icecap360/DroneCapstone/src/README.md

# ParkingLotHawk Source Code

The source code is split into 5 main sections:
- CAD/ : contains CAD models of the Drone
- DroneApp/ : contains code that will be run locally on the Drone
- OperatorApp/ : contains code that will be run on the Operator's PC
- SITL/ : contains setup of Software in the Loop environment to faciliate testing of the program
- Utils/ : contains common code used by multiple folders (such as DroneApp and OperatorApp)  

A detailed module guide can be found within the [Repository File Guide](https://github.com/icecap360/DroneCapstone/blob/master/RepositoryFileGuide.pdf).
