icecap360/DroneCapstone/src/CAD/README.md

# CAD

This folder contains all the CAD files used to design and fabricate the frame of the drone.  

CAD software used: Solidworks 2019
