icecap360/DroneCapstone/refs/README.md

# ParkingLotHawk: Reference Information

This folder holds information and resources of interest for the project.  This
is intended to be a convenient location for project members to access
support material for the project.

For LaTeX files references are put in the References.bib file for processing by
BibTeX.  A nice convention for naming the references is to use the Nat Bib
convention.  That is, the citation name, and the corresponding file name should
be in the format AuthorYear.  If there is two author's the name should be
Author1Author2Year.  For more than two authors, the name should be
Author1EtAlYear.  In the preceding text, Author, Author1 and Author2 are the
last names of the authors.
