icecap360/DroneCapstone/docs/Design/SoftDetailedDes/MIS.pdf

## Module Interface Specification for Mechatronics Engineering

Team # 34, ParkingLotHawk
Fady Zekry Hanna
Winnie Trandinh
Muhammad Ali
Muhammad Khan

April 6, 2023

## 1 Revision History

Date | Version | Notes
January 18, 2023 1.0 | Initial Revision
April 5, 2023 | 2.0 | Updating topic interfaces for new topics, split the process methods into process and publish, and updated camera modules for new interface.

i

## 2 Symbols, Abbreviations and Acronyms

symbol | description
AC | Anticipated Change
DAG | Directed Acyclic Graph
M | Module
MG | Module Guide
MIS | Module Interface Specifications
OS | Operating System
R | Requirement
Algo | Algorithms
SRS | Software Requirements Specification
Mechatronics
Engineering
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
