icecap360/DroneCapstone/docs/Design/SystDesign/CamOcc.png

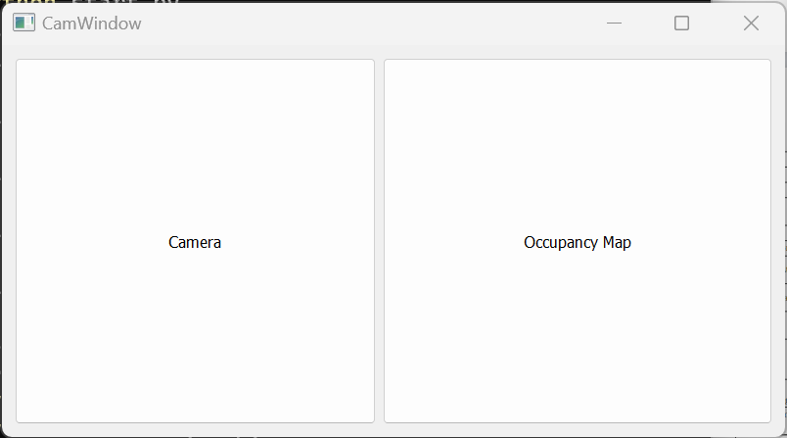
docs/Design/SystDesign/CamOcc.png
