icecap360/DroneCapstone/docs/VnVReport/SegmentationShadow.png

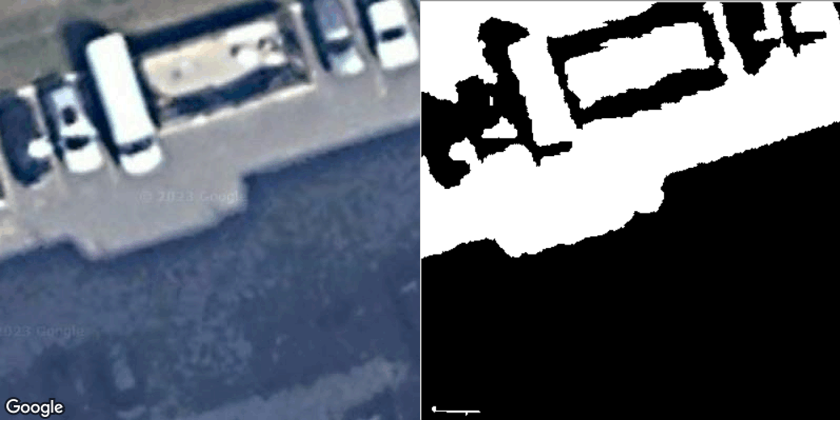
docs/VnVReport/SegmentationShadow.png
