icecap360/DroneCapstone/src/CAD/FlightControllerAssembly.SLDASM

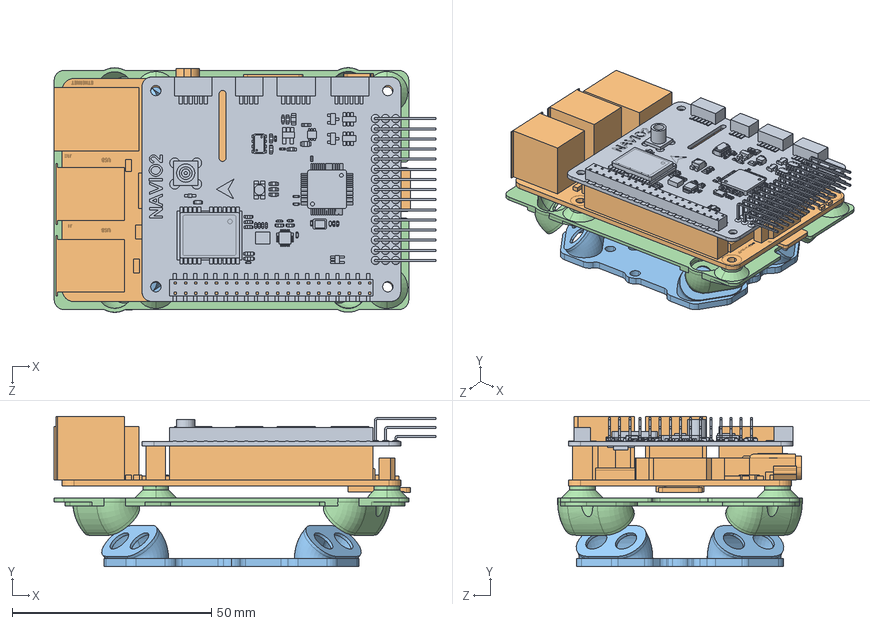
[picture p52: CAD file, 2022-10-10]
src/CAD/FlightControllerAssembly.SLDASM
95.8 x 37.7 x 61.4 mm
Navio2
RPi3B+
VibroNavio2bot_rev_A
VibroNavio2top_rev_A
