icecap360/DroneCapstone/src/CAD/VibroNavio2top_rev_A.SLDPRT

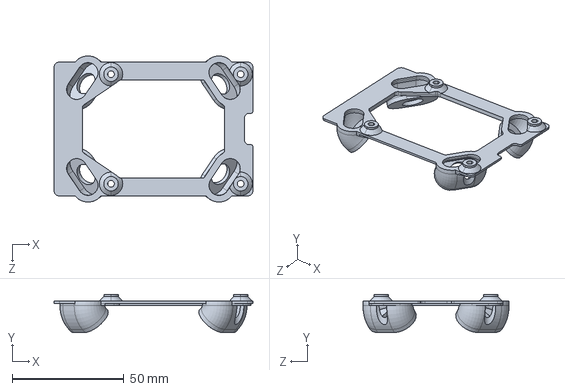
[picture p53: CAD file, 2023-04-05]
src/CAD/VibroNavio2top_rev_A.SLDPRT
89.0 x 17.0 x 65.4 mm
