icecap360/DroneCapstone/src/CAD/Camera.SLDPRT

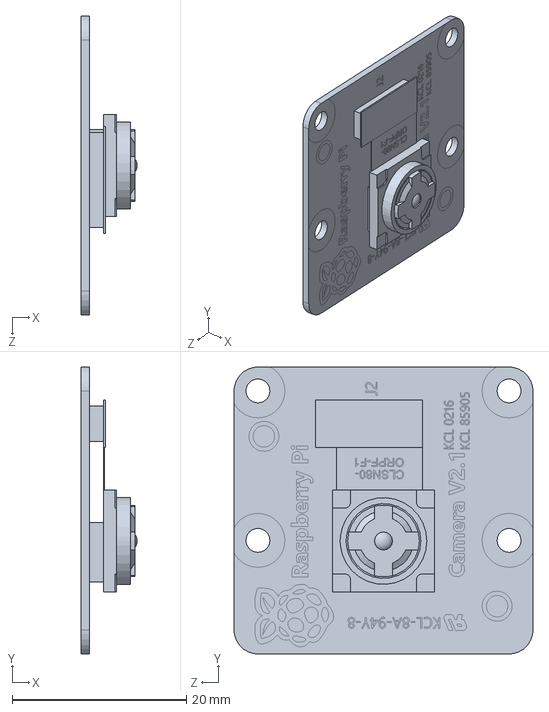
[picture p54: CAD file, 2023-04-05]
src/CAD/Camera.SLDPRT
6.45 x 32.9 x 34.3 mm
