icecap360/DroneCapstone/src/CAD/Mast.SLDPRT

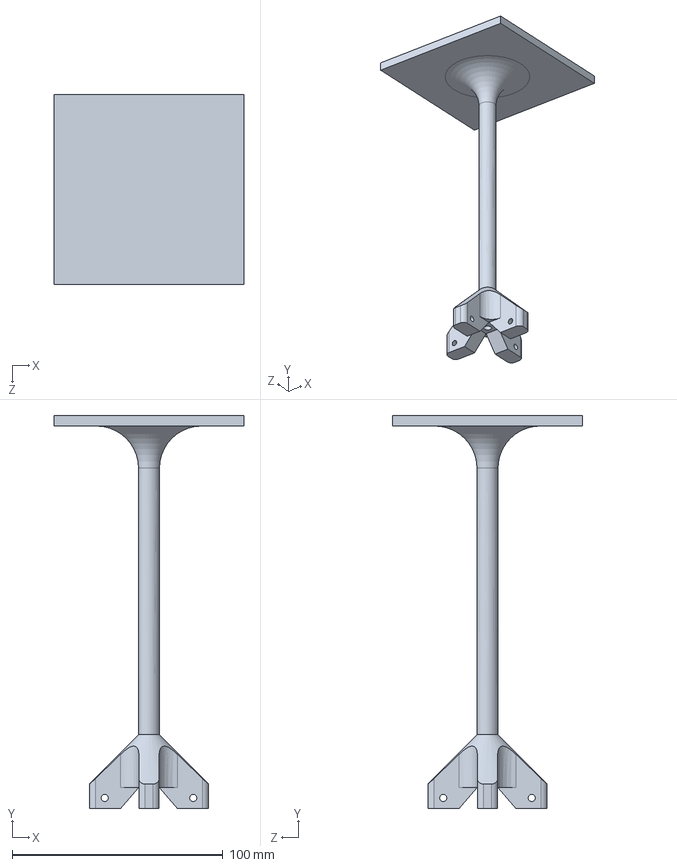
[picture p55: CAD file, 2023-04-05]
src/CAD/Mast.SLDPRT
90.0 x 186.5 x 90.0 mm
