icecap360/DroneCapstone/src/CAD/TopCover.SLDPRT

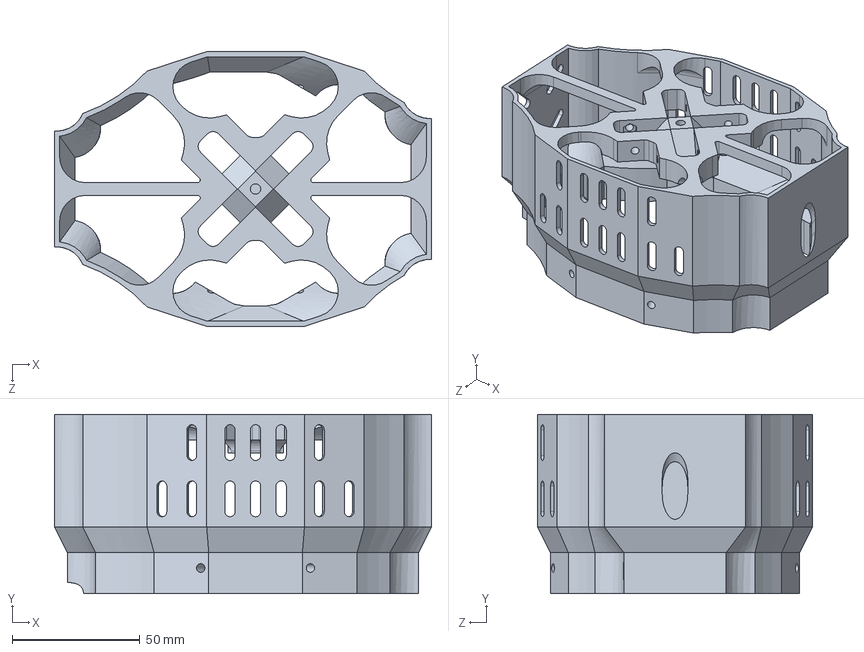
[picture p56: CAD file, 2023-04-05]
src/CAD/TopCover.SLDPRT
147.3 x 70.0 x 107.3 mm
