icecap360/DroneCapstone/src/CAD/FrameArm.SLDPRT

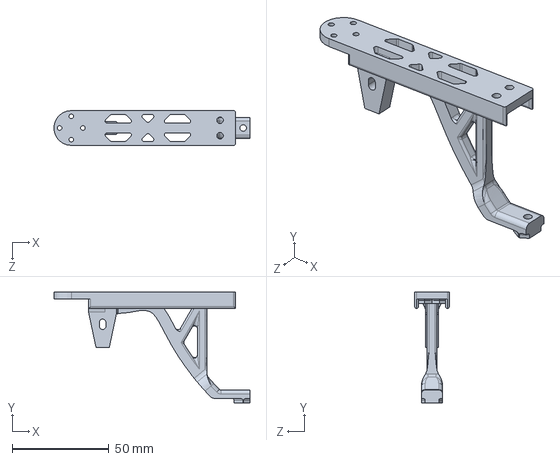
[picture p57: CAD file, 2023-04-05]
src/CAD/FrameArm.SLDPRT
101.4 x 57.4 x 18.0 mm
