icecap360/DroneCapstone/src/CAD/TopPlate.SLDPRT

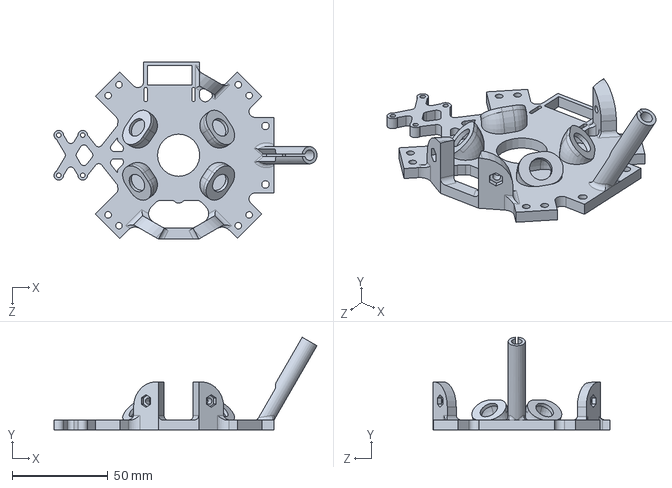
[picture p58: CAD file, 2023-04-05]
src/CAD/TopPlate.SLDPRT
137.1 x 48.3 x 92.4 mm
