icecap360/DroneCapstone/src/CAD/BottomPlate.SLDPRT

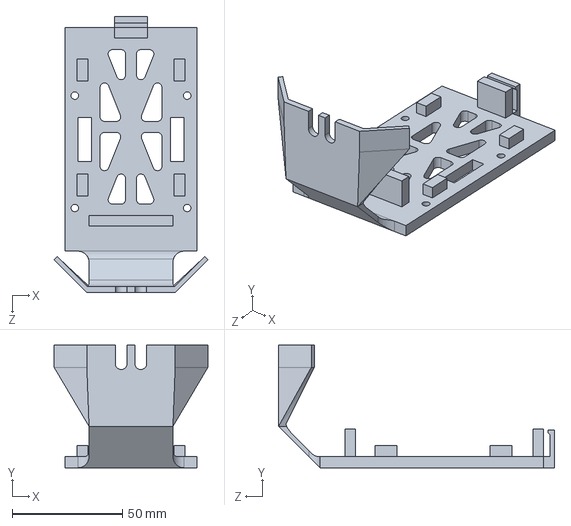
[picture p59: CAD file, 2023-04-05]
src/CAD/BottomPlate.SLDPRT
69.7 x 55.5 x 125.0 mm
