icecap360/DroneCapstone/src/CAD/CameraMount.SLDPRT

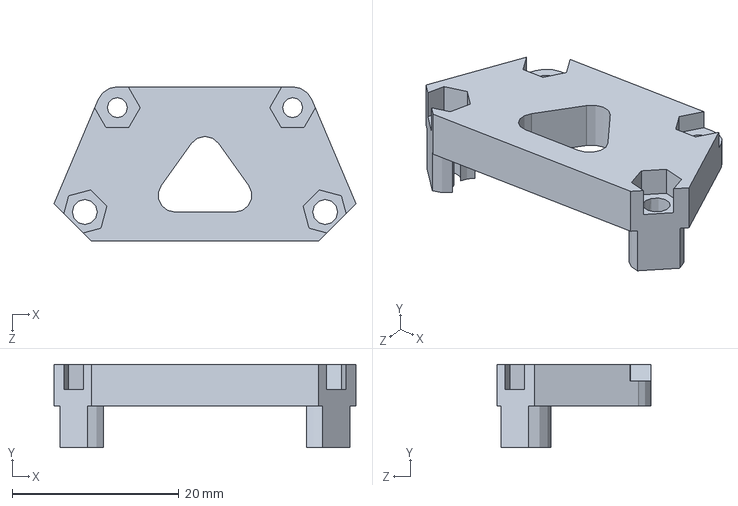
[picture p60: CAD file, 2023-04-05]
src/CAD/CameraMount.SLDPRT
36.2 x 10.0 x 18.5 mm
