icecap360/DroneCapstone/src/CAD/LandingLeg.SLDPRT

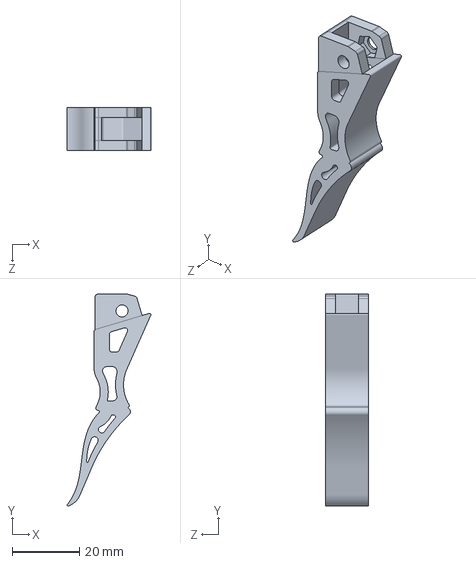
[picture p61: CAD file, 2023-04-05]
src/CAD/LandingLeg.SLDPRT
25.0 x 63.2 x 12.8 mm
