icecap360/DroneCapstone/src/CAD/Antenna.SLDPRT

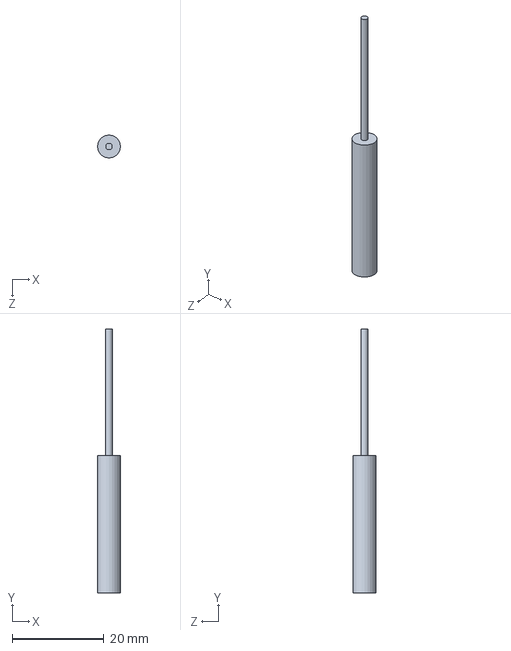
[picture p62: CAD file, 2023-03-20]
src/CAD/Antenna.SLDPRT
5.00 x 57.5 x 5.00 mm
