icecap360/DroneCapstone/src/CAD/Propellor5.1x3.4x3.SLDPRT

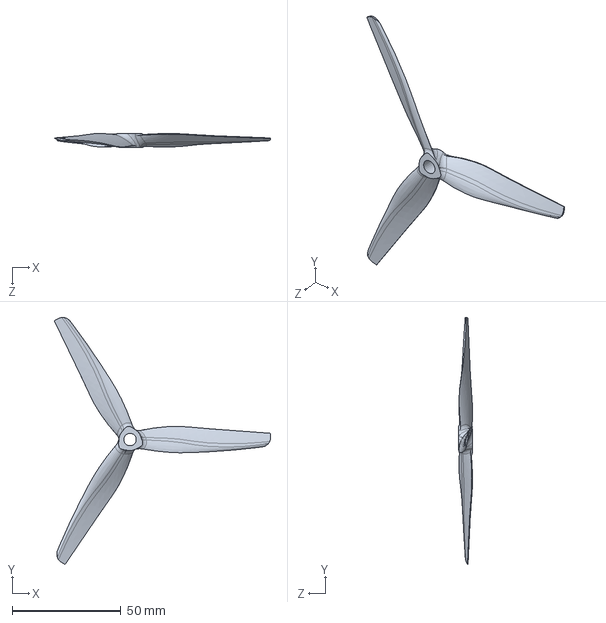
[picture p63: CAD file, 2023-03-20]
src/CAD/Propellor5.1x3.4x3.SLDPRT
99.6 x 113.7 x 6.40 mm
