icecap360/DroneCapstone/src/CAD/Esc.SLDPRT

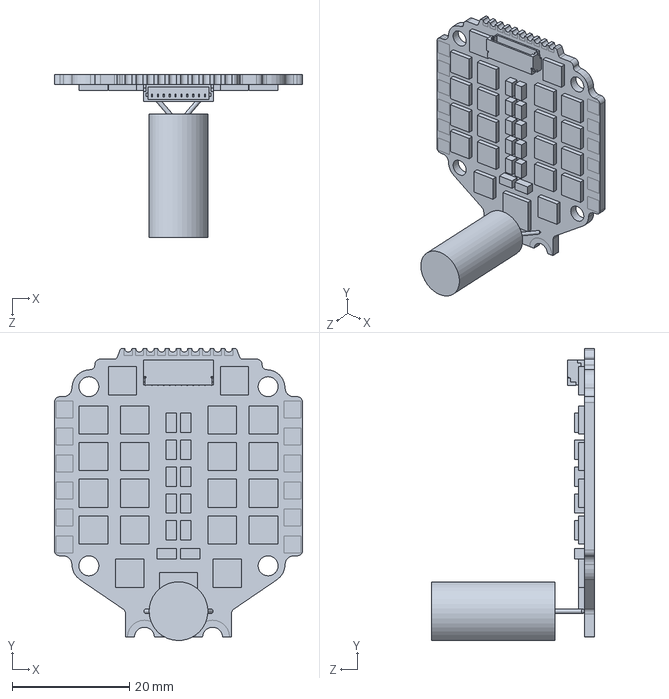
[picture p64: CAD file, 2023-03-20]
src/CAD/Esc.SLDPRT
42.3 x 49.7 x 27.7 mm
