icecap360/DroneCapstone/src/CAD/DampeningBall.SLDPRT

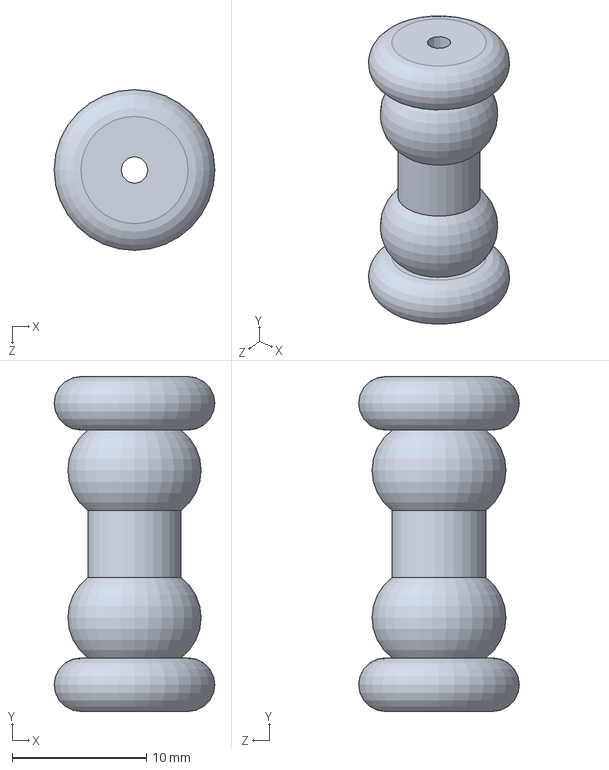
[picture p65: CAD file, 2023-03-20]
src/CAD/DampeningBall.SLDPRT
12.0 x 25.0 x 12.0 mm
