icecap360/DroneCapstone/src/CAD/GPS.SLDPRT

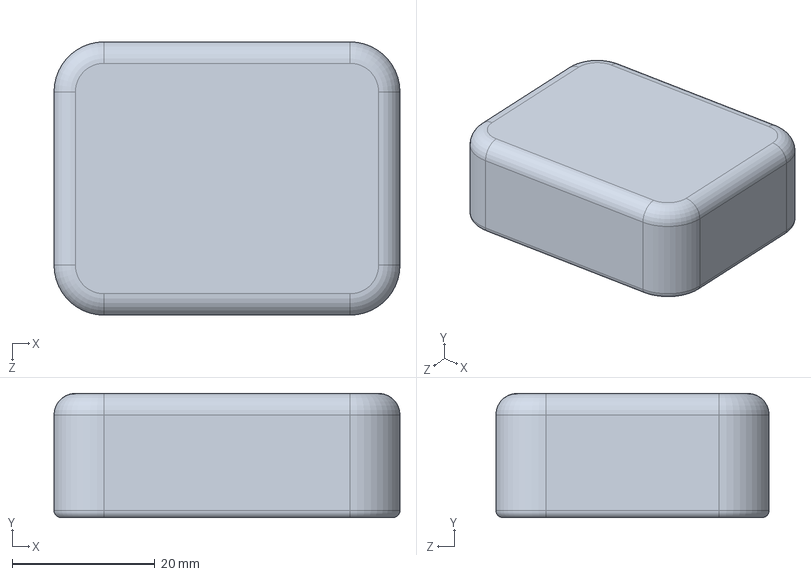
[picture p66: CAD file, 2023-03-20]
src/CAD/GPS.SLDPRT
48.5 x 17.4 x 38.3 mm
