icecap360/DroneCapstone/src/CAD/Spacer.SLDPRT

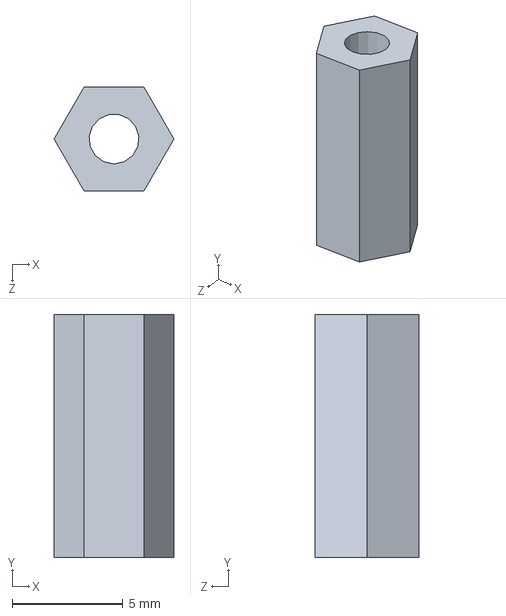
[picture p67: CAD file, 2023-03-20]
src/CAD/Spacer.SLDPRT
5.40 x 10.9 x 4.68 mm
