icecap360/DroneCapstone/src/CAD/RadioReceiver.SLDPRT

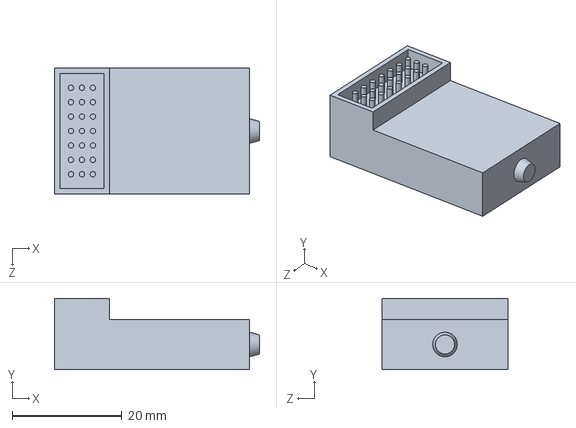
[picture p68: CAD file, 2023-03-20]
src/CAD/RadioReceiver.SLDPRT
37.4 x 13.0 x 23.0 mm
