icecap360/DroneCapstone/src/CAD/SteelRod.SLDPRT

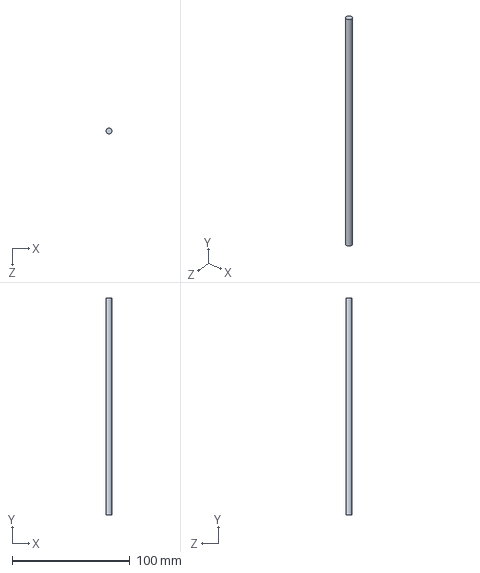
[picture p69: CAD file, 2023-03-20]
src/CAD/SteelRod.SLDPRT
5.00 x 184.5 x 5.00 mm
