icecap360/DroneCapstone/src/CAD/LiPoBattery.SLDPRT

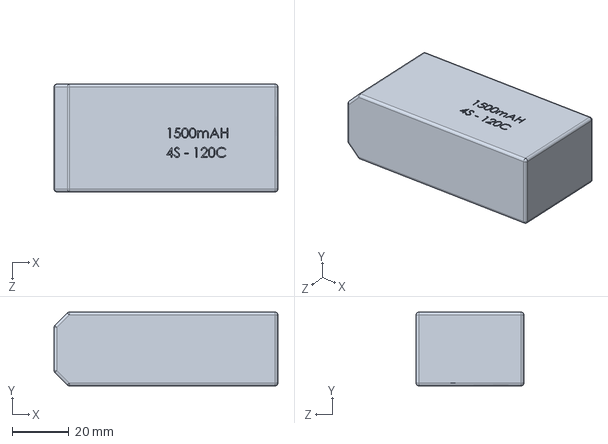
[picture p70: CAD file, 2023-03-20]
src/CAD/LiPoBattery.SLDPRT
79.0 x 26.0 x 38.0 mm
