icecap360/DroneCapstone/src/CAD/VibroNavio2bot_rev_A.SLDPRT

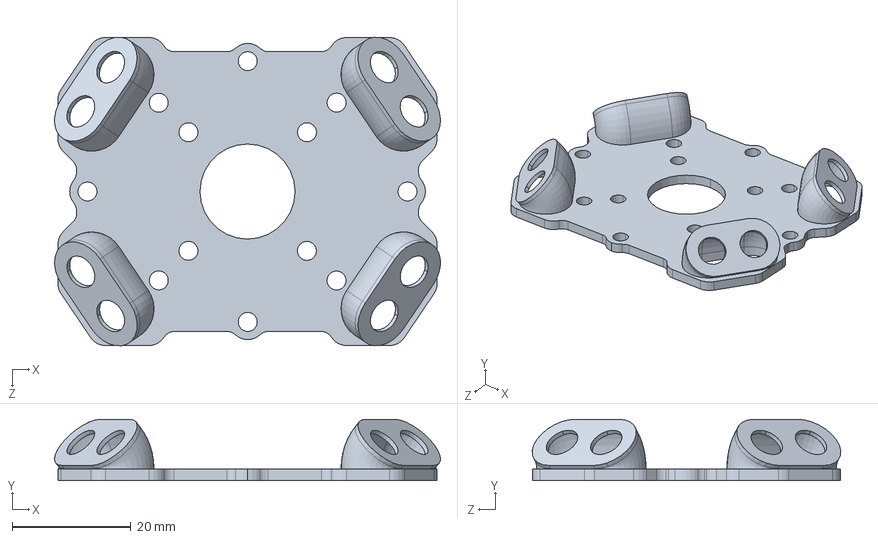
[picture p71: CAD file, 2022-10-11]
src/CAD/VibroNavio2bot_rev_A.SLDPRT
65.1 x 10.4 x 52.1 mm
