icecap360/DroneCapstone/docs/UserManual/README.md

# User Manual

The folders and files for this folder are as follows:

Describe ...
