icecap360/DroneCapstone/test/README.md

# Automated tests

This folder contains testing code during development, in addition to Unit Tests and the KPI Generation Tool.  
Further information on these tests can be found within the VnVPlan document.
