icecap360/DroneCapstone/test/ComputerVision/SegmenterAccuracy.csv

Image Name | Type | Acc | Prec | Rec
ParkingLot08 | Park Lot | 0.2780908203125 | 0.0 | 0.0
