icecap360/DroneCapstone/test/ComputerVision/AnnotationPublicDataset/1Drone-Overcast-MedAlt-Occupied-AnnotNAT.jpg

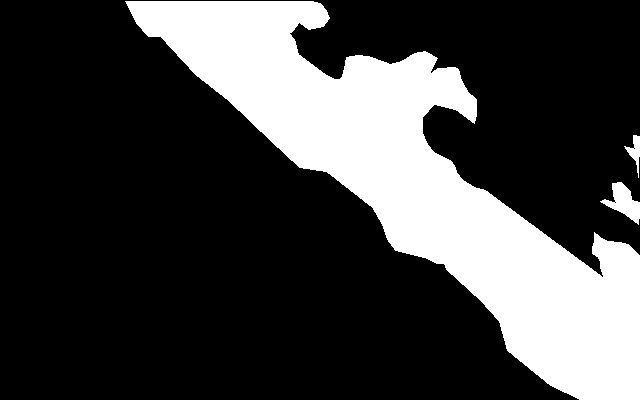
test/ComputerVision/AnnotationPublicDataset/1Drone-Overcast-MedAlt-Occupied-AnnotNAT.jpg
