icecap360/DroneCapstone/test/ComputerVision/AnnotationPublicDataset/1Drone-Overcast-MedAlt-Occupied-AnnotPRK.jpg

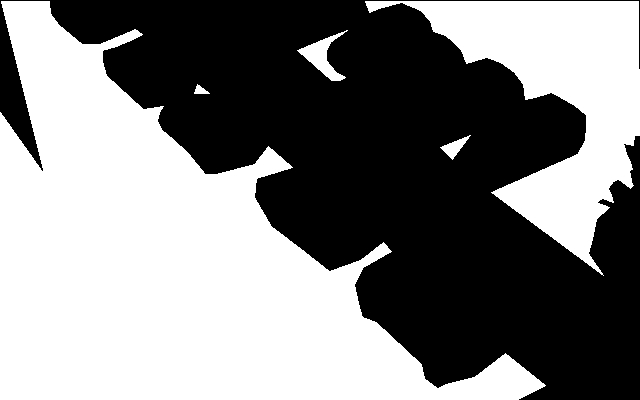
test/ComputerVision/AnnotationPublicDataset/1Drone-Overcast-MedAlt-Occupied-AnnotPRK.jpg
