icecap360/DroneCapstone/test/ComputerVision/AnnotationPublicDataset/4Drone-Overcast-MedAlt-ParkLot-AnnotNAT.jpg

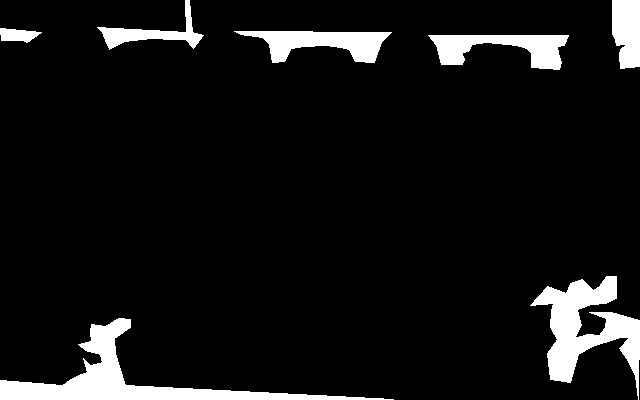
test/ComputerVision/AnnotationPublicDataset/4Drone-Overcast-MedAlt-ParkLot-AnnotNAT.jpg
