icecap360/DroneCapstone/test/ComputerVision/AnnotationPublicDataset/4Drone-Overcast-MedAlt-ParkLot-AnnotPRK.jpg

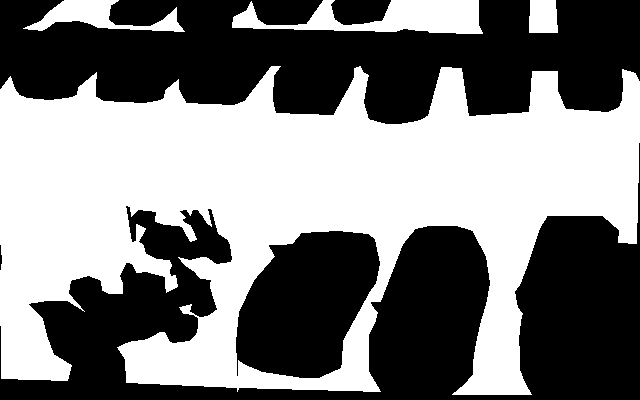
test/ComputerVision/AnnotationPublicDataset/4Drone-Overcast-MedAlt-ParkLot-AnnotPRK.jpg
