icecap360/DroneCapstone/test/ComputerVision/AnnotationPublicDataset/4Drone-Sunny-MedAlt-Nature-AnnotNAT.jpg

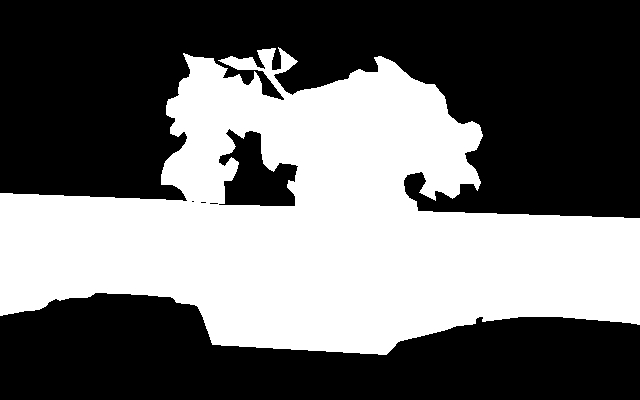
test/ComputerVision/AnnotationPublicDataset/4Drone-Sunny-MedAlt-Nature-AnnotNAT.jpg
