icecap360/DroneCapstone/test/ComputerVision/AnnotationPublicDataset/4Drone-Sunny-MedAlt-Nature-AnnotPRK.jpg

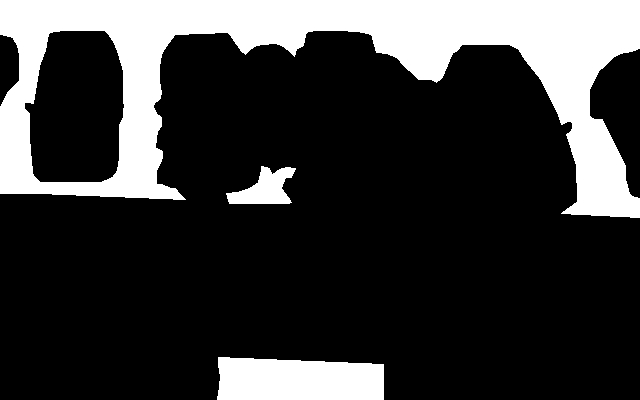
test/ComputerVision/AnnotationPublicDataset/4Drone-Sunny-MedAlt-Nature-AnnotPRK.jpg
