icecap360/DroneCapstone/test/ComputerVision/AnnotationPublicDataset/4Drone-Sunny-MedAlt-Occupied-AnnotNAT.jpg

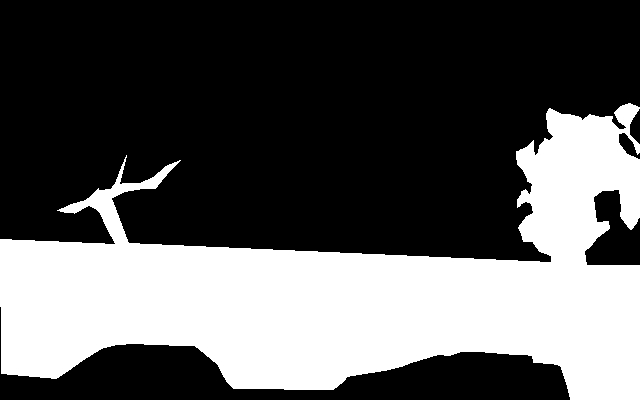
test/ComputerVision/AnnotationPublicDataset/4Drone-Sunny-MedAlt-Occupied-AnnotNAT.jpg
