icecap360/DroneCapstone/test/ComputerVision/AnnotationPublicDataset/4Drone-Sunny-MedAlt-Occupied-AnnotPRK.jpg

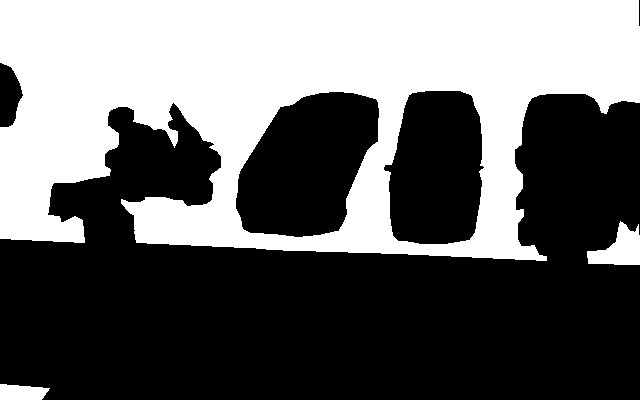
test/ComputerVision/AnnotationPublicDataset/4Drone-Sunny-MedAlt-Occupied-AnnotPRK.jpg
