icecap360/DroneCapstone/test/ComputerVision/AnnotationPublicDataset/4Drone-Sunny-MedAlt-ParkLot1-AnnotNAT.jpg

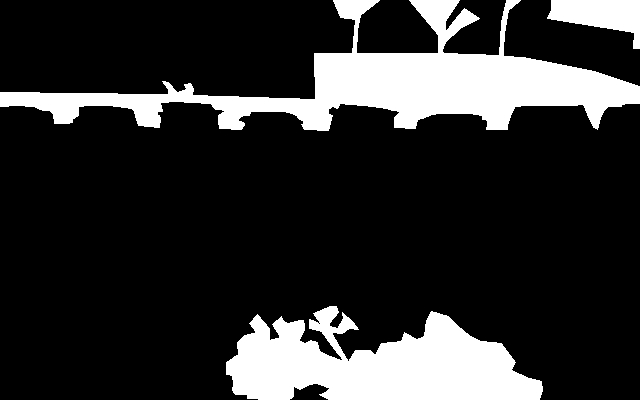
test/ComputerVision/AnnotationPublicDataset/4Drone-Sunny-MedAlt-ParkLot1-AnnotNAT.jpg
