icecap360/DroneCapstone/test/ComputerVision/AnnotationPublicDataset/4Drone-Sunny-MedAlt-ParkLot-AnnotPRK.jpg

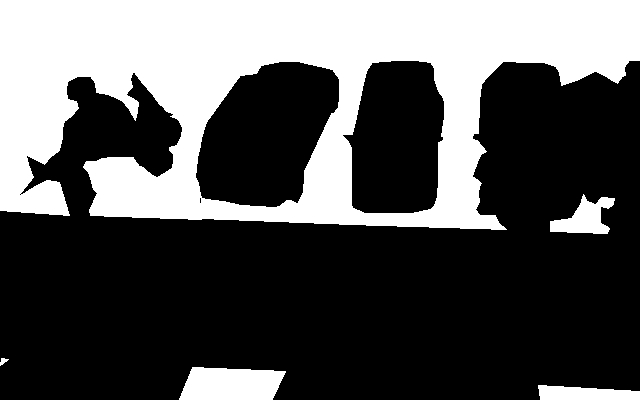
test/ComputerVision/AnnotationPublicDataset/4Drone-Sunny-MedAlt-ParkLot-AnnotPRK.jpg
