icecap360/DroneCapstone/test/ComputerVision/AnnotationPublicDataset/5Drone-Overcast-MedAlt-Nature-AnnotNAT.jpg

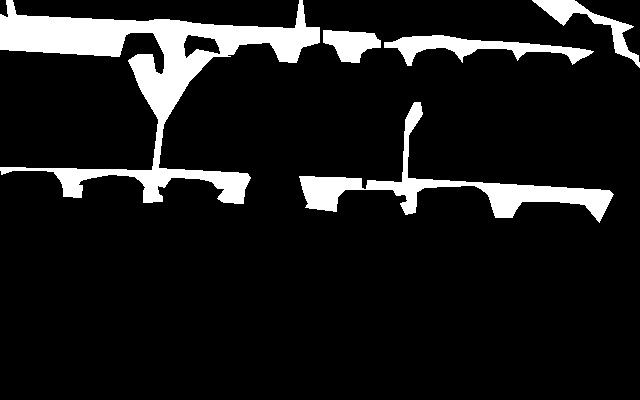
test/ComputerVision/AnnotationPublicDataset/5Drone-Overcast-MedAlt-Nature-AnnotNAT.jpg
