icecap360/DroneCapstone/test/ComputerVision/AnnotationPublicDataset/5Drone-Overcast-MedAlt-Nature-AnnotPRK.jpg

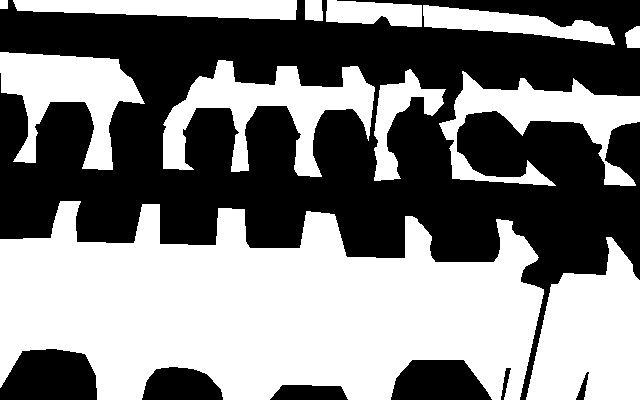
test/ComputerVision/AnnotationPublicDataset/5Drone-Overcast-MedAlt-Nature-AnnotPRK.jpg
