icecap360/DroneCapstone/test/ComputerVision/AnnotationPublicDataset/5Drone-Overcast-MedAlt-Occupied-AnnotNAT.jpg

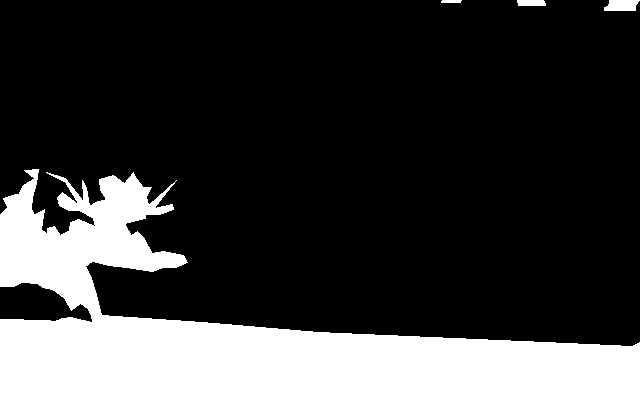
test/ComputerVision/AnnotationPublicDataset/5Drone-Overcast-MedAlt-Occupied-AnnotNAT.jpg
