icecap360/DroneCapstone/test/ComputerVision/AnnotationPublicDataset/5Drone-Overcast-MedAlt-Occupied-AnnotPRK.jpg

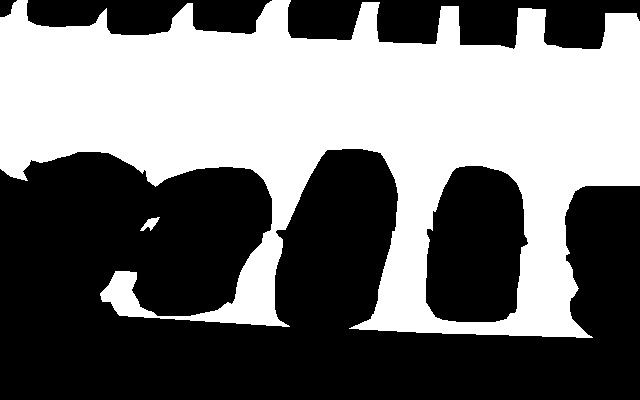
test/ComputerVision/AnnotationPublicDataset/5Drone-Overcast-MedAlt-Occupied-AnnotPRK.jpg
