icecap360/DroneCapstone/test/ComputerVision/AnnotationPublicDataset/5Drone-Overcast-MedAlt-ParkLot-AnnotNAT.jpg

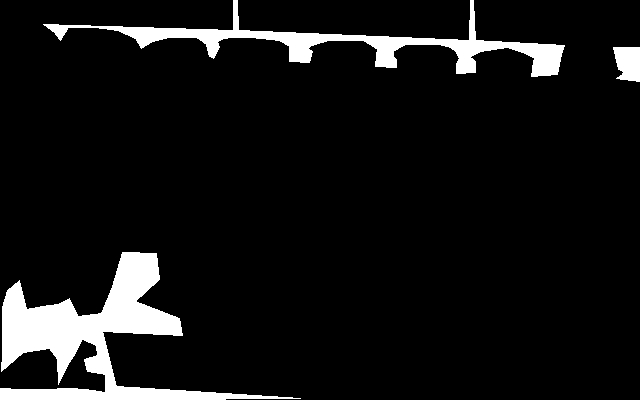
test/ComputerVision/AnnotationPublicDataset/5Drone-Overcast-MedAlt-ParkLot-AnnotNAT.jpg
