icecap360/DroneCapstone/test/ComputerVision/AnnotationPublicDataset/5Drone-Overcast-MedAlt-ParkLot-AnnotPRK.jpg

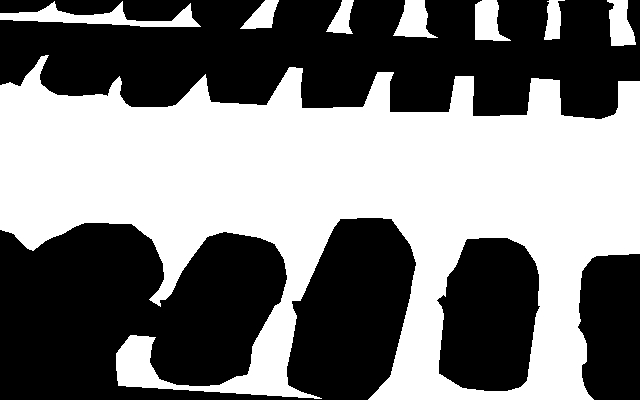
test/ComputerVision/AnnotationPublicDataset/5Drone-Overcast-MedAlt-ParkLot-AnnotPRK.jpg
