icecap360/DroneCapstone/test/ComputerVision/AnnotationPublicDataset/5Drone-Sunny-MedAlt-Nature-AnnotNAT.jpg

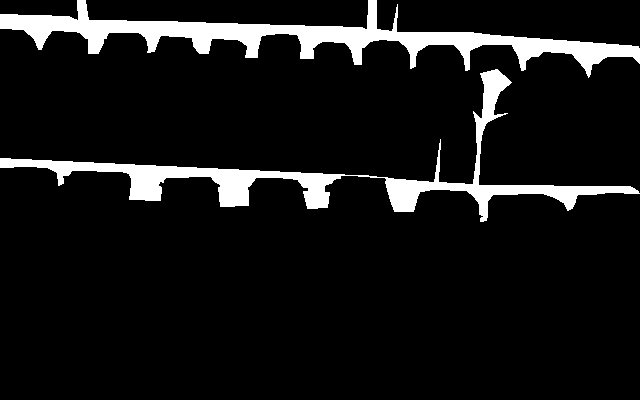
test/ComputerVision/AnnotationPublicDataset/5Drone-Sunny-MedAlt-Nature-AnnotNAT.jpg
