icecap360/DroneCapstone/test/ComputerVision/AnnotationPublicDataset/5Drone-Sunny-MedAlt-Nature-AnnotPRK.jpg

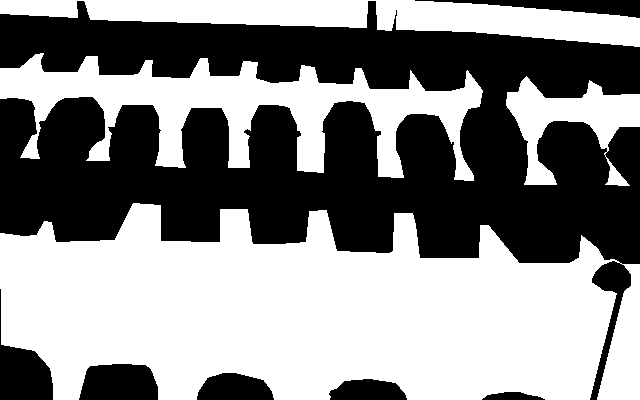
test/ComputerVision/AnnotationPublicDataset/5Drone-Sunny-MedAlt-Nature-AnnotPRK.jpg
