icecap360/DroneCapstone/test/ComputerVision/AnnotationPublicDataset/5Drone-Sunny-MedAlt-Occupied-AnnotNAT.jpg

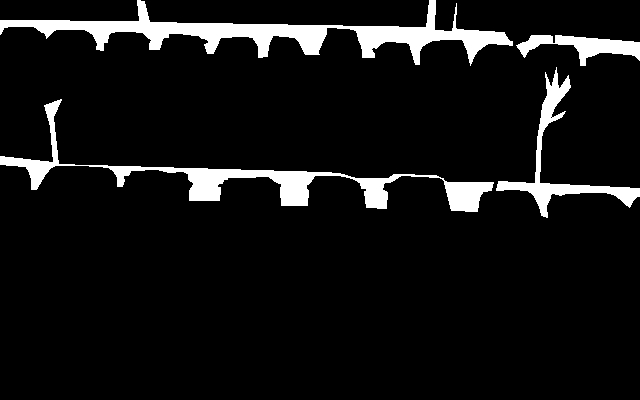
test/ComputerVision/AnnotationPublicDataset/5Drone-Sunny-MedAlt-Occupied-AnnotNAT.jpg
