icecap360/DroneCapstone/test/ComputerVision/AnnotationPublicDataset/5Drone-Sunny-MedAlt-Occupied-AnnotPRK.jpg

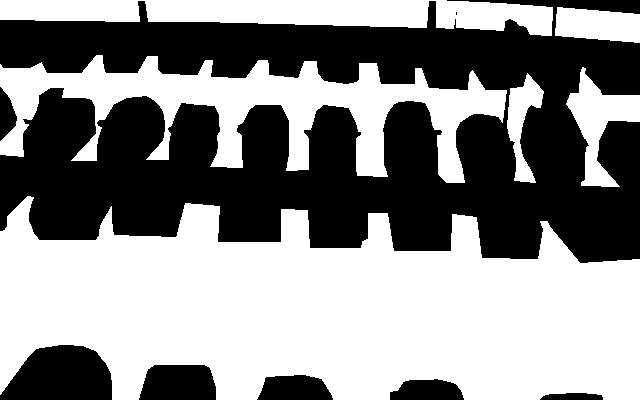
test/ComputerVision/AnnotationPublicDataset/5Drone-Sunny-MedAlt-Occupied-AnnotPRK.jpg
