icecap360/DroneCapstone/test/ComputerVision/AnnotationPublicDataset/5Drone-Sunny-MedAlt-ParkLot-AnnotNAT.jpg

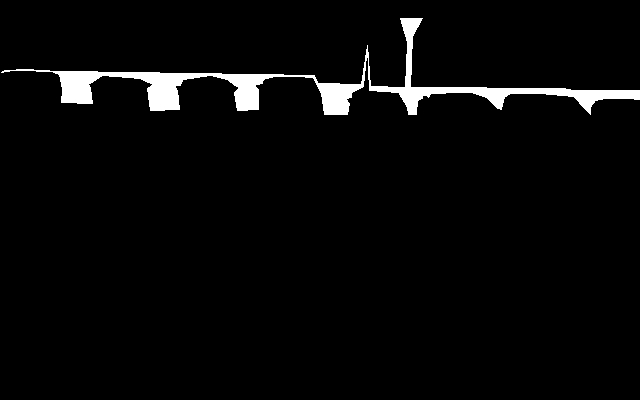
test/ComputerVision/AnnotationPublicDataset/5Drone-Sunny-MedAlt-ParkLot-AnnotNAT.jpg
