icecap360/DroneCapstone/test/ComputerVision/AnnotationPublicDataset/5Drone-Sunny-MedAlt-ParkLot-AnnotPRK.jpg

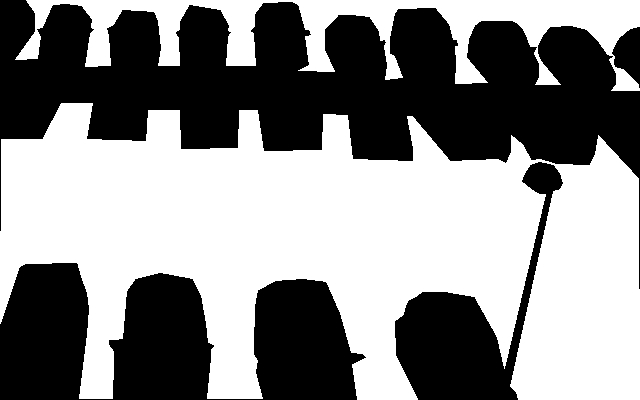
test/ComputerVision/AnnotationPublicDataset/5Drone-Sunny-MedAlt-ParkLot-AnnotPRK.jpg
