icecap360/DroneCapstone/test/ComputerVision/AnnotationPublicDataset/6Drone-Overcast-MedAlt-Nature-AnnotNAT.jpg

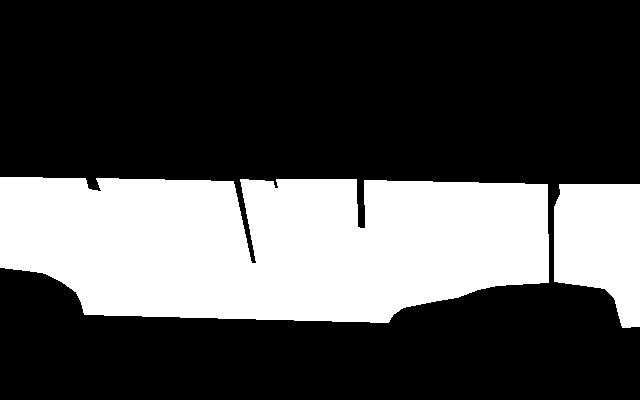
test/ComputerVision/AnnotationPublicDataset/6Drone-Overcast-MedAlt-Nature-AnnotNAT.jpg
