icecap360/DroneCapstone/test/ComputerVision/AnnotationPublicDataset/6Drone-Overcast-MedAlt-Nature-AnnotPRK.jpg

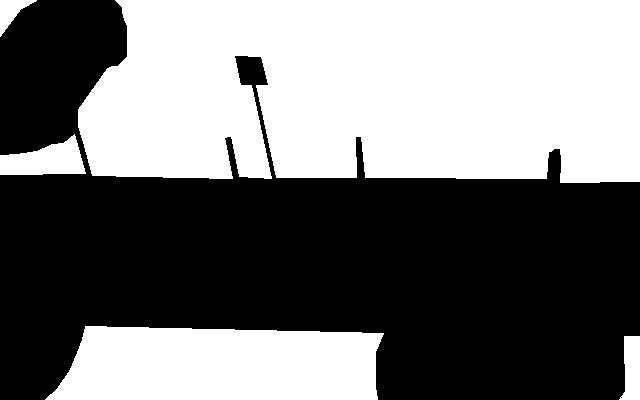
test/ComputerVision/AnnotationPublicDataset/6Drone-Overcast-MedAlt-Nature-AnnotPRK.jpg
