icecap360/DroneCapstone/test/ComputerVision/AnnotationPublicDataset/6Drone-Overcast-MedAlt-Occupied1-AnnotPRK.jpg

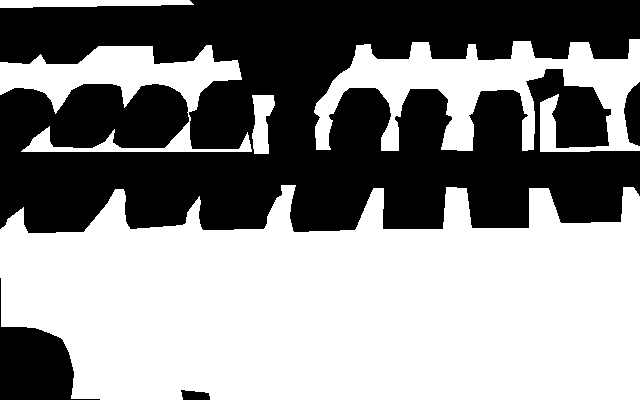
test/ComputerVision/AnnotationPublicDataset/6Drone-Overcast-MedAlt-Occupied1-AnnotPRK.jpg
