icecap360/DroneCapstone/test/ComputerVision/AnnotationPublicDataset/6Drone-Overcast-MedAlt-Occupied-AnnotNAT.jpg

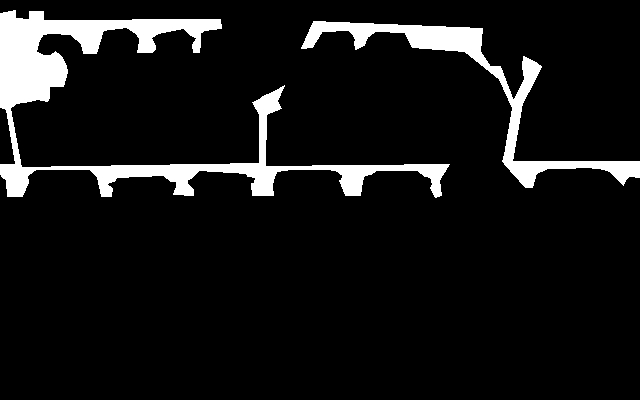
test/ComputerVision/AnnotationPublicDataset/6Drone-Overcast-MedAlt-Occupied-AnnotNAT.jpg
