icecap360/DroneCapstone/test/ComputerVision/AnnotationPublicDataset/6Drone-Overcast-MedAlt-Occupied-AnnotPRK.jpg

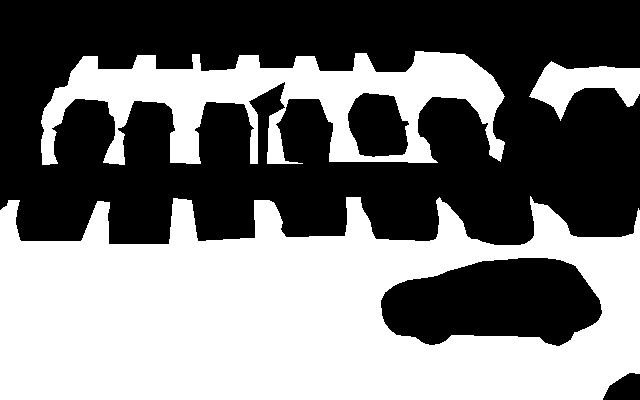
test/ComputerVision/AnnotationPublicDataset/6Drone-Overcast-MedAlt-Occupied-AnnotPRK.jpg
