icecap360/DroneCapstone/test/ComputerVision/AnnotationPublicDataset/6Drone-Overcast-MedAlt-ParkLot-AnnotNAT.jpg

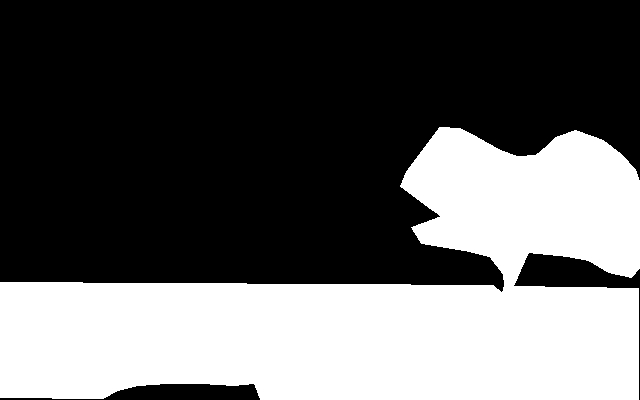
test/ComputerVision/AnnotationPublicDataset/6Drone-Overcast-MedAlt-ParkLot-AnnotNAT.jpg
