icecap360/DroneCapstone/test/ComputerVision/AnnotationPublicDataset/6Drone-Overcast-MedAlt-ParkLot-AnnotPRK.jpg

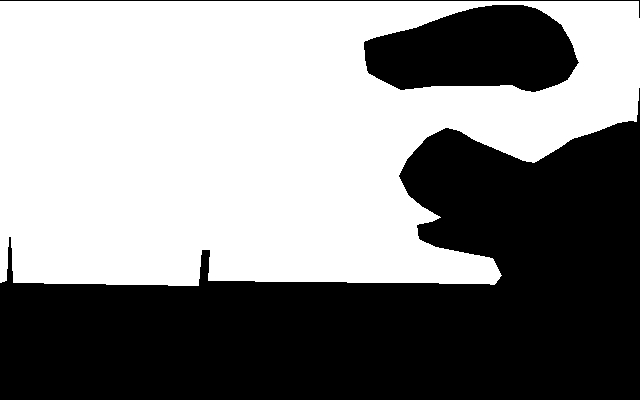
test/ComputerVision/AnnotationPublicDataset/6Drone-Overcast-MedAlt-ParkLot-AnnotPRK.jpg
