icecap360/DroneCapstone/test/ComputerVision/AnnotationPublicDataset/6Drone-Sunny-MedAlt-Nature-AnnotNAT.jpg

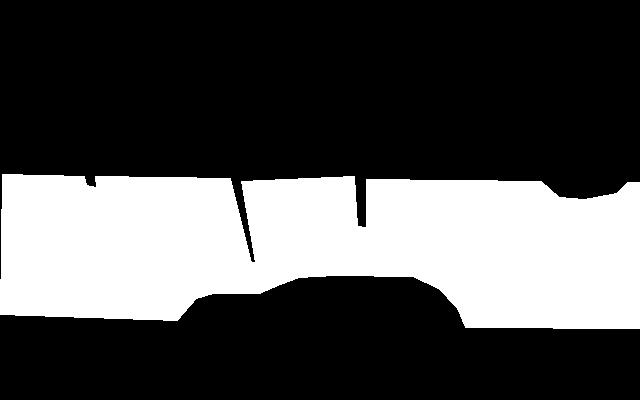
test/ComputerVision/AnnotationPublicDataset/6Drone-Sunny-MedAlt-Nature-AnnotNAT.jpg
