icecap360/DroneCapstone/test/ComputerVision/AnnotationPublicDataset/6Drone-Sunny-MedAlt-Nature-AnnotPRK.jpg

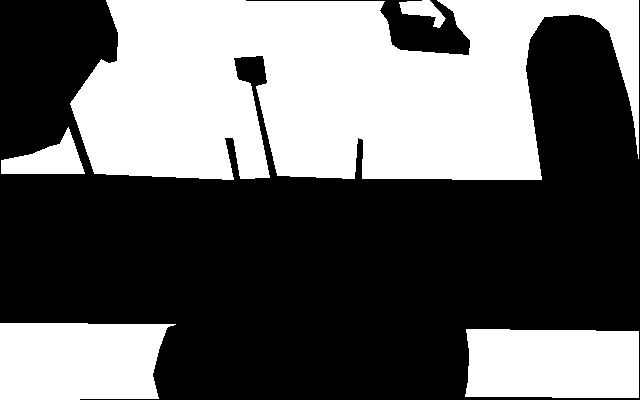
test/ComputerVision/AnnotationPublicDataset/6Drone-Sunny-MedAlt-Nature-AnnotPRK.jpg
