icecap360/DroneCapstone/test/ComputerVision/AnnotationPublicDataset/6Drone-Sunny-MedAlt-Occupied-AnnotNAT.jpg

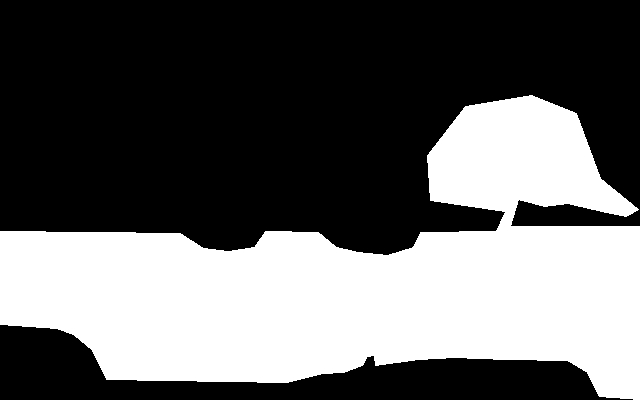
test/ComputerVision/AnnotationPublicDataset/6Drone-Sunny-MedAlt-Occupied-AnnotNAT.jpg
