icecap360/DroneCapstone/test/ComputerVision/AnnotationPublicDataset/6Drone-Sunny-MedAlt-Occupied-AnnotPRK.jpg

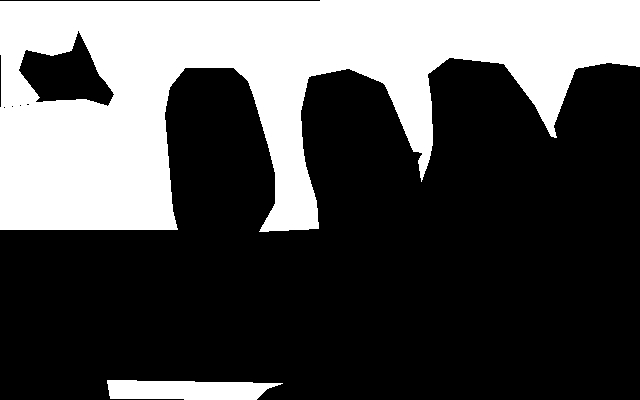
test/ComputerVision/AnnotationPublicDataset/6Drone-Sunny-MedAlt-Occupied-AnnotPRK.jpg
