icecap360/DroneCapstone/test/ComputerVision/AnnotationPublicDataset/6Drone-Sunny-MedAlt-ParkLot-AnnotNAT.jpg

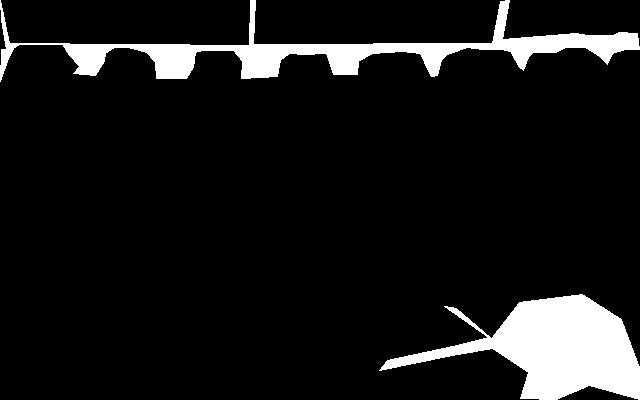
test/ComputerVision/AnnotationPublicDataset/6Drone-Sunny-MedAlt-ParkLot-AnnotNAT.jpg
