icecap360/DroneCapstone/test/ComputerVision/AnnotationPublicDataset/7Drone-Overcast-MedAlt-Nature-AnnotNAT.jpg

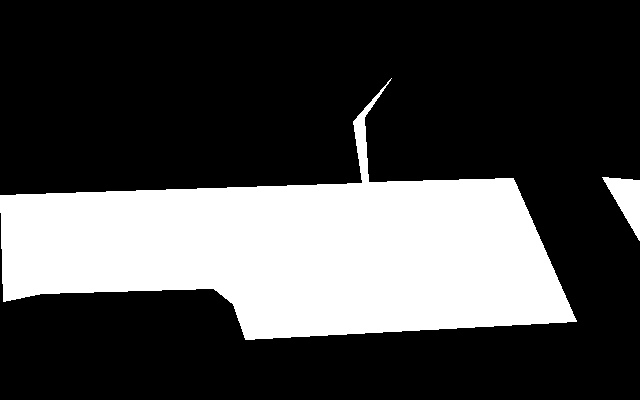
test/ComputerVision/AnnotationPublicDataset/7Drone-Overcast-MedAlt-Nature-AnnotNAT.jpg
