icecap360/DroneCapstone/test/ComputerVision/AnnotationPublicDataset/7Drone-Overcast-MedAlt-Nature-AnnotPRK.jpg

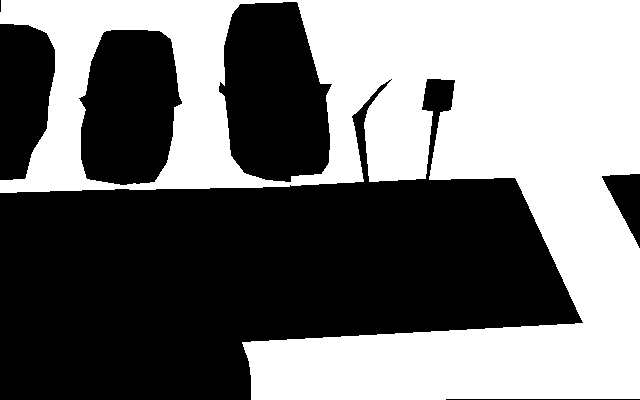
test/ComputerVision/AnnotationPublicDataset/7Drone-Overcast-MedAlt-Nature-AnnotPRK.jpg
