icecap360/DroneCapstone/test/ComputerVision/AnnotationPublicDataset/7Drone-Overcast-MedAlt-Occupied2-AnnotPRK.jpg

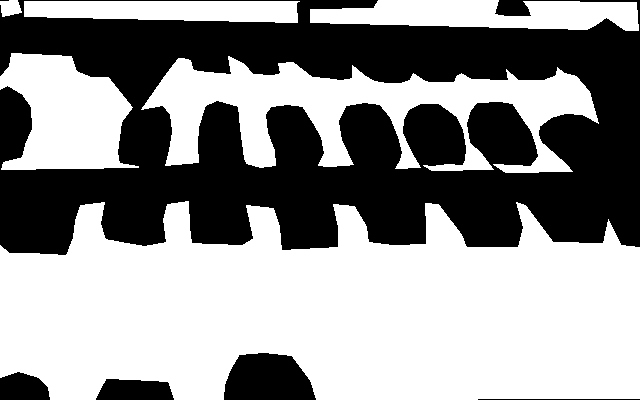
test/ComputerVision/AnnotationPublicDataset/7Drone-Overcast-MedAlt-Occupied2-AnnotPRK.jpg
