icecap360/DroneCapstone/test/ComputerVision/AnnotationPublicDataset/7Drone-Sunny-MedAlt-Nature-AnnotNAT.jpg

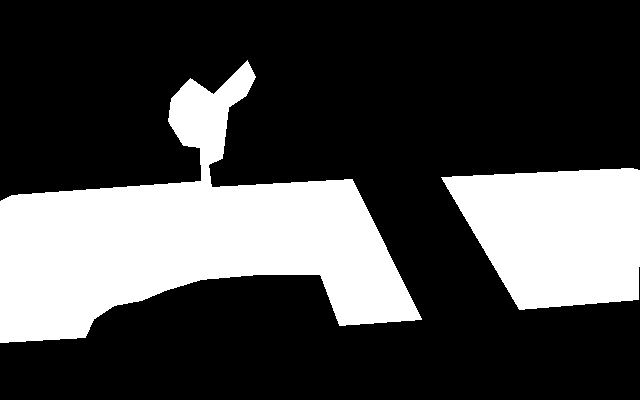
test/ComputerVision/AnnotationPublicDataset/7Drone-Sunny-MedAlt-Nature-AnnotNAT.jpg
