icecap360/DroneCapstone/test/ComputerVision/AnnotationPublicDataset/7Drone-Sunny-MedAlt-Nature-AnnotPRK.jpg

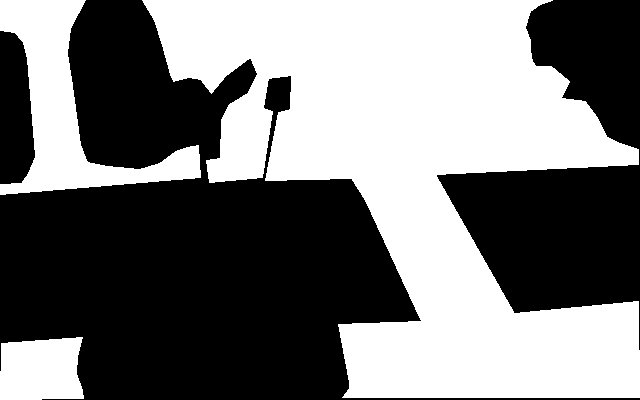
test/ComputerVision/AnnotationPublicDataset/7Drone-Sunny-MedAlt-Nature-AnnotPRK.jpg
