icecap360/DroneCapstone/test/ComputerVision/AnnotationPublicDataset/7Drone-Sunny-MedAlt-Occupied-AnnotNAT.jpg

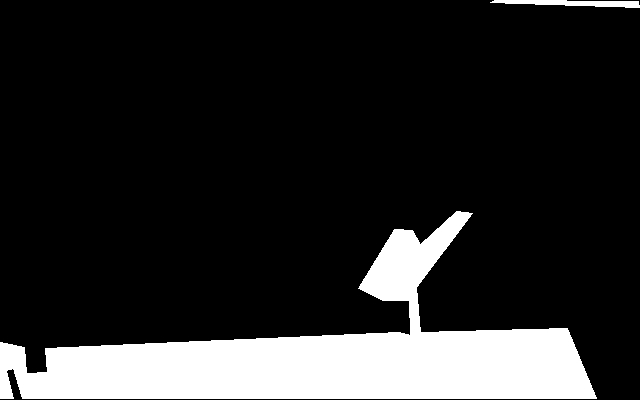
test/ComputerVision/AnnotationPublicDataset/7Drone-Sunny-MedAlt-Occupied-AnnotNAT.jpg
