icecap360/DroneCapstone/test/ComputerVision/AnnotationPublicDataset/7Drone-Sunny-MedAlt-Occupied-AnnotPRK.jpg

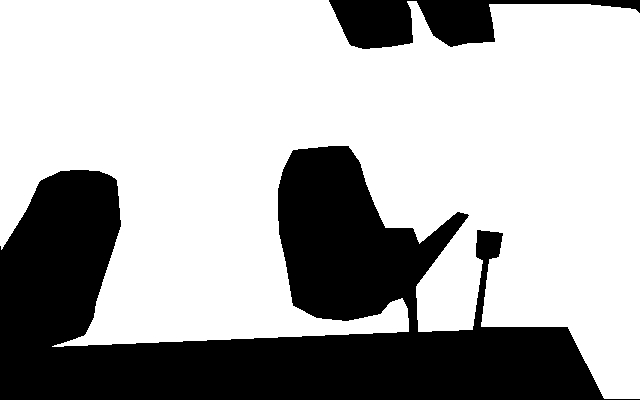
test/ComputerVision/AnnotationPublicDataset/7Drone-Sunny-MedAlt-Occupied-AnnotPRK.jpg
