icecap360/DroneCapstone/test/ComputerVision/AnnotationPublicDataset/7Drone-Sunny-MedAlt-ParkLot-AnnotNAT.jpg

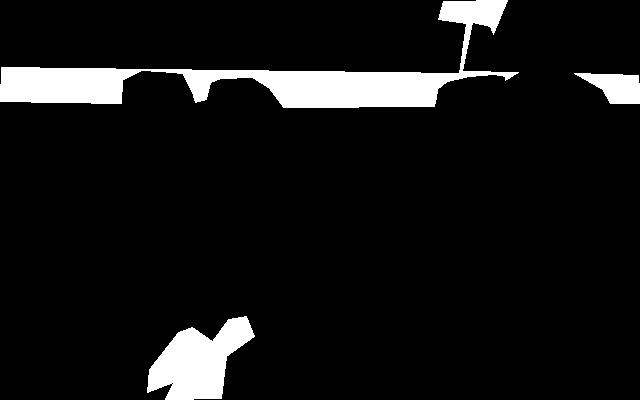
test/ComputerVision/AnnotationPublicDataset/7Drone-Sunny-MedAlt-ParkLot-AnnotNAT.jpg
