icecap360/DroneCapstone/test/ComputerVision/AnnotationPublicDataset/8Drone-Overcast-MedAlt-Nature-AnnotNAT.jpg

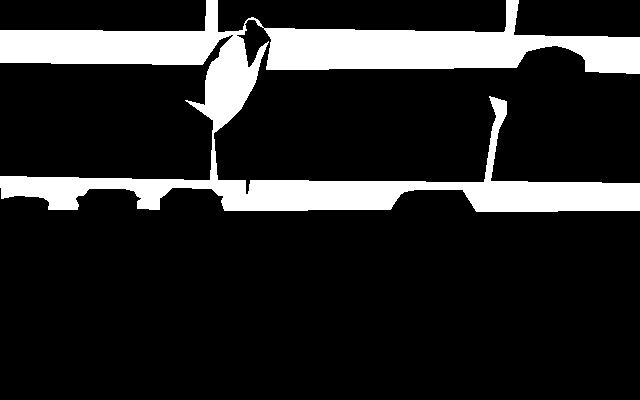
test/ComputerVision/AnnotationPublicDataset/8Drone-Overcast-MedAlt-Nature-AnnotNAT.jpg
