icecap360/DroneCapstone/test/ComputerVision/AnnotationPublicDataset/8Drone-Overcast-MedAlt-Nature-AnnotPRK.jpg

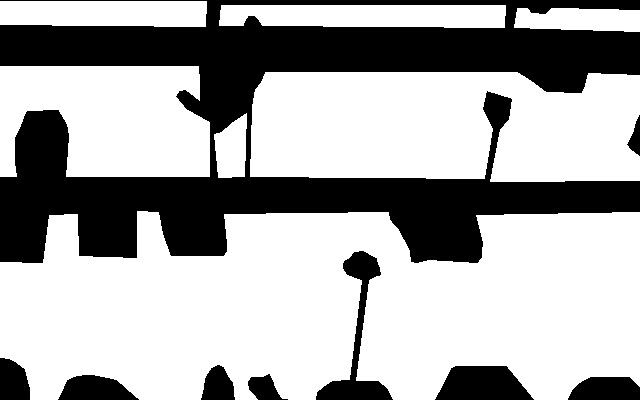
test/ComputerVision/AnnotationPublicDataset/8Drone-Overcast-MedAlt-Nature-AnnotPRK.jpg
