icecap360/DroneCapstone/test/ComputerVision/AnnotationPublicDataset/8Drone-Overcast-MedAlt-Occupied-AnnotNAT.jpg

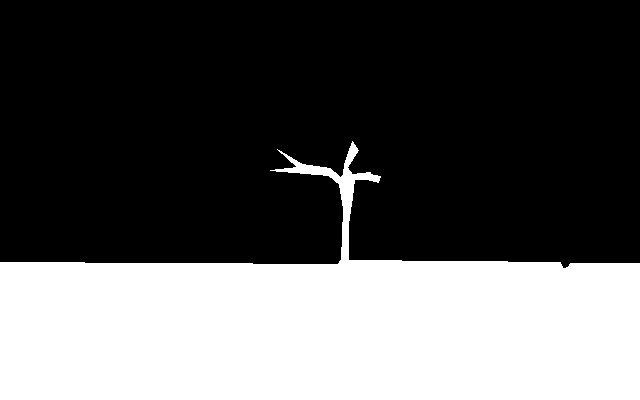
test/ComputerVision/AnnotationPublicDataset/8Drone-Overcast-MedAlt-Occupied-AnnotNAT.jpg
