icecap360/DroneCapstone/test/ComputerVision/AnnotationPublicDataset/8Drone-Overcast-MedAlt-Occupied-AnnotPRK.jpg

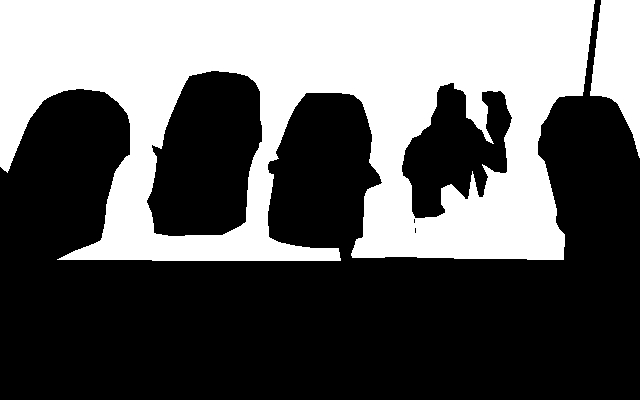
test/ComputerVision/AnnotationPublicDataset/8Drone-Overcast-MedAlt-Occupied-AnnotPRK.jpg
