icecap360/DroneCapstone/test/ComputerVision/AnnotationPublicDataset/10Drone-Sunny-MedAlt-ParkLot-AnnotPRK.jpg

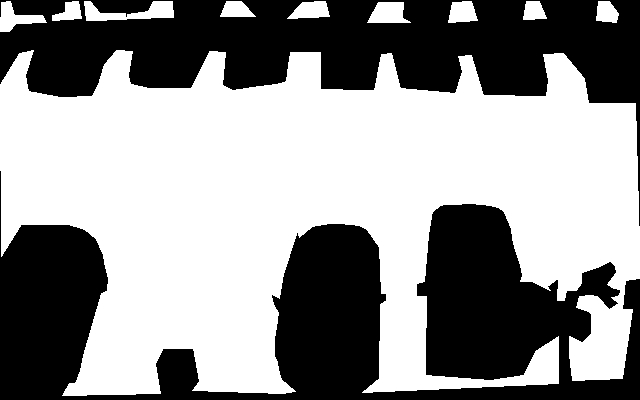
test/ComputerVision/AnnotationPublicDataset/10Drone-Sunny-MedAlt-ParkLot-AnnotPRK.jpg
