icecap360/DroneCapstone/test/ComputerVision/AnnotationSattaliteImagery/image0-AnnotPRK.jpg

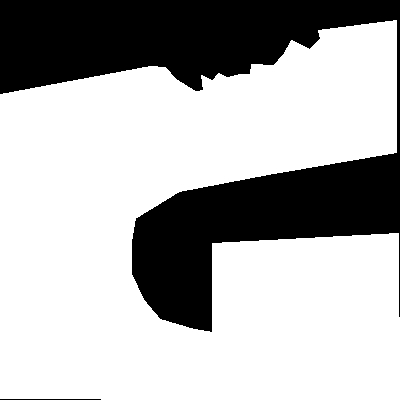
test/ComputerVision/AnnotationSattaliteImagery/image0-AnnotPRK.jpg
