icecap360/DroneCapstone/test/ComputerVision/AnnotationSattaliteImagery/image1-AnnotPRK.jpg

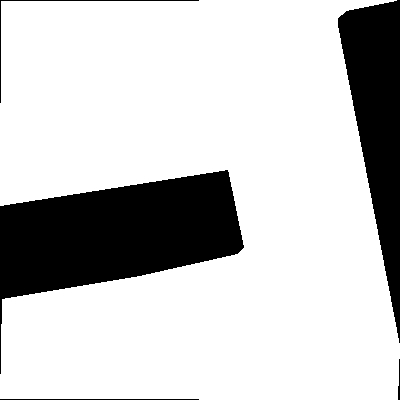
test/ComputerVision/AnnotationSattaliteImagery/image1-AnnotPRK.jpg
