icecap360/DroneCapstone/test/ComputerVision/AnnotationSattaliteImagery/image2-AnnotPRK.jpg

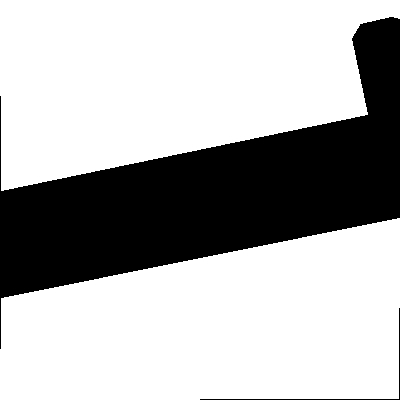
test/ComputerVision/AnnotationSattaliteImagery/image2-AnnotPRK.jpg
