icecap360/DroneCapstone/test/ComputerVision/AnnotationSattaliteImagery/image3-AnnotPRK.jpg

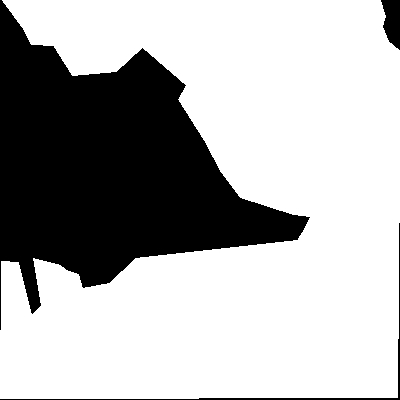
test/ComputerVision/AnnotationSattaliteImagery/image3-AnnotPRK.jpg
