icecap360/DroneCapstone/test/ComputerVision/AnnotationSattaliteImagery/image4-AnnotPRK.jpg

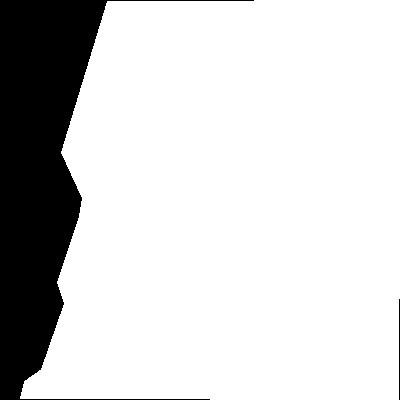
test/ComputerVision/AnnotationSattaliteImagery/image4-AnnotPRK.jpg
