icecap360/DroneCapstone/test/ComputerVision/AnnotationSattaliteImagery/image5-AnnotPRK.jpg

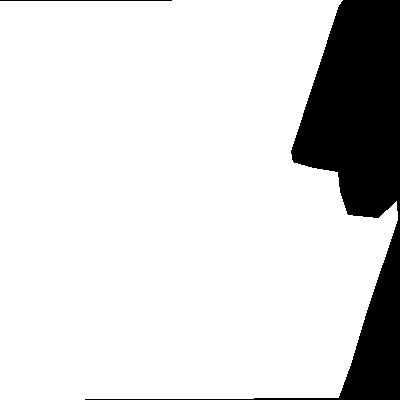
test/ComputerVision/AnnotationSattaliteImagery/image5-AnnotPRK.jpg
