icecap360/DroneCapstone/test/ComputerVision/AnnotationSattaliteImagery/image6-AnnotPRK.jpg

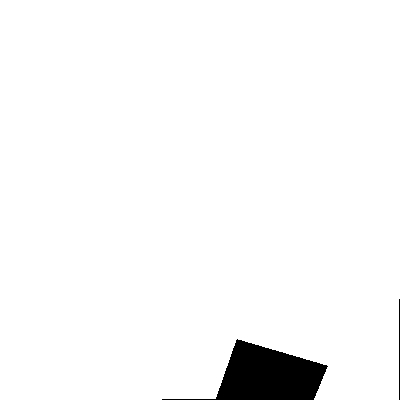
test/ComputerVision/AnnotationSattaliteImagery/image6-AnnotPRK.jpg
