icecap360/DroneCapstone/test/ComputerVision/AnnotationSattaliteImagery/image8-AnnotPRK.jpg

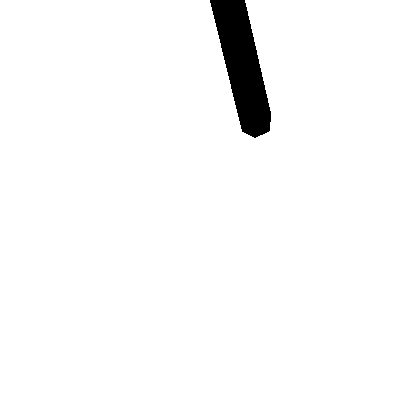
test/ComputerVision/AnnotationSattaliteImagery/image8-AnnotPRK.jpg
