icecap360/DroneCapstone/test/ComputerVision/AnnotationSattaliteImagery/image9-AnnotPRK.jpg

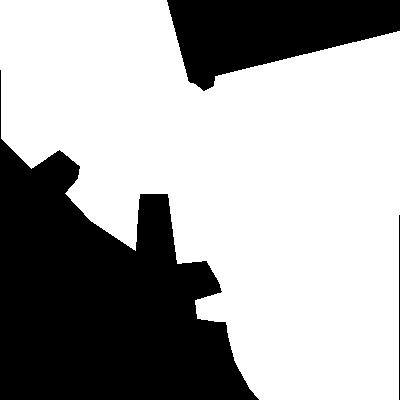
test/ComputerVision/AnnotationSattaliteImagery/image9-AnnotPRK.jpg
