icecap360/DroneCapstone/test/ComputerVision/AnnotationSattaliteImagery/image10-AnnotPRK.jpg

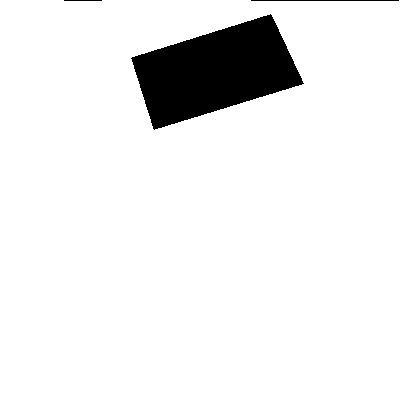
test/ComputerVision/AnnotationSattaliteImagery/image10-AnnotPRK.jpg
