icecap360/DroneCapstone/test/ComputerVision/AnnotationSattaliteImagery/ParkingLot00-AnnotPRK.jpg

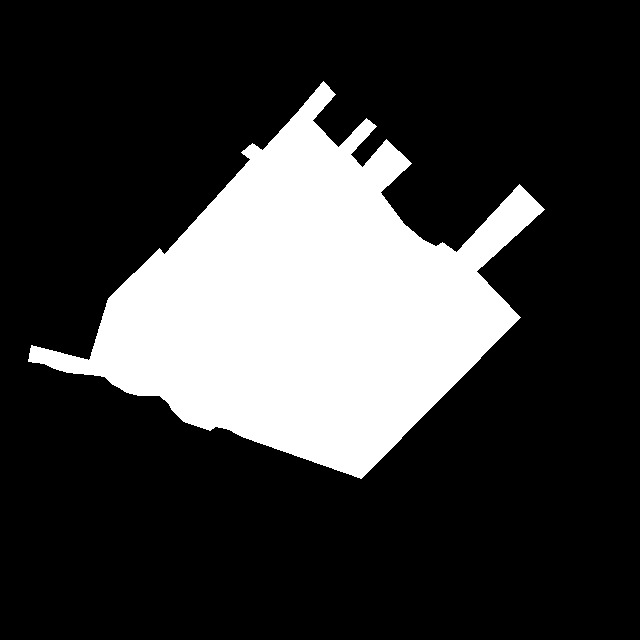
test/ComputerVision/AnnotationSattaliteImagery/ParkingLot00-AnnotPRK.jpg
