icecap360/DroneCapstone/test/ComputerVision/AnnotationSattaliteImagery/ParkingLot01-AnnotPRK.jpg

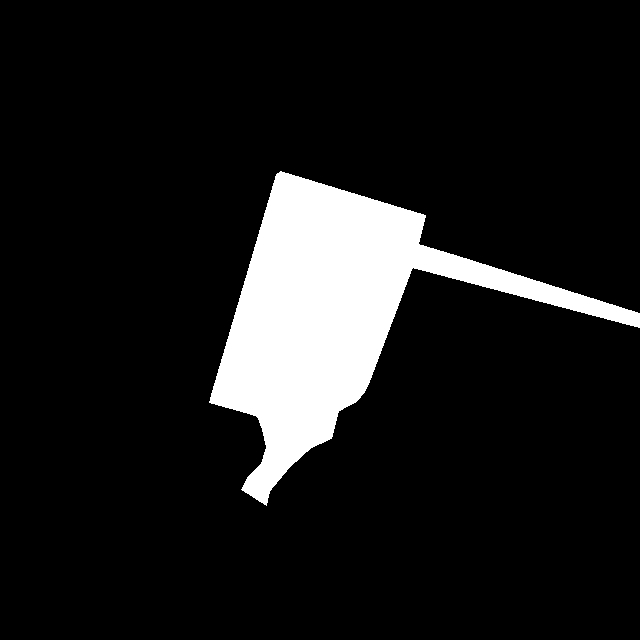
test/ComputerVision/AnnotationSattaliteImagery/ParkingLot01-AnnotPRK.jpg
