icecap360/DroneCapstone/test/ComputerVision/AnnotationSattaliteImagery/ParkingLot02-AnnotPRK.jpg

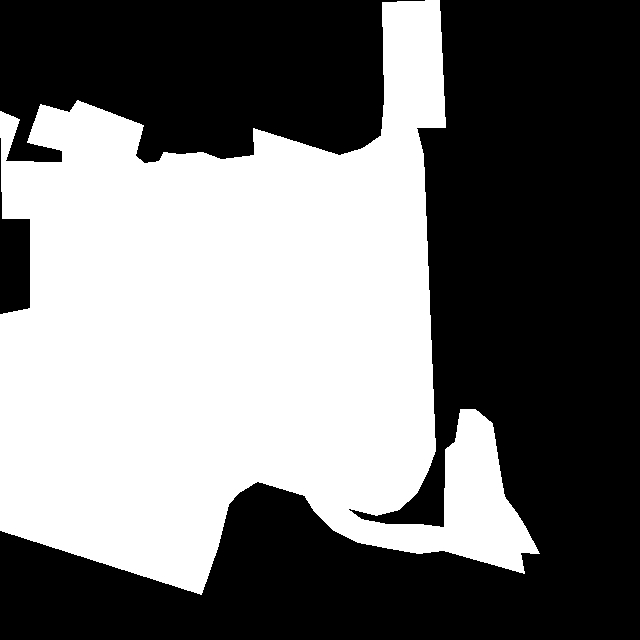
test/ComputerVision/AnnotationSattaliteImagery/ParkingLot02-AnnotPRK.jpg
