icecap360/DroneCapstone/test/ComputerVision/AnnotationSattaliteImagery/ParkingLot03-AnnotPRK.jpg

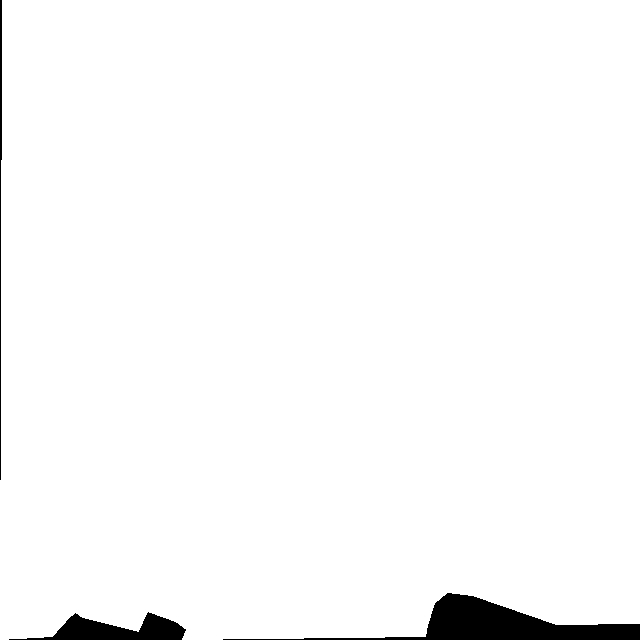
test/ComputerVision/AnnotationSattaliteImagery/ParkingLot03-AnnotPRK.jpg
