icecap360/DroneCapstone/test/ComputerVision/AnnotationSattaliteImagery/ParkingLot04-AnnotPRK.jpg

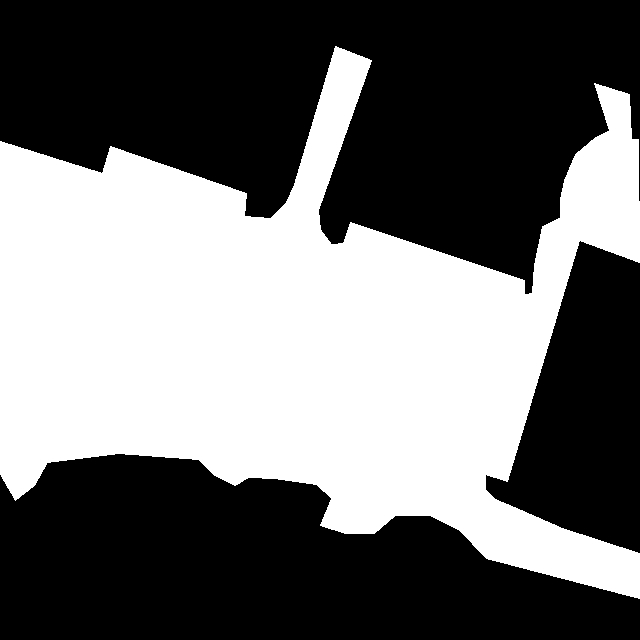
test/ComputerVision/AnnotationSattaliteImagery/ParkingLot04-AnnotPRK.jpg
