icecap360/DroneCapstone/test/ComputerVision/AnnotationSattaliteImagery/ParkingLot05-AnnotPRK.jpg

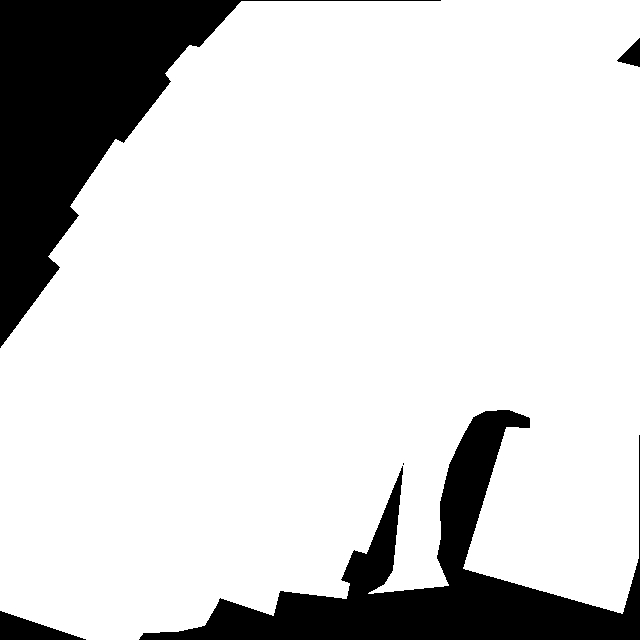
test/ComputerVision/AnnotationSattaliteImagery/ParkingLot05-AnnotPRK.jpg
