icecap360/DroneCapstone/test/ComputerVision/AnnotationSattaliteImagery/ParkingLot06-AnnotPRK.jpg

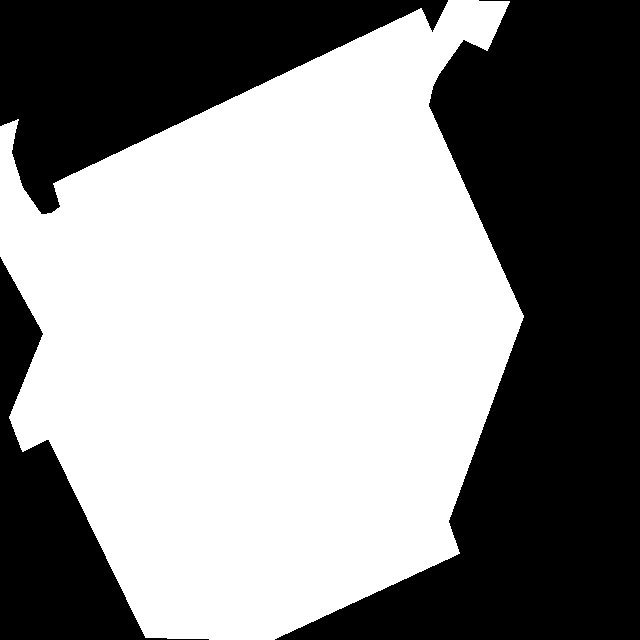
test/ComputerVision/AnnotationSattaliteImagery/ParkingLot06-AnnotPRK.jpg
