icecap360/DroneCapstone/test/ComputerVision/AnnotationSattaliteImagery/ParkingLot07-AnnotPRK.jpg

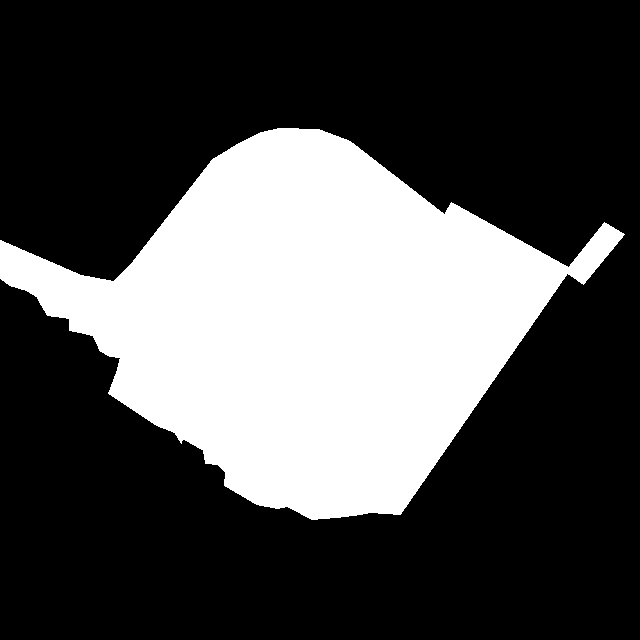
test/ComputerVision/AnnotationSattaliteImagery/ParkingLot07-AnnotPRK.jpg
