icecap360/DroneCapstone/test/ComputerVision/AnnotationSattaliteImagery/ParkingLot08-AnnotPRK.jpg

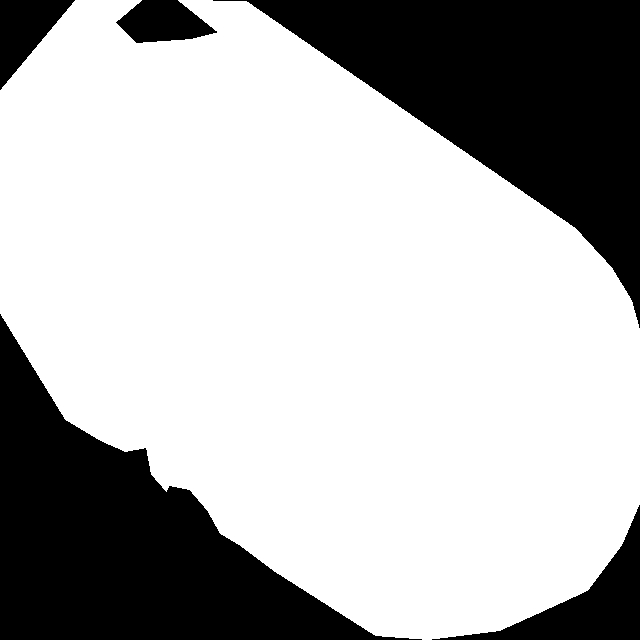
test/ComputerVision/AnnotationSattaliteImagery/ParkingLot08-AnnotPRK.jpg
