icecap360/DroneCapstone/test/ComputerVision/AnnotationSattaliteImagery/ParkingLot09-AnnotPRK.jpg

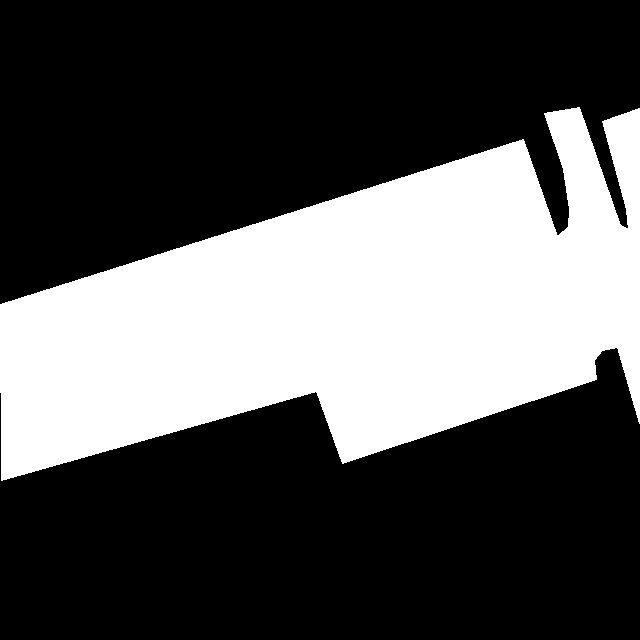
test/ComputerVision/AnnotationSattaliteImagery/ParkingLot09-AnnotPRK.jpg
