icecap360/DroneCapstone/test/ComputerVision/AnnotationSattaliteImagery/ParkingLot10-AnnotPRK.jpg

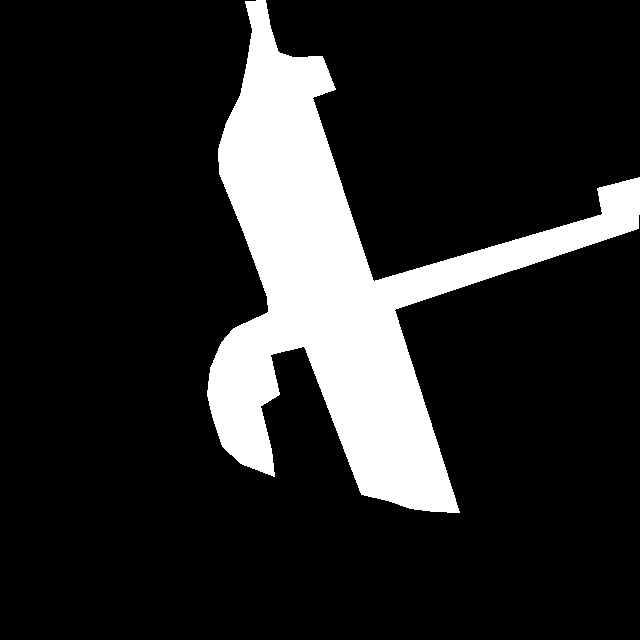
test/ComputerVision/AnnotationSattaliteImagery/ParkingLot10-AnnotPRK.jpg
