icecap360/DroneCapstone/test/ComputerVision/AnnotationSattaliteImagery/ParkingLot11-AnnotPRK.jpg

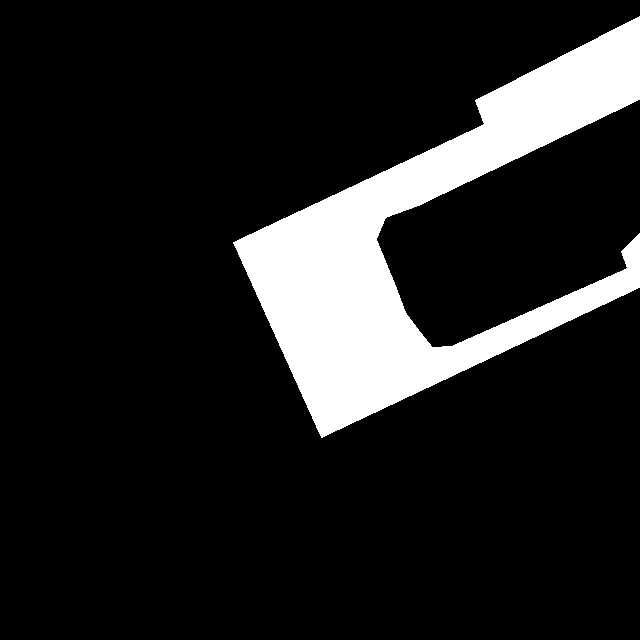
test/ComputerVision/AnnotationSattaliteImagery/ParkingLot11-AnnotPRK.jpg
