icecap360/DroneCapstone/test/ComputerVision/AnnotationSattaliteImagery/ParkingLot12-AnnotPRK.jpg

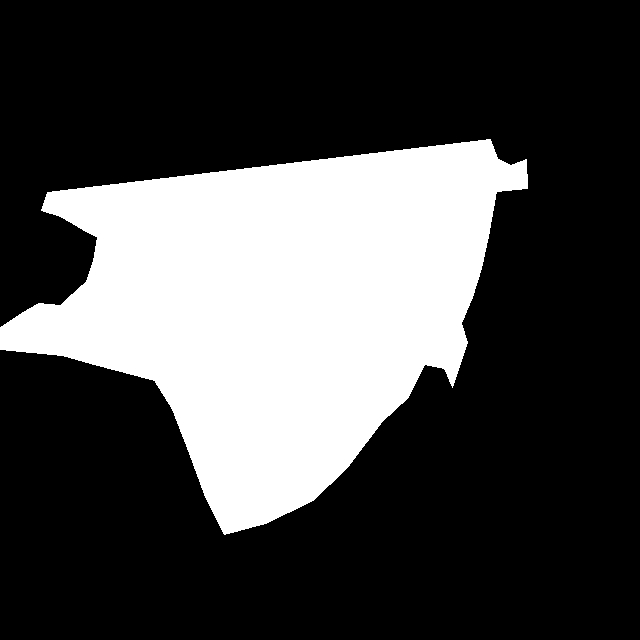
test/ComputerVision/AnnotationSattaliteImagery/ParkingLot12-AnnotPRK.jpg
