icecap360/DroneCapstone/test/ComputerVision/AnnotationSattaliteImagery/ParkingLot13-AnnotPRK.jpg

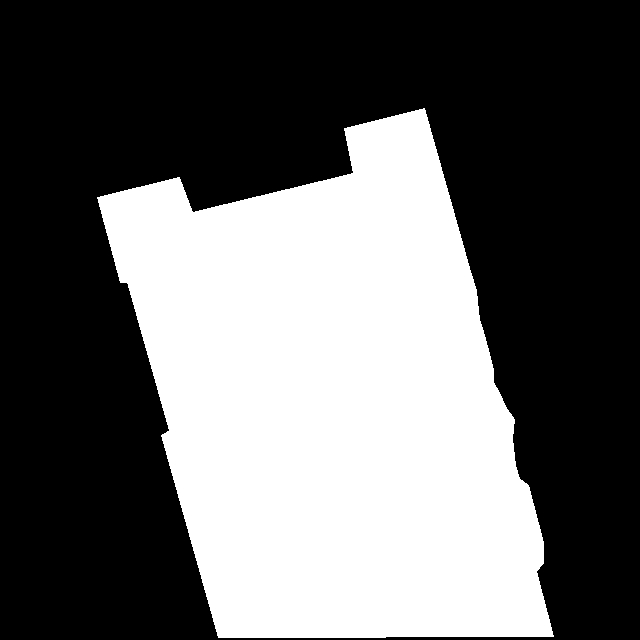
test/ComputerVision/AnnotationSattaliteImagery/ParkingLot13-AnnotPRK.jpg
