icecap360/DroneCapstone/test/ComputerVision/AnnotationSattaliteImagery/ParkingLot14-AnnotPRK.jpg

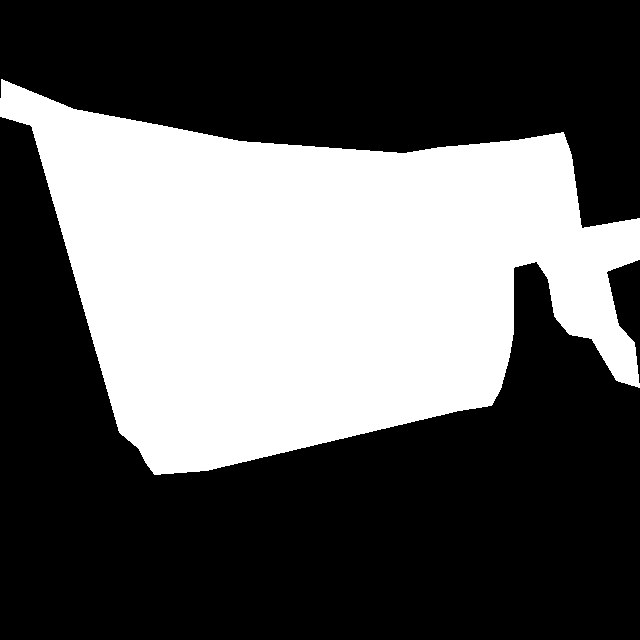
test/ComputerVision/AnnotationSattaliteImagery/ParkingLot14-AnnotPRK.jpg
