icecap360/DroneCapstone/test/ComputerVision/AnnotationSattaliteImagery/ParkingLot15-AnnotPRK.jpg

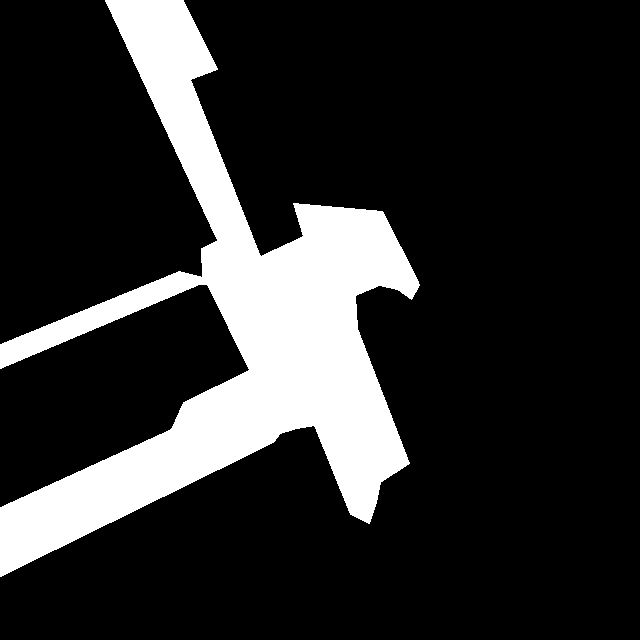
test/ComputerVision/AnnotationSattaliteImagery/ParkingLot15-AnnotPRK.jpg
