icecap360/DroneCapstone/test/ComputerVision/AnnotationSattaliteImagery/ParkingLot16-AnnotPRK.jpg

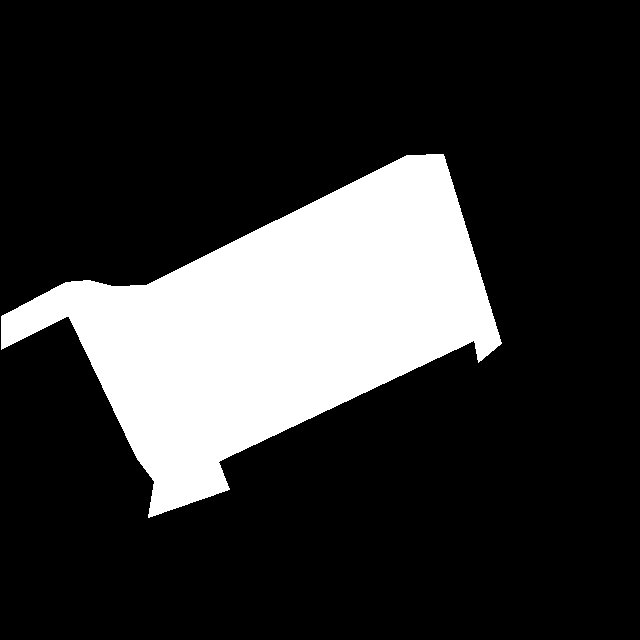
test/ComputerVision/AnnotationSattaliteImagery/ParkingLot16-AnnotPRK.jpg
