icecap360/DroneCapstone/test/ComputerVision/AnnotationSattaliteImagery/ParkingLot17-AnnotPRK.jpg

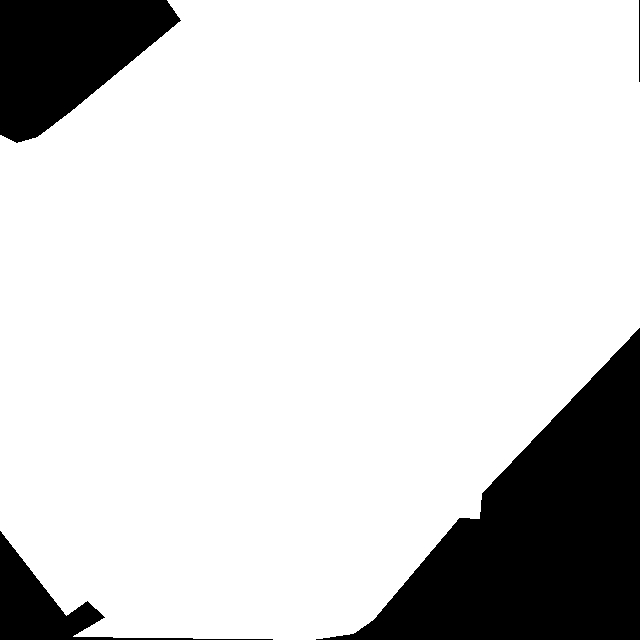
test/ComputerVision/AnnotationSattaliteImagery/ParkingLot17-AnnotPRK.jpg
