icecap360/DroneCapstone/test/ComputerVision/AnnotationSattaliteImagery/ParkingLot18-AnnotPRK.jpg

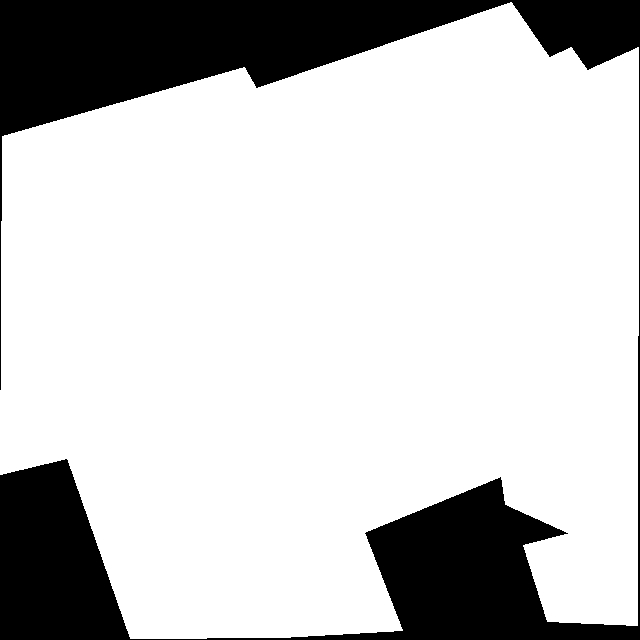
test/ComputerVision/AnnotationSattaliteImagery/ParkingLot18-AnnotPRK.jpg
