icecap360/DroneCapstone/test/ComputerVision/AnnotationSattaliteImagery/ParkingLot19-AnnotPRK.jpg

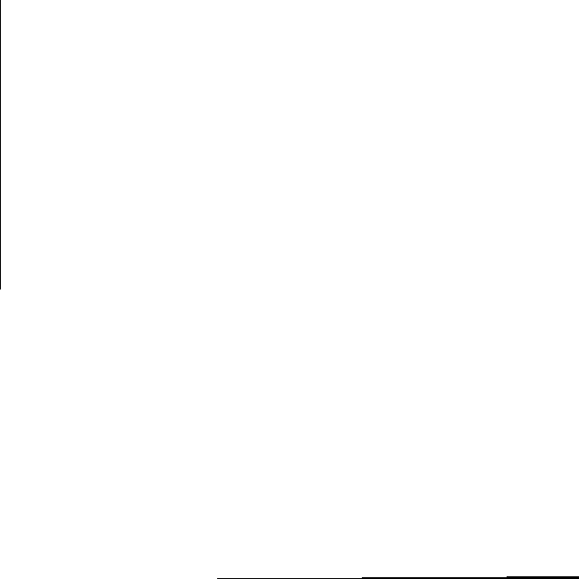
test/ComputerVision/AnnotationSattaliteImagery/ParkingLot19-AnnotPRK.jpg
