icecap360/DroneCapstone/test/ComputerVision/AnnotationSattaliteImagery/ParkingLot21-AnnotPRK.jpg

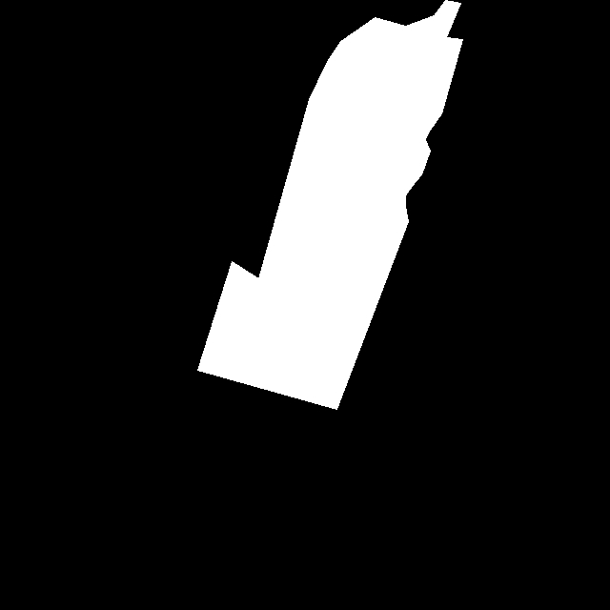
test/ComputerVision/AnnotationSattaliteImagery/ParkingLot21-AnnotPRK.jpg
