icecap360/DroneCapstone/test/ComputerVision/AnnotationSattaliteImagery/ParkingLot22-AnnotPRK.jpg

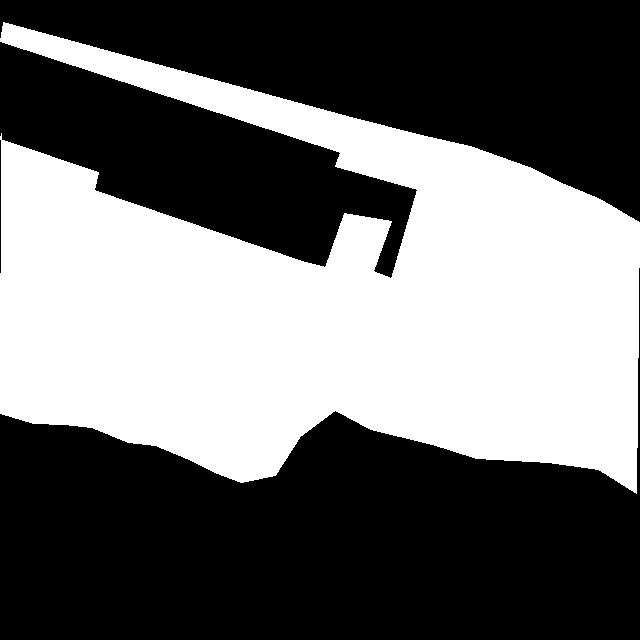
test/ComputerVision/AnnotationSattaliteImagery/ParkingLot22-AnnotPRK.jpg
