icecap360/DroneCapstone/test/ComputerVision/AnnotationSattaliteImagery/ParkingLot23-AnnotPRK.jpg

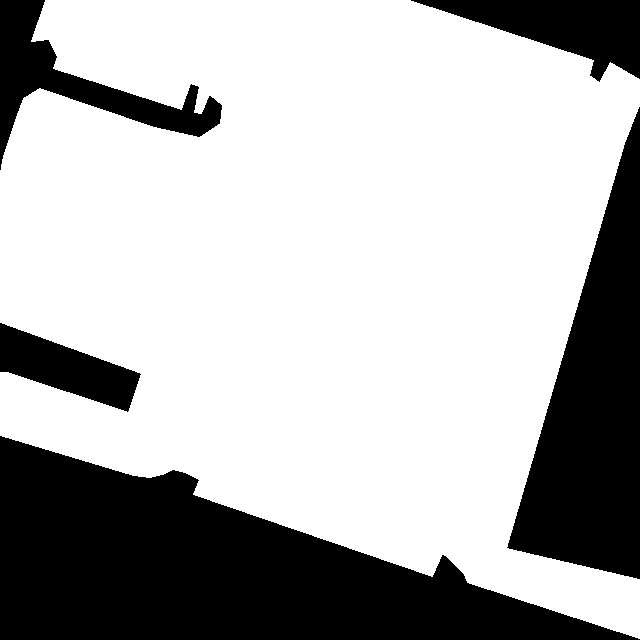
test/ComputerVision/AnnotationSattaliteImagery/ParkingLot23-AnnotPRK.jpg
