icecap360/DroneCapstone/test/ComputerVision/AnnotationSattaliteImagery/ParkingLot24-AnnotPRK.jpg

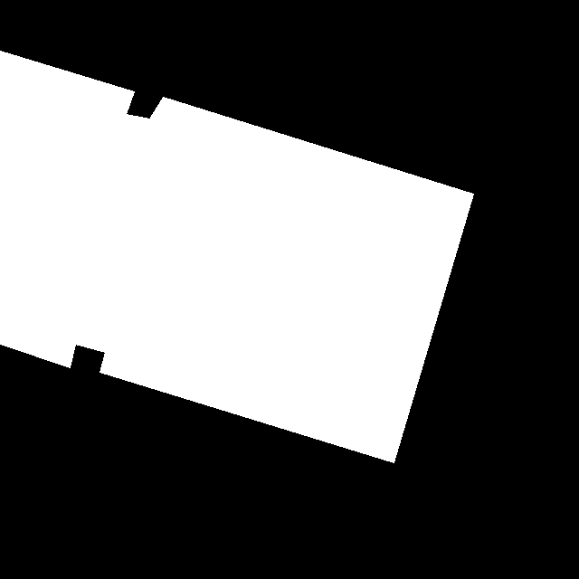
test/ComputerVision/AnnotationSattaliteImagery/ParkingLot24-AnnotPRK.jpg
