icecap360/DroneCapstone/test/ComputerVision/AnnotationSattaliteImagery/ParkingLot25-AnnotPRK.jpg

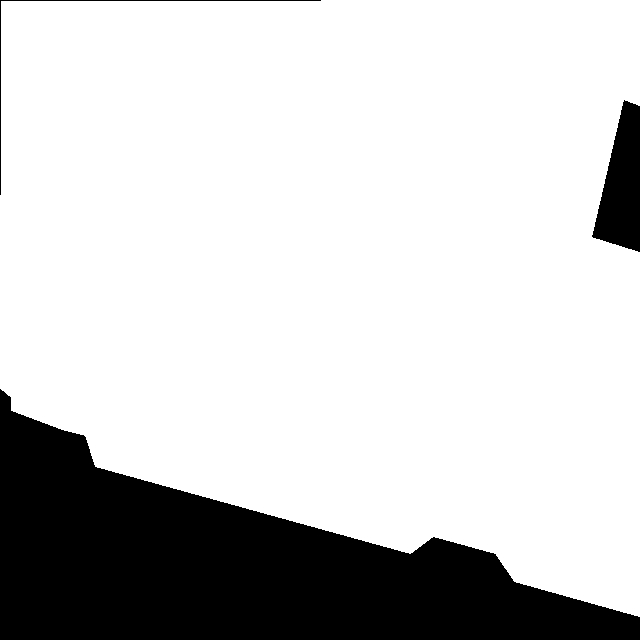
test/ComputerVision/AnnotationSattaliteImagery/ParkingLot25-AnnotPRK.jpg
