icecap360/DroneCapstone/test/ComputerVision/AnnotationSattaliteImagery/ParkingLot26-AnnotPRK.jpg

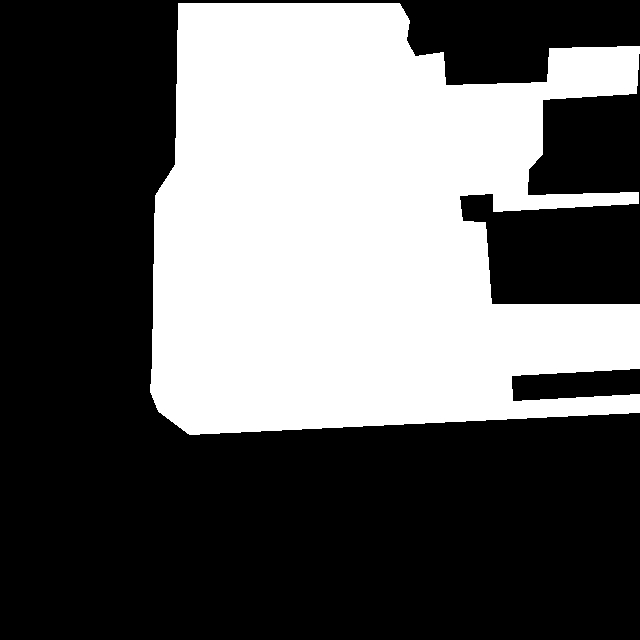
test/ComputerVision/AnnotationSattaliteImagery/ParkingLot26-AnnotPRK.jpg
