icecap360/DroneCapstone/test/ComputerVision/AnnotationSattaliteImagery/ParkingLot27-AnnotPRK.jpg

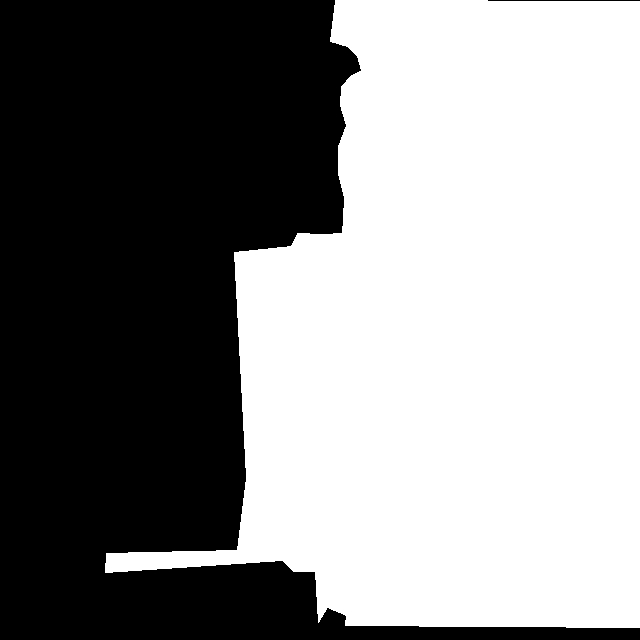
test/ComputerVision/AnnotationSattaliteImagery/ParkingLot27-AnnotPRK.jpg
