icecap360/DroneCapstone/test/ComputerVision/AnnotationSattaliteImagery/ParkingLot28-AnnotPRK.jpg

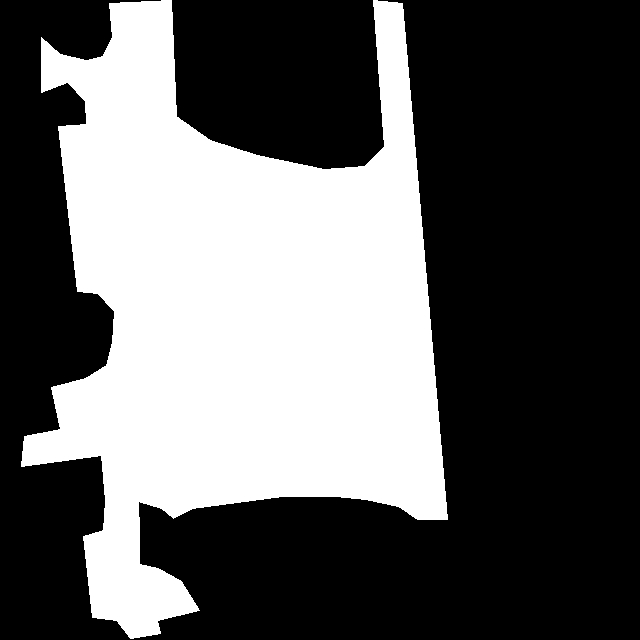
test/ComputerVision/AnnotationSattaliteImagery/ParkingLot28-AnnotPRK.jpg
