icecap360/DroneCapstone/test/ComputerVision/AnnotationSattaliteImagery/ParkingLot29-AnnotPRK.jpg

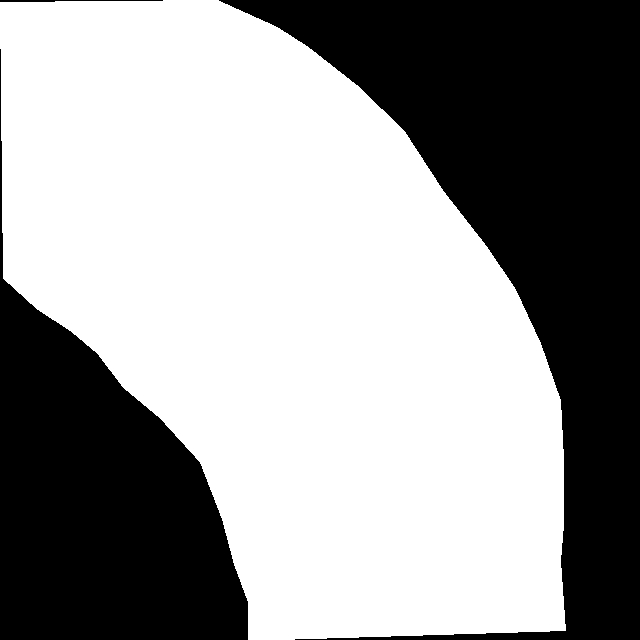
test/ComputerVision/AnnotationSattaliteImagery/ParkingLot29-AnnotPRK.jpg
