icecap360/DroneCapstone/test/ComputerVision/GoogleTestImages/ParkingLot1.jpg

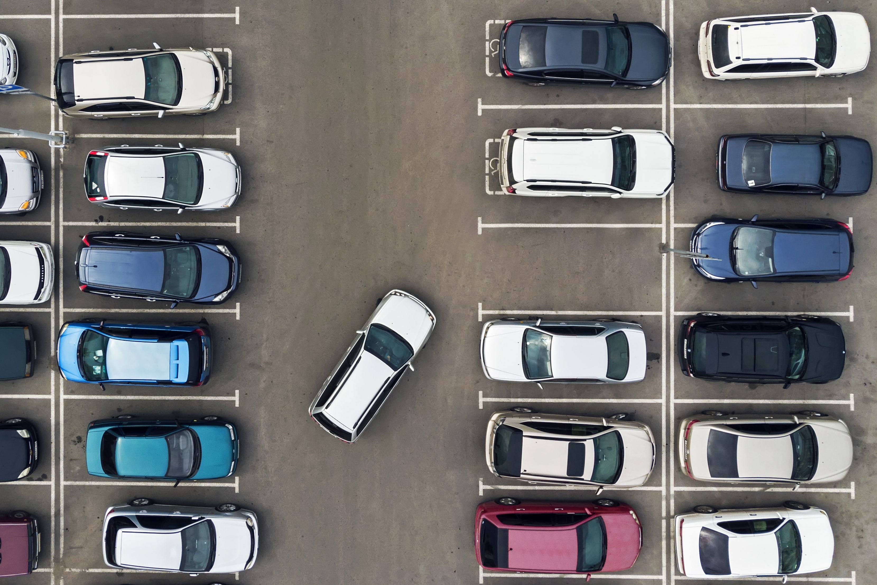
test/ComputerVision/GoogleTestImages/ParkingLot1.jpg
