icecap360/DroneCapstone/test/ComputerVision/GoogleTestImages/ParkingLot2.jpg

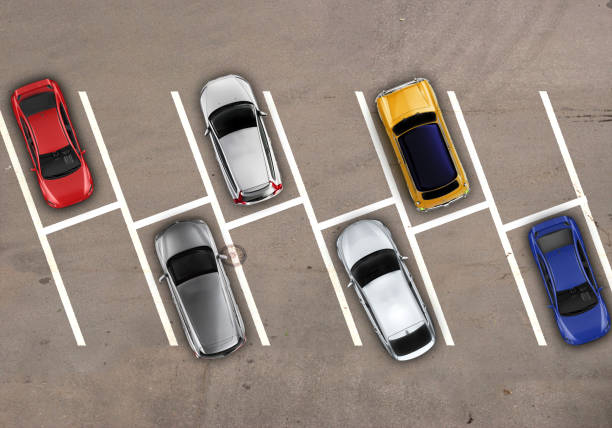
test/ComputerVision/GoogleTestImages/ParkingLot2.jpg
