icecap360/DroneCapstone/test/ComputerVision/GoogleTestImages/ParkingLot3.jpg

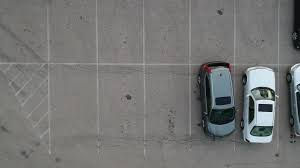
test/ComputerVision/GoogleTestImages/ParkingLot3.jpg
