icecap360/DroneCapstone/test/ComputerVision/GoogleTestImages/ParkingLot4.jpg

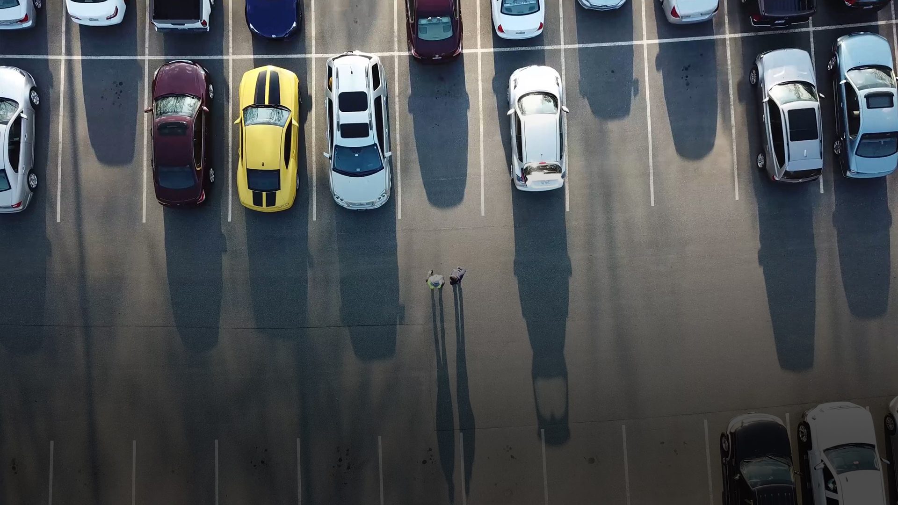
test/ComputerVision/GoogleTestImages/ParkingLot4.jpg
