icecap360/DroneCapstone/test/ComputerVision/GoogleTestImages/ParkingLot5.jpg

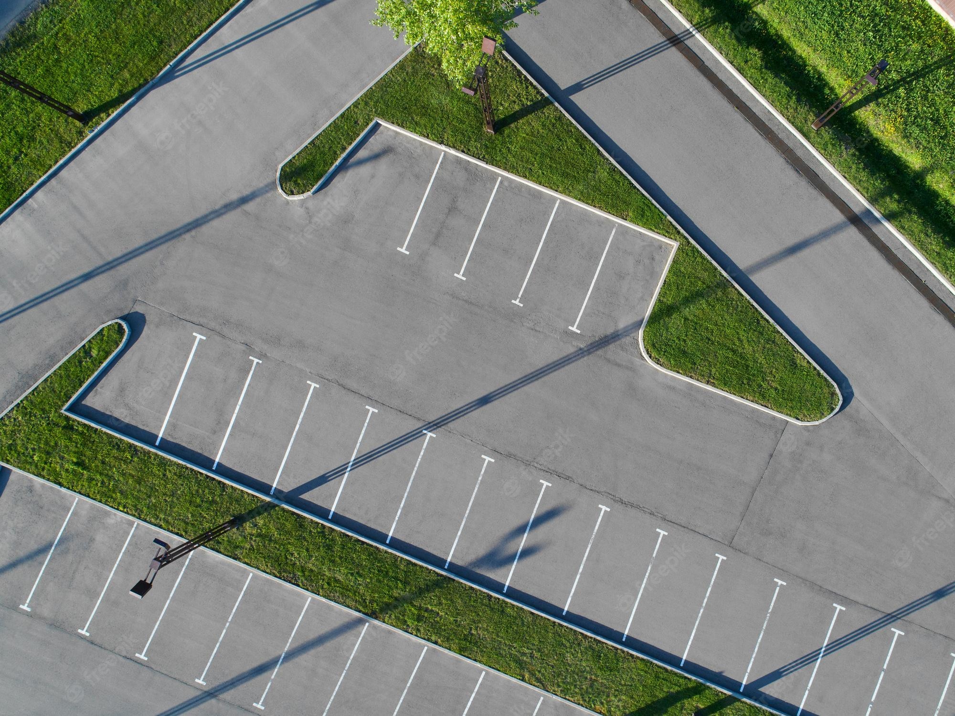
test/ComputerVision/GoogleTestImages/ParkingLot5.jpg
