icecap360/DroneCapstone/test/ComputerVision/GoogleTestImages/ParkingLot6.jpg

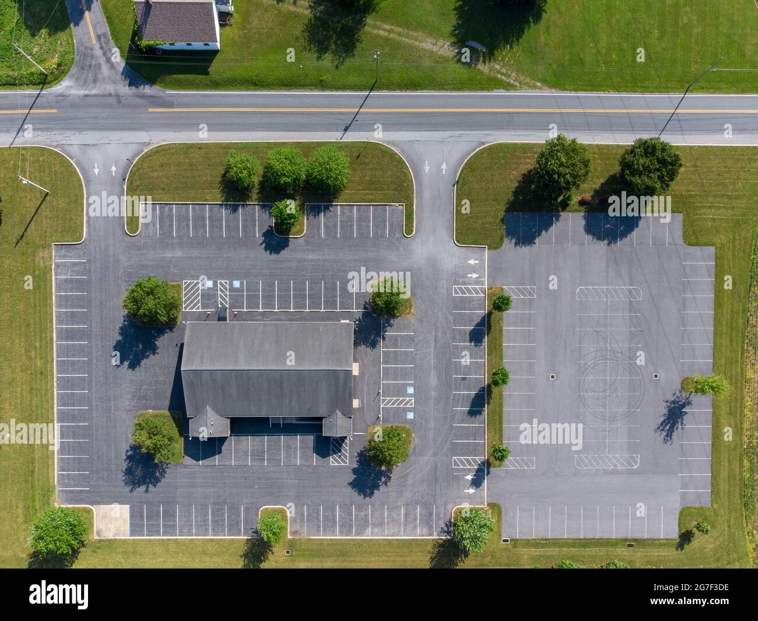
test/ComputerVision/GoogleTestImages/ParkingLot6.jpg
