icecap360/DroneCapstone/test/ComputerVision/GoogleTestImages/ParkingLot7.jpg

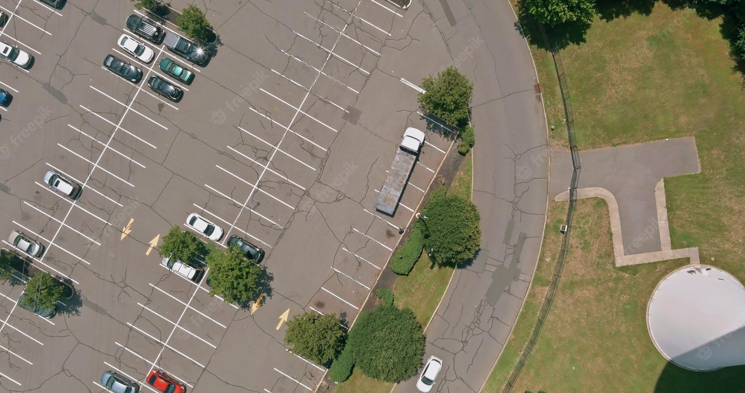
test/ComputerVision/GoogleTestImages/ParkingLot7.jpg
