icecap360/DroneCapstone/test/ComputerVision/GoogleTestImages/ParkingLot8.jpg

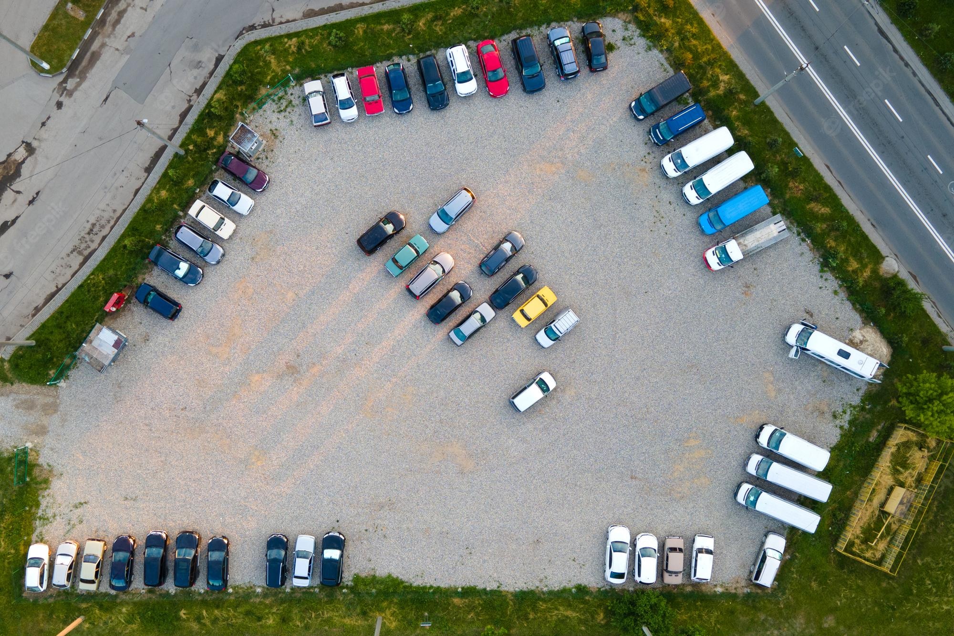
test/ComputerVision/GoogleTestImages/ParkingLot8.jpg
