icecap360/DroneCapstone/test/ComputerVision/GoogleTestImages/ParkingLot9.jpg

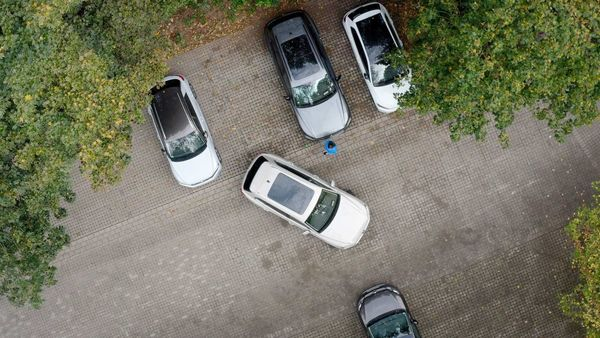
test/ComputerVision/GoogleTestImages/ParkingLot9.jpg
