icecap360/DroneCapstone/test/ComputerVision/PublicDataset/1Drone-Overcast-MedAlt-Nature.jpg

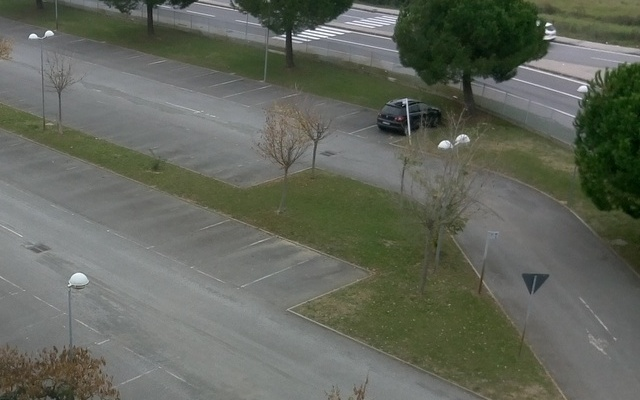
test/ComputerVision/PublicDataset/1Drone-Overcast-MedAlt-Nature.jpg
