icecap360/DroneCapstone/test/ComputerVision/PublicDataset/1Drone-Overcast-MedAlt-Occupied.jpg

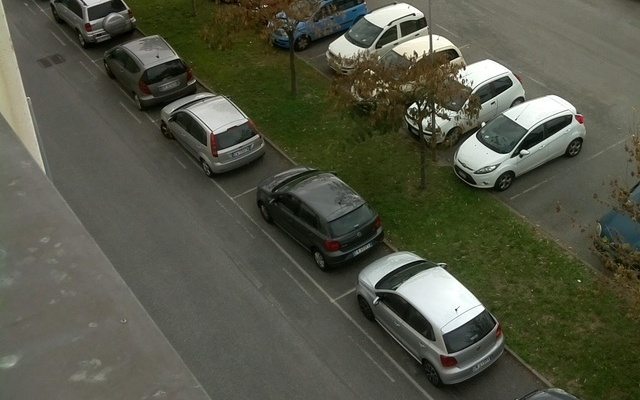
test/ComputerVision/PublicDataset/1Drone-Overcast-MedAlt-Occupied.jpg
