icecap360/DroneCapstone/test/ComputerVision/PublicDataset/1Drone-Overcast-MedAlt-ParkLot.jpg

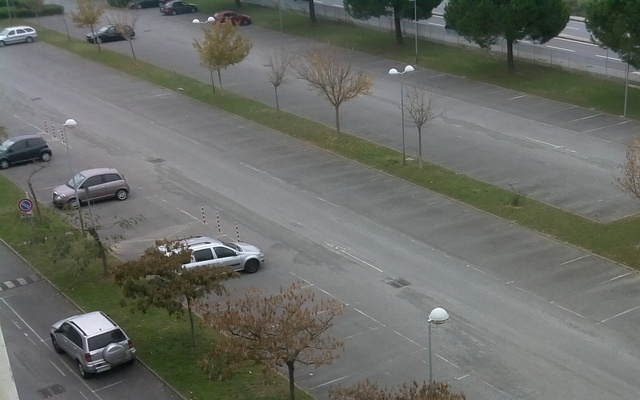
test/ComputerVision/PublicDataset/1Drone-Overcast-MedAlt-ParkLot.jpg
