icecap360/DroneCapstone/test/ComputerVision/PublicDataset/1Drone-Sunny-MedAlt-Nature.jpg

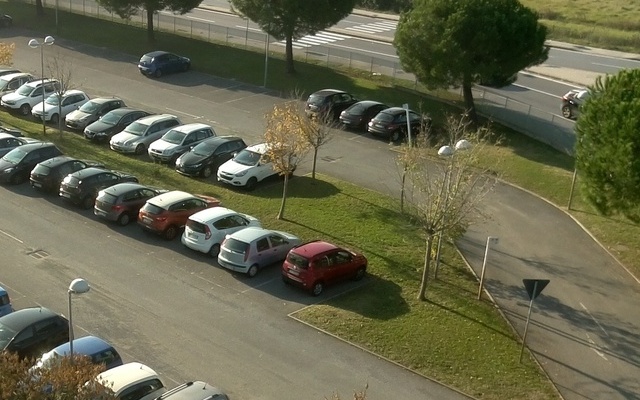
test/ComputerVision/PublicDataset/1Drone-Sunny-MedAlt-Nature.jpg
