icecap360/DroneCapstone/test/ComputerVision/PublicDataset/1Drone-Sunny-MedAlt-Occupied1.jpg

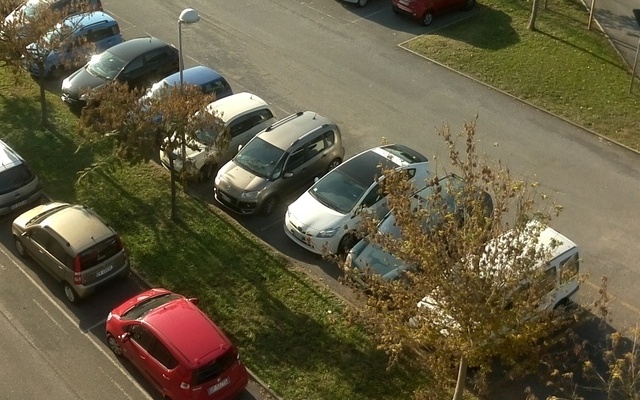
test/ComputerVision/PublicDataset/1Drone-Sunny-MedAlt-Occupied1.jpg
