icecap360/DroneCapstone/test/ComputerVision/PublicDataset/1Drone-Sunny-MedAlt-Occupied.jpg

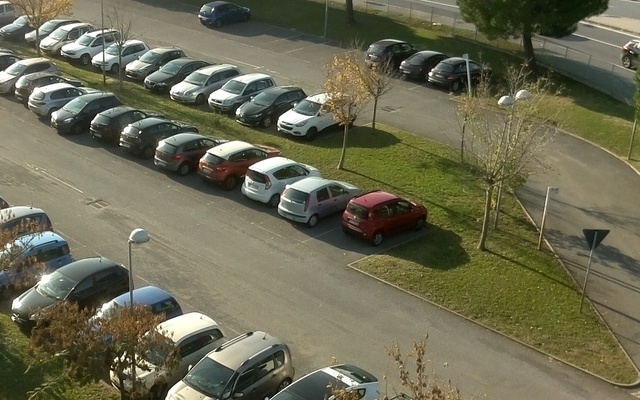
test/ComputerVision/PublicDataset/1Drone-Sunny-MedAlt-Occupied.jpg
