icecap360/DroneCapstone/test/ComputerVision/PublicDataset/1Drone-Sunny-MedAlt-ParkLot.jpg

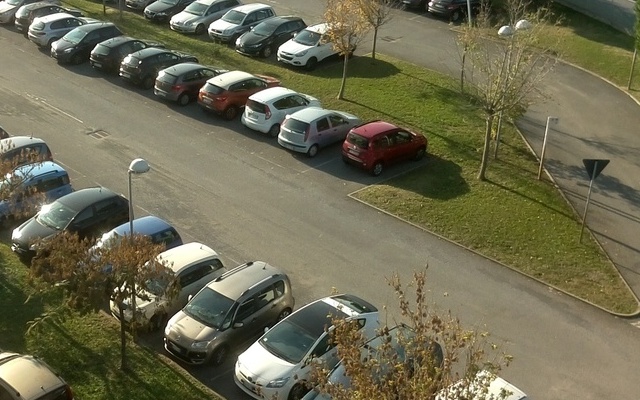
test/ComputerVision/PublicDataset/1Drone-Sunny-MedAlt-ParkLot.jpg
