icecap360/DroneCapstone/test/ComputerVision/PublicDataset/3Drone-Overcast-MedAlt-Nature.jpg

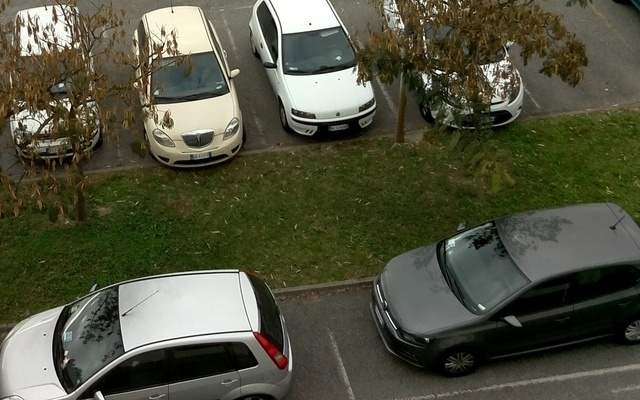
test/ComputerVision/PublicDataset/3Drone-Overcast-MedAlt-Nature.jpg
