icecap360/DroneCapstone/test/ComputerVision/PublicDataset/3Drone-Overcast-MedAlt-Occupied.jpg

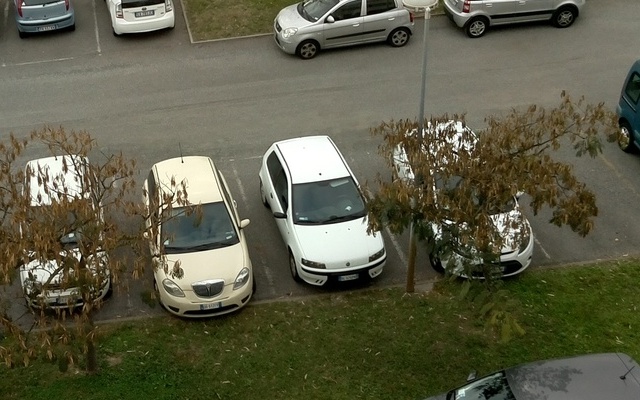
test/ComputerVision/PublicDataset/3Drone-Overcast-MedAlt-Occupied.jpg
