icecap360/DroneCapstone/test/ComputerVision/PublicDataset/3Drone-Overcast-MedAlt-ParkLot.jpg

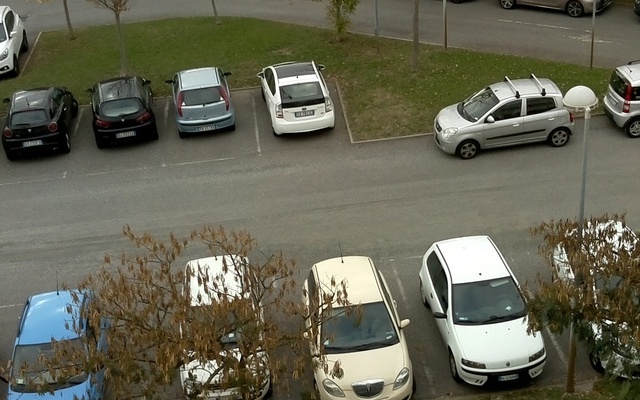
test/ComputerVision/PublicDataset/3Drone-Overcast-MedAlt-ParkLot.jpg
