icecap360/DroneCapstone/test/ComputerVision/PublicDataset/3Drone-Sunny-MedAlt-Nature.jpg

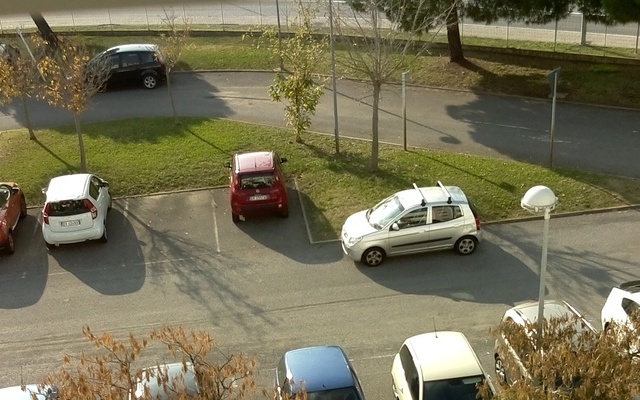
test/ComputerVision/PublicDataset/3Drone-Sunny-MedAlt-Nature.jpg
