icecap360/DroneCapstone/test/ComputerVision/PublicDataset/3Drone-Sunny-MedAlt-Occupied.jpg

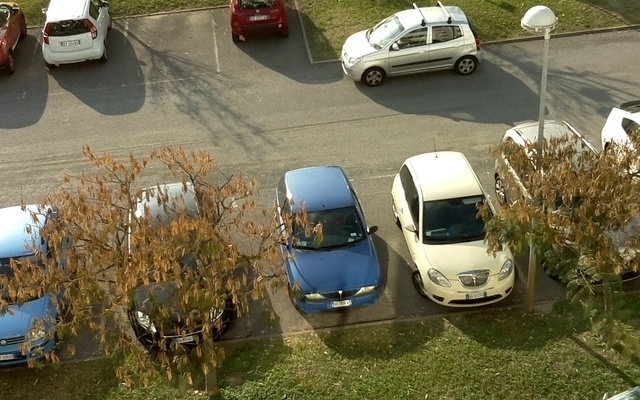
test/ComputerVision/PublicDataset/3Drone-Sunny-MedAlt-Occupied.jpg
