icecap360/DroneCapstone/test/ComputerVision/PublicDataset/3Drone-Sunny-MedAlt-ParkLot.jpg

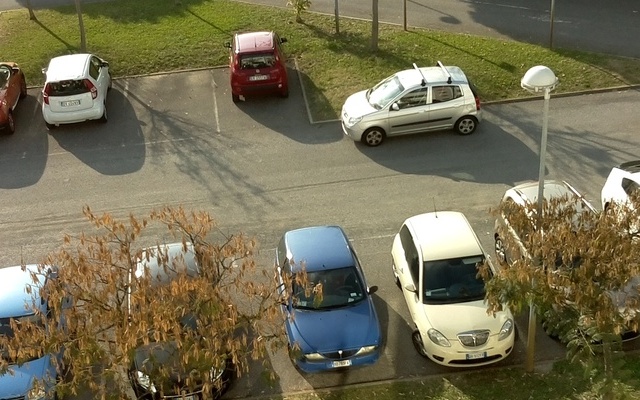
test/ComputerVision/PublicDataset/3Drone-Sunny-MedAlt-ParkLot.jpg
