icecap360/DroneCapstone/test/ComputerVision/PublicDataset/4Drone-Overcast-MedAlt-Nature.jpg

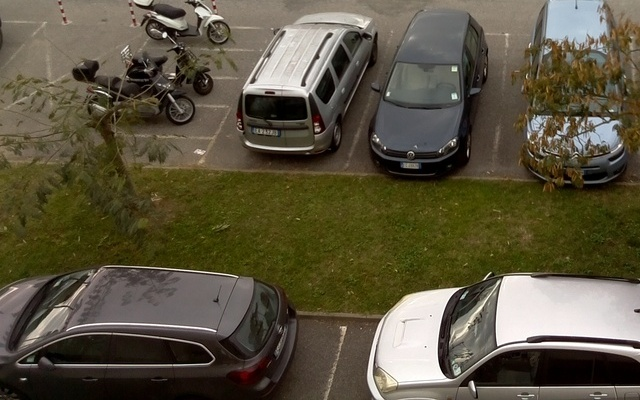
test/ComputerVision/PublicDataset/4Drone-Overcast-MedAlt-Nature.jpg
