icecap360/DroneCapstone/test/ComputerVision/PublicDataset/4Drone-Overcast-MedAlt-Occupied.jpg

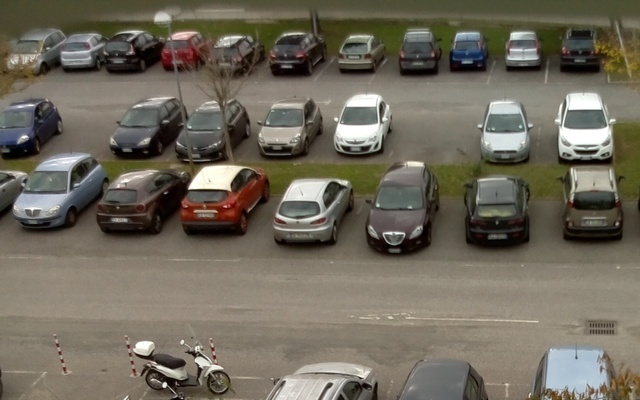
test/ComputerVision/PublicDataset/4Drone-Overcast-MedAlt-Occupied.jpg
