icecap360/DroneCapstone/test/ComputerVision/PublicDataset/4Drone-Overcast-MedAlt-ParkLot.jpg

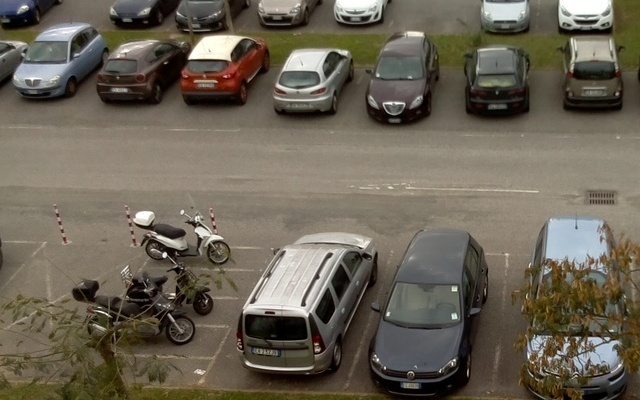
test/ComputerVision/PublicDataset/4Drone-Overcast-MedAlt-ParkLot.jpg
