icecap360/DroneCapstone/test/ComputerVision/PublicDataset/4Drone-Sunny-MedAlt-Nature1.jpg

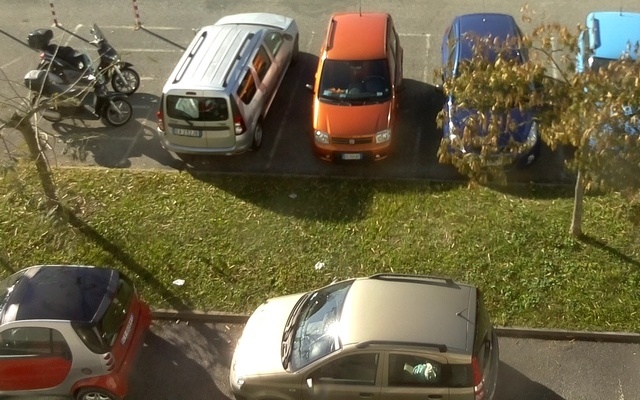
test/ComputerVision/PublicDataset/4Drone-Sunny-MedAlt-Nature1.jpg
