icecap360/DroneCapstone/test/ComputerVision/PublicDataset/4Drone-Sunny-MedAlt-Nature.jpg

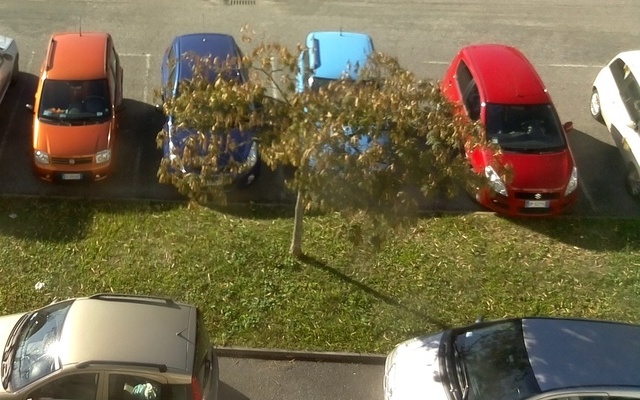
test/ComputerVision/PublicDataset/4Drone-Sunny-MedAlt-Nature.jpg
