icecap360/DroneCapstone/test/ComputerVision/PublicDataset/4Drone-Sunny-MedAlt-Occupied.jpg

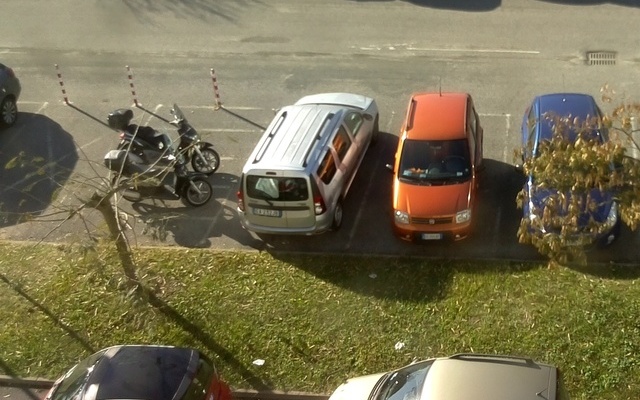
test/ComputerVision/PublicDataset/4Drone-Sunny-MedAlt-Occupied.jpg
