icecap360/DroneCapstone/test/ComputerVision/PublicDataset/4Drone-Sunny-MedAlt-ParkLot1.jpg

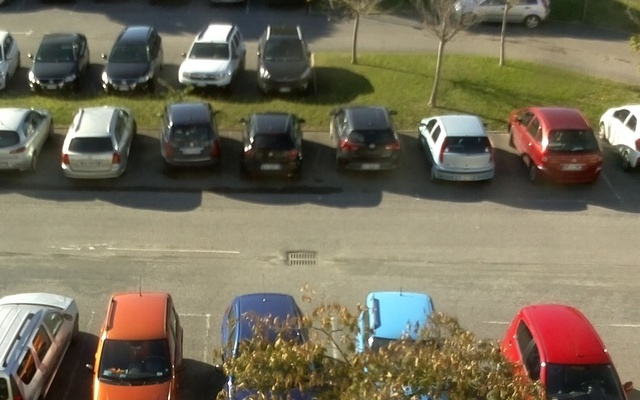
test/ComputerVision/PublicDataset/4Drone-Sunny-MedAlt-ParkLot1.jpg
