icecap360/DroneCapstone/test/ComputerVision/PublicDataset/4Drone-Sunny-MedAlt-ParkLot.jpg

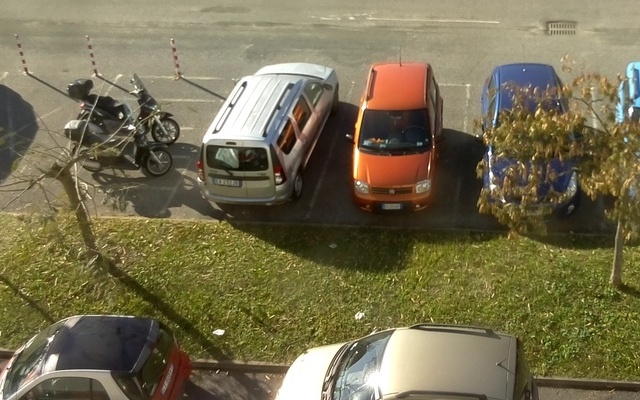
test/ComputerVision/PublicDataset/4Drone-Sunny-MedAlt-ParkLot.jpg
