icecap360/DroneCapstone/test/ComputerVision/PublicDataset/5Drone-Overcast-MedAlt-Nature.jpg

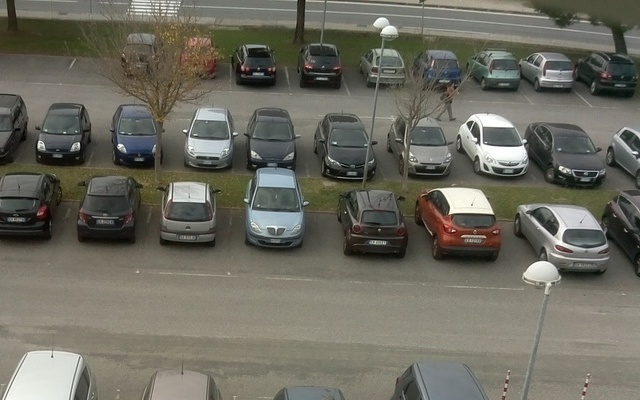
test/ComputerVision/PublicDataset/5Drone-Overcast-MedAlt-Nature.jpg
