icecap360/DroneCapstone/test/ComputerVision/PublicDataset/5Drone-Overcast-MedAlt-Occupied.jpg

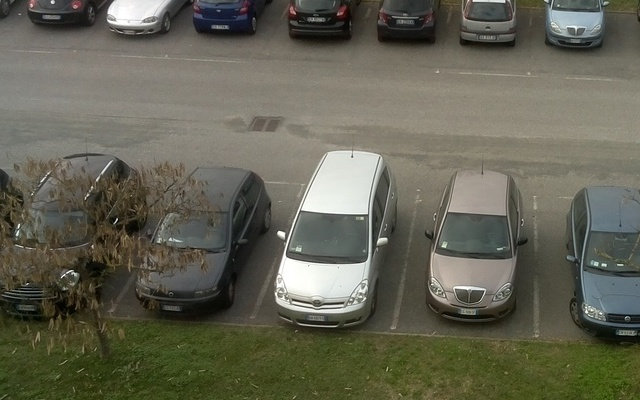
test/ComputerVision/PublicDataset/5Drone-Overcast-MedAlt-Occupied.jpg
