icecap360/DroneCapstone/test/ComputerVision/PublicDataset/5Drone-Overcast-MedAlt-ParkLot.jpg

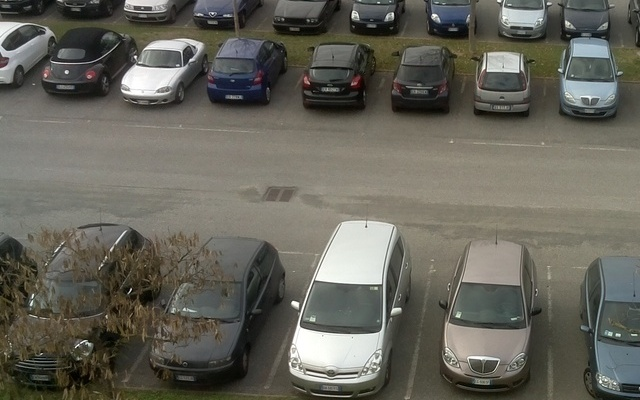
test/ComputerVision/PublicDataset/5Drone-Overcast-MedAlt-ParkLot.jpg
