icecap360/DroneCapstone/test/ComputerVision/PublicDataset/5Drone-Sunny-MedAlt-Nature.jpg

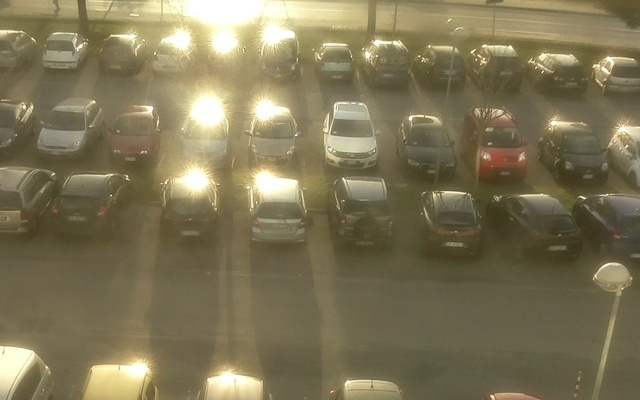
test/ComputerVision/PublicDataset/5Drone-Sunny-MedAlt-Nature.jpg
