icecap360/DroneCapstone/test/ComputerVision/PublicDataset/5Drone-Sunny-MedAlt-Occupied.jpg

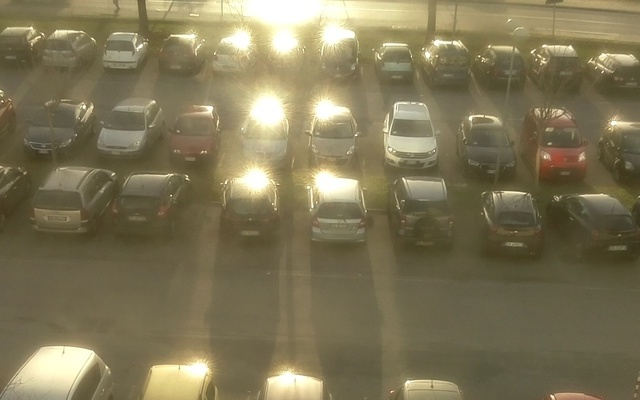
test/ComputerVision/PublicDataset/5Drone-Sunny-MedAlt-Occupied.jpg
