icecap360/DroneCapstone/test/ComputerVision/PublicDataset/5Drone-Sunny-MedAlt-ParkLot.jpg

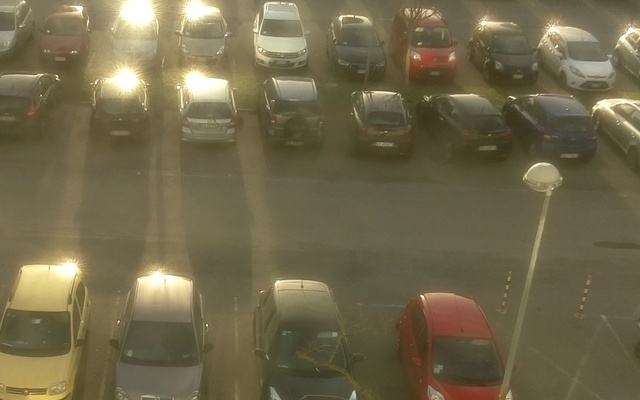
test/ComputerVision/PublicDataset/5Drone-Sunny-MedAlt-ParkLot.jpg
