icecap360/DroneCapstone/test/ComputerVision/PublicDataset/6Drone-Overcast-MedAlt-Nature.jpg

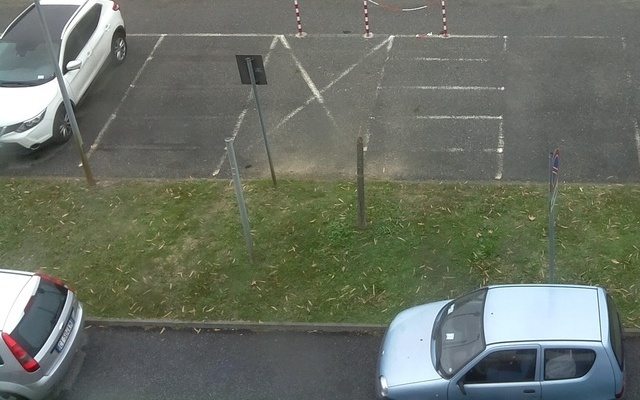
test/ComputerVision/PublicDataset/6Drone-Overcast-MedAlt-Nature.jpg
