icecap360/DroneCapstone/test/ComputerVision/PublicDataset/6Drone-Overcast-MedAlt-Occupied1.jpg

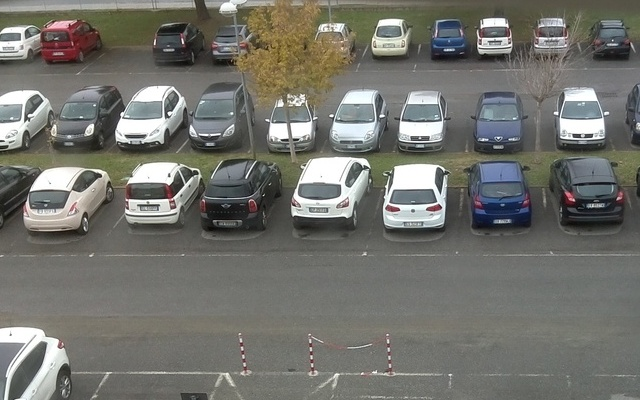
test/ComputerVision/PublicDataset/6Drone-Overcast-MedAlt-Occupied1.jpg
