icecap360/DroneCapstone/test/ComputerVision/PublicDataset/6Drone-Overcast-MedAlt-Occupied.jpg

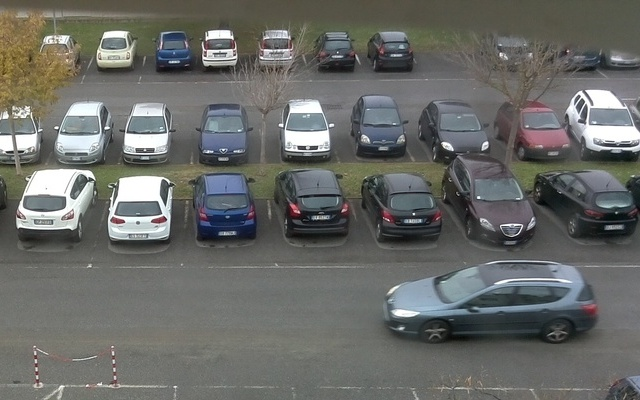
test/ComputerVision/PublicDataset/6Drone-Overcast-MedAlt-Occupied.jpg
