icecap360/DroneCapstone/test/ComputerVision/PublicDataset/6Drone-Overcast-MedAlt-ParkLot.jpg

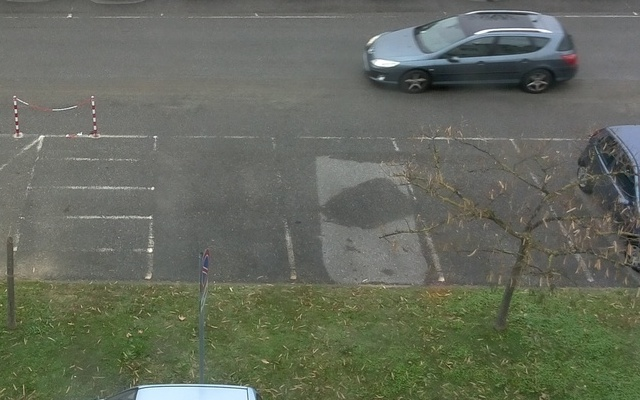
test/ComputerVision/PublicDataset/6Drone-Overcast-MedAlt-ParkLot.jpg
