icecap360/DroneCapstone/test/ComputerVision/PublicDataset/6Drone-Sunny-MedAlt-Nature.jpg

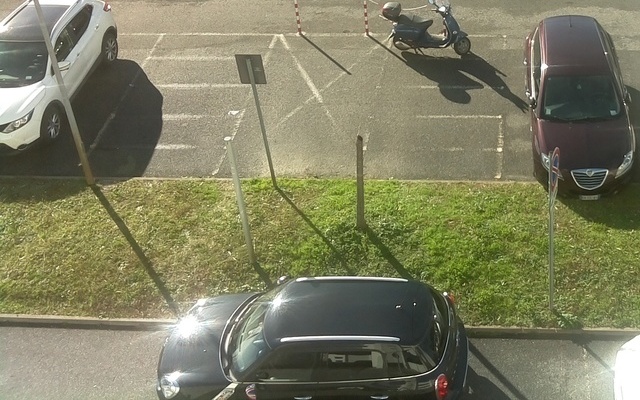
test/ComputerVision/PublicDataset/6Drone-Sunny-MedAlt-Nature.jpg
