icecap360/DroneCapstone/test/ComputerVision/PublicDataset/6Drone-Sunny-MedAlt-Occupied.jpg

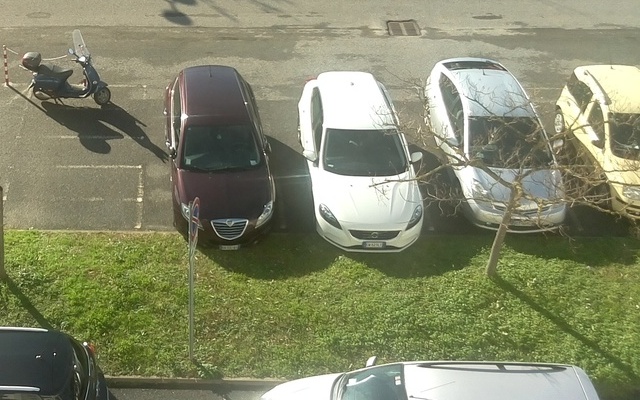
test/ComputerVision/PublicDataset/6Drone-Sunny-MedAlt-Occupied.jpg
