icecap360/DroneCapstone/test/ComputerVision/PublicDataset/6Drone-Sunny-MedAlt-ParkLot.jpg

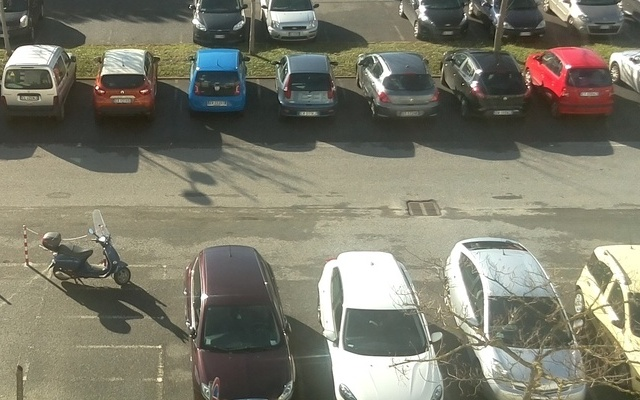
test/ComputerVision/PublicDataset/6Drone-Sunny-MedAlt-ParkLot.jpg
