icecap360/DroneCapstone/test/ComputerVision/PublicDataset/7Drone-Overcast-MedAlt-Nature.jpg

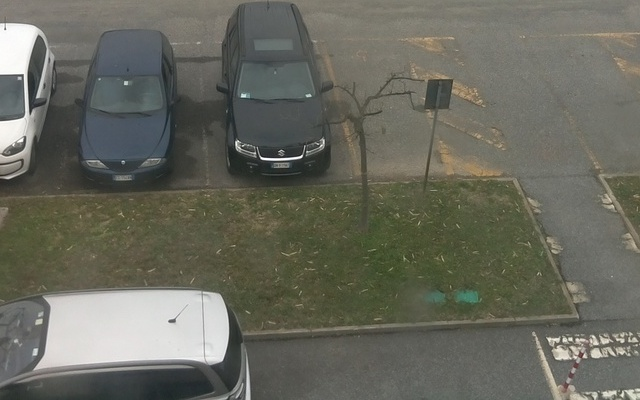
test/ComputerVision/PublicDataset/7Drone-Overcast-MedAlt-Nature.jpg
