icecap360/DroneCapstone/test/ComputerVision/PublicDataset/7Drone-Overcast-MedAlt-Occupied2.jpg

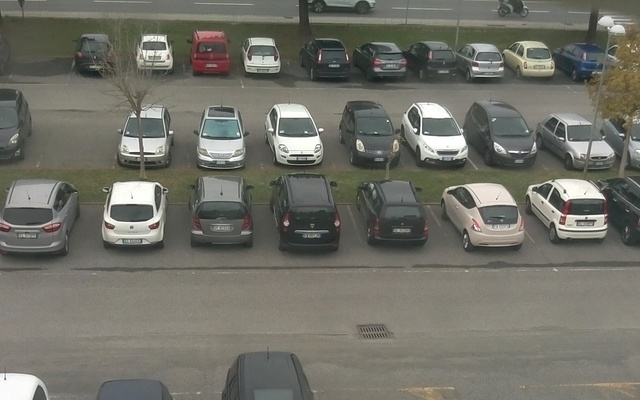
test/ComputerVision/PublicDataset/7Drone-Overcast-MedAlt-Occupied2.jpg
