icecap360/DroneCapstone/test/ComputerVision/PublicDataset/7Drone-Overcast-MedAlt-Occupied.jpg

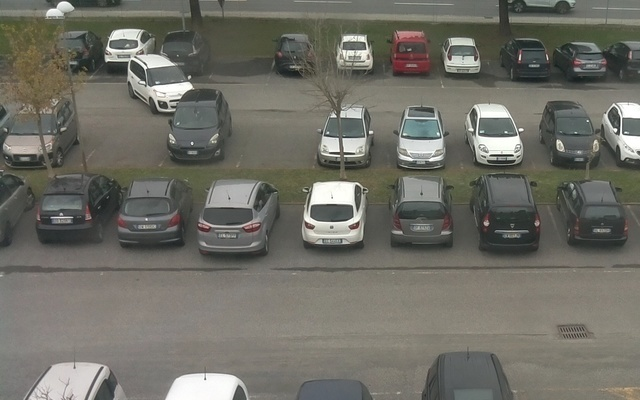
test/ComputerVision/PublicDataset/7Drone-Overcast-MedAlt-Occupied.jpg
