icecap360/DroneCapstone/test/ComputerVision/PublicDataset/7Drone-Overcast-MedAlt-ParkLot.jpg

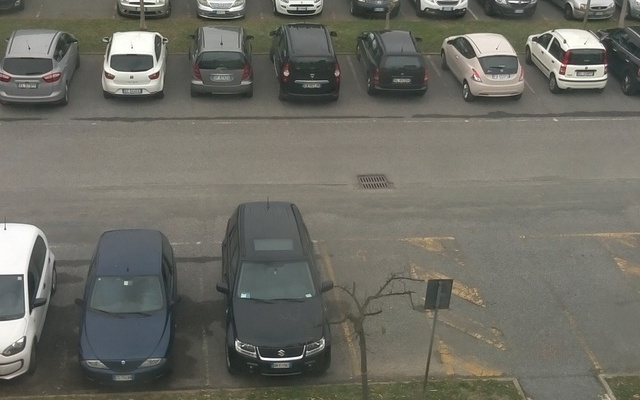
test/ComputerVision/PublicDataset/7Drone-Overcast-MedAlt-ParkLot.jpg
