icecap360/DroneCapstone/test/ComputerVision/PublicDataset/7Drone-Sunny-MedAlt-Nature.jpg

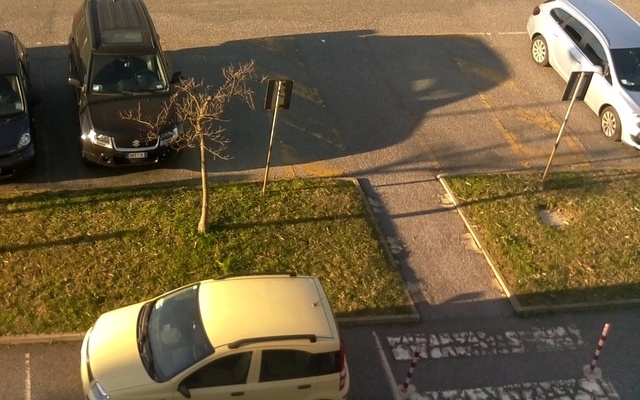
test/ComputerVision/PublicDataset/7Drone-Sunny-MedAlt-Nature.jpg
