icecap360/DroneCapstone/test/ComputerVision/PublicDataset/7Drone-Sunny-MedAlt-Occupied.jpg

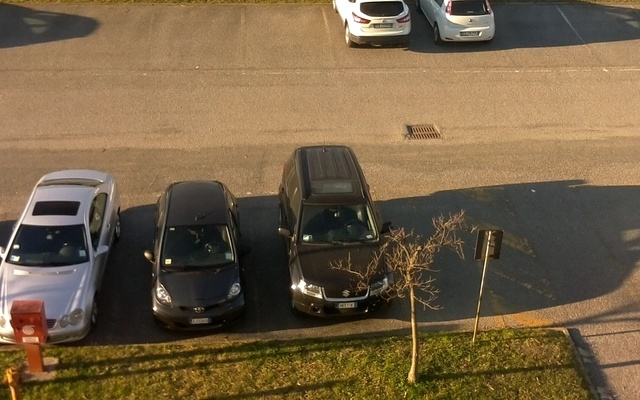
test/ComputerVision/PublicDataset/7Drone-Sunny-MedAlt-Occupied.jpg
