icecap360/DroneCapstone/test/ComputerVision/PublicDataset/7Drone-Sunny-MedAlt-ParkLot.jpg

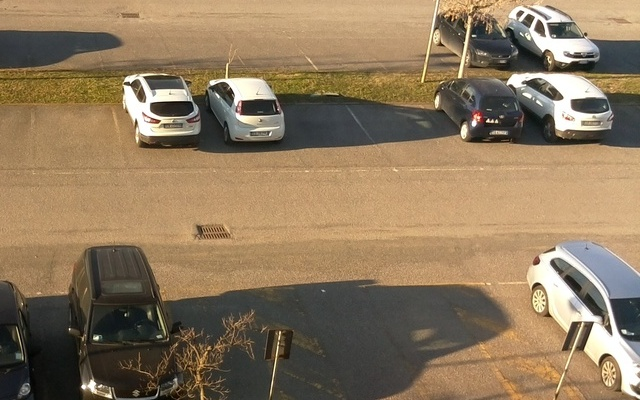
test/ComputerVision/PublicDataset/7Drone-Sunny-MedAlt-ParkLot.jpg
