icecap360/DroneCapstone/test/ComputerVision/PublicDataset/8Drone-Overcast-MedAlt-Nature.jpg

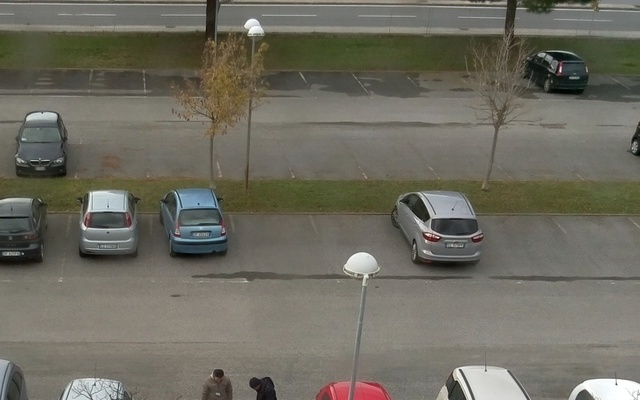
test/ComputerVision/PublicDataset/8Drone-Overcast-MedAlt-Nature.jpg
