icecap360/DroneCapstone/test/ComputerVision/PublicDataset/8Drone-Overcast-MedAlt-Occupied.jpg

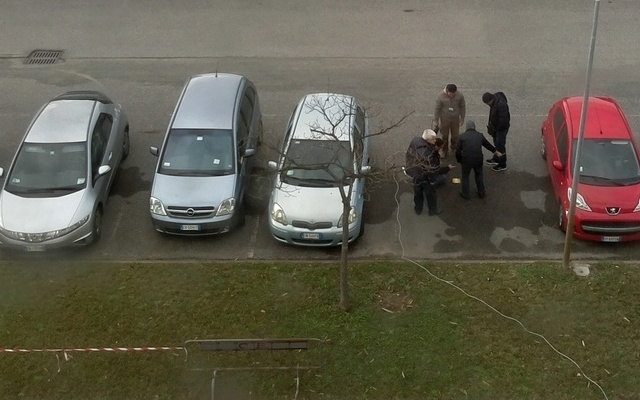
test/ComputerVision/PublicDataset/8Drone-Overcast-MedAlt-Occupied.jpg
