icecap360/DroneCapstone/test/ComputerVision/PublicDataset/8Drone-Overcast-MedAlt-ParkLot.jpg

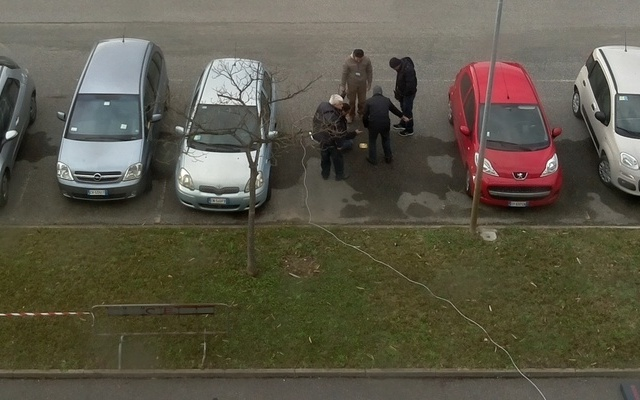
test/ComputerVision/PublicDataset/8Drone-Overcast-MedAlt-ParkLot.jpg
