icecap360/DroneCapstone/test/ComputerVision/PublicDataset/8Drone-Sunny-MedAlt-Occupied.jpg

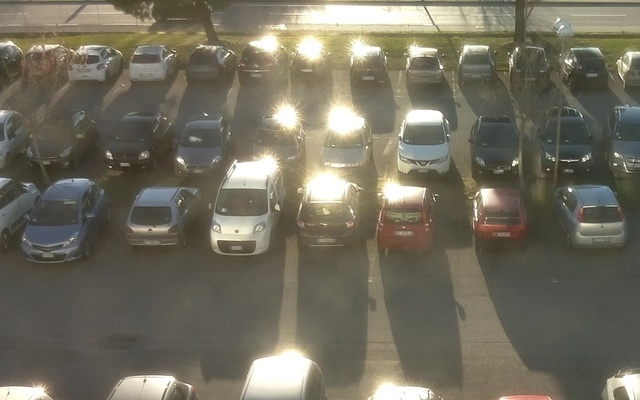
test/ComputerVision/PublicDataset/8Drone-Sunny-MedAlt-Occupied.jpg
