icecap360/DroneCapstone/test/ComputerVision/PublicDataset/8Drone-Sunny-MedAlt-ParkLot.jpg

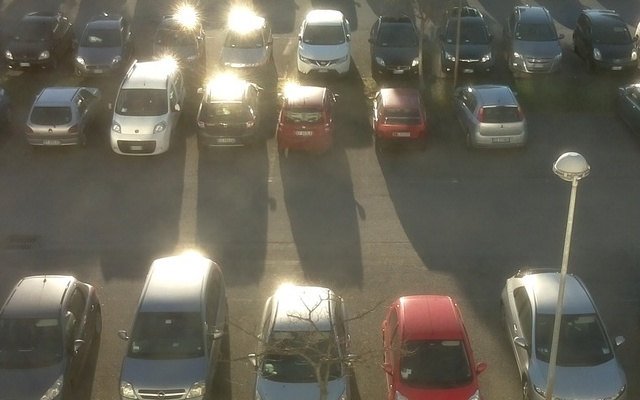
test/ComputerVision/PublicDataset/8Drone-Sunny-MedAlt-ParkLot.jpg
