icecap360/DroneCapstone/test/ComputerVision/PublicDataset/9Drone-Overcast-MedAlt-Nature1.jpg

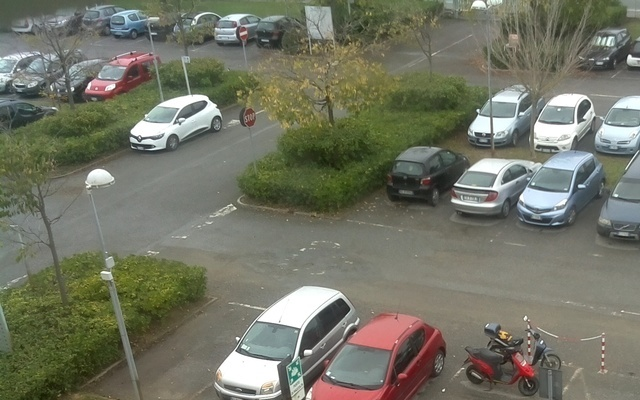
test/ComputerVision/PublicDataset/9Drone-Overcast-MedAlt-Nature1.jpg
