icecap360/DroneCapstone/test/ComputerVision/PublicDataset/9Drone-Overcast-MedAlt-Nature.jpg

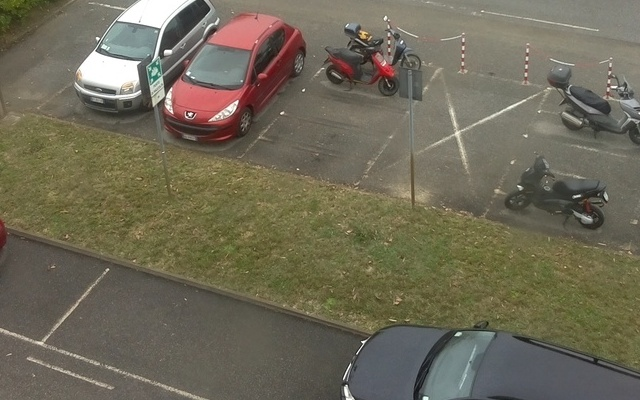
test/ComputerVision/PublicDataset/9Drone-Overcast-MedAlt-Nature.jpg
