icecap360/DroneCapstone/test/ComputerVision/PublicDataset/9Drone-Overcast-MedAlt-Occupied.jpg

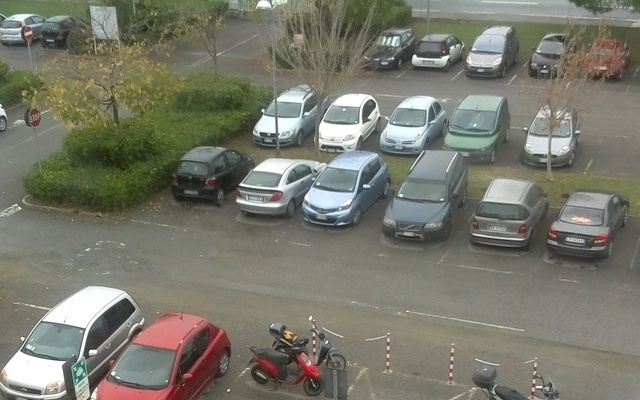
test/ComputerVision/PublicDataset/9Drone-Overcast-MedAlt-Occupied.jpg
