icecap360/DroneCapstone/test/ComputerVision/PublicDataset/9Drone-Overcast-MedAlt-ParkLot.jpg

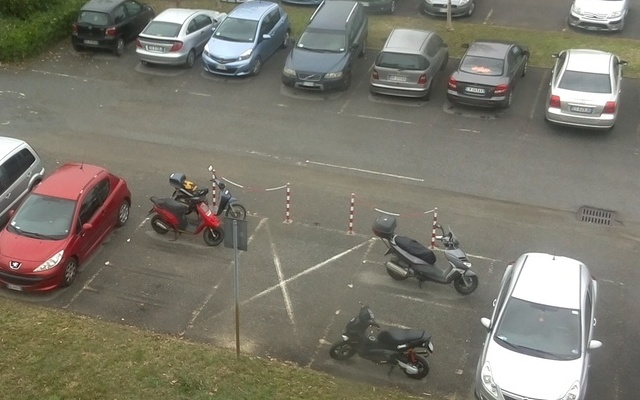
test/ComputerVision/PublicDataset/9Drone-Overcast-MedAlt-ParkLot.jpg
