icecap360/DroneCapstone/test/ComputerVision/PublicDataset/9Drone-Sunny-MedAlt-Nature.jpg

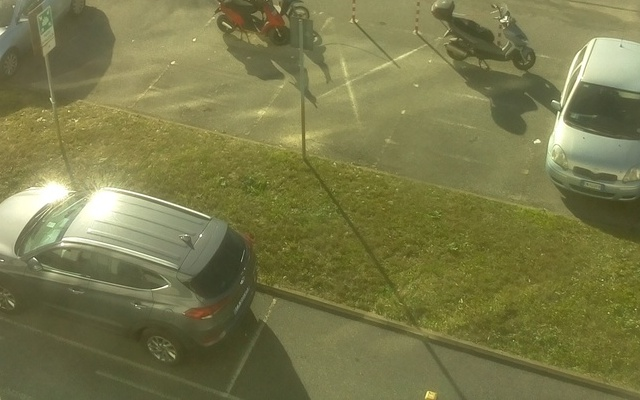
test/ComputerVision/PublicDataset/9Drone-Sunny-MedAlt-Nature.jpg
