icecap360/DroneCapstone/test/ComputerVision/PublicDataset/9Drone-Sunny-MedAlt-Occupied.jpg

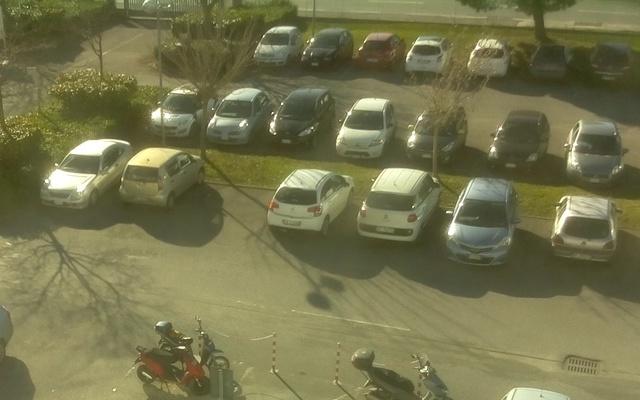
test/ComputerVision/PublicDataset/9Drone-Sunny-MedAlt-Occupied.jpg
