icecap360/DroneCapstone/test/ComputerVision/PublicDataset/9Drone-Sunny-MedAlt-ParkLot.jpg

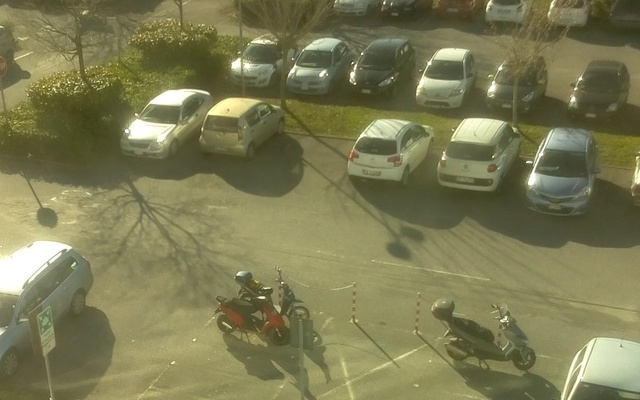
test/ComputerVision/PublicDataset/9Drone-Sunny-MedAlt-ParkLot.jpg
