icecap360/DroneCapstone/test/ComputerVision/PublicDataset/10Drone-Sunny-MedAlt-Nature.jpg

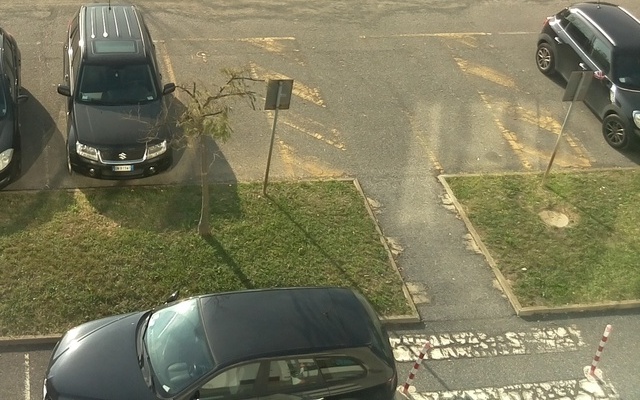
test/ComputerVision/PublicDataset/10Drone-Sunny-MedAlt-Nature.jpg
