icecap360/DroneCapstone/test/ComputerVision/PublicDataset/10Drone-Sunny-MedAlt-Occupied.jpg

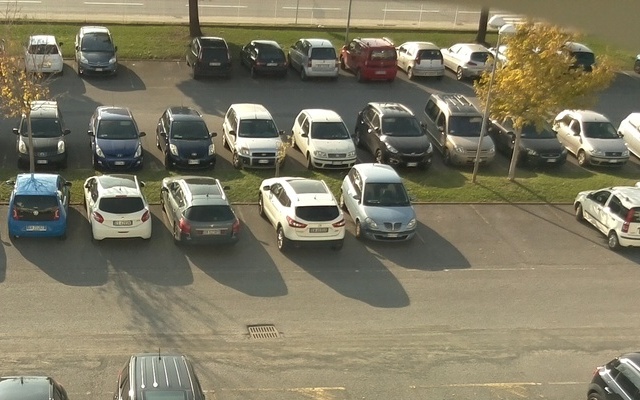
test/ComputerVision/PublicDataset/10Drone-Sunny-MedAlt-Occupied.jpg
