icecap360/DroneCapstone/test/ComputerVision/PublicDataset/10Drone-Sunny-MedAlt-ParkLot.jpg

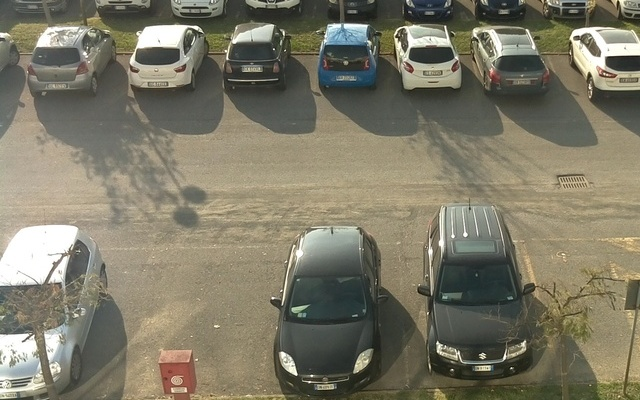
test/ComputerVision/PublicDataset/10Drone-Sunny-MedAlt-ParkLot.jpg
