icecap360/DroneCapstone/test/ComputerVision/SattaliteImagery/FP00.png

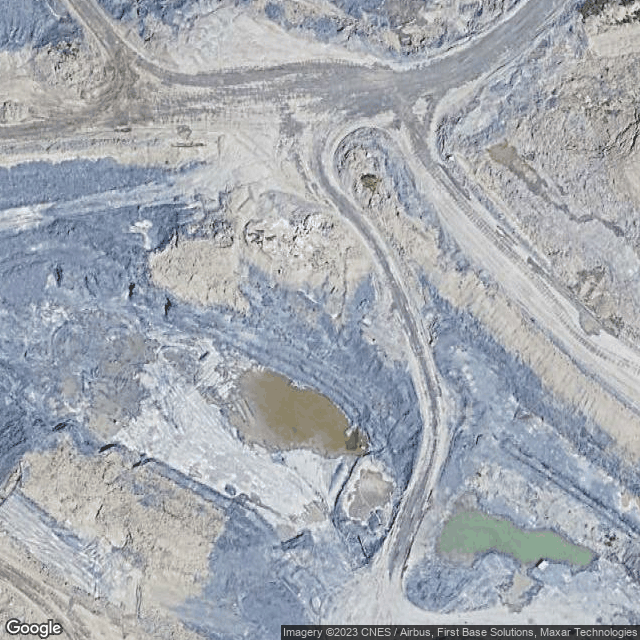
test/ComputerVision/SattaliteImagery/FP00.png
