icecap360/DroneCapstone/test/ComputerVision/SattaliteImagery/FP01.png

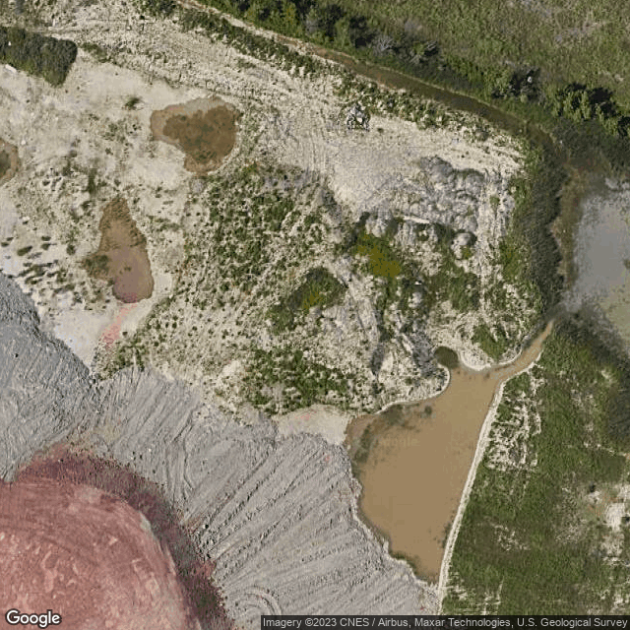
test/ComputerVision/SattaliteImagery/FP01.png
