icecap360/DroneCapstone/test/ComputerVision/SattaliteImagery/FP02.png

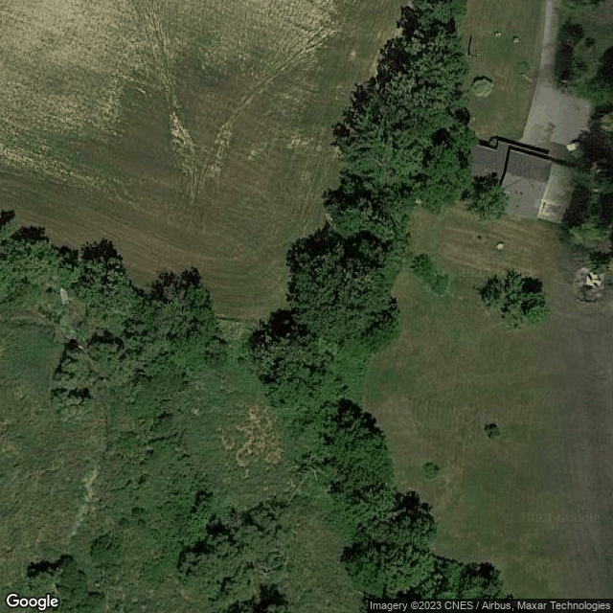
test/ComputerVision/SattaliteImagery/FP02.png
