icecap360/DroneCapstone/test/ComputerVision/SattaliteImagery/FP03.png

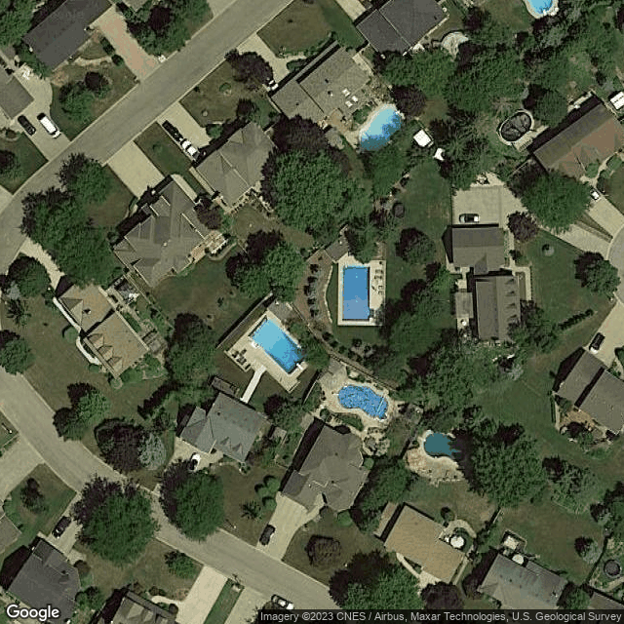
test/ComputerVision/SattaliteImagery/FP03.png
