icecap360/DroneCapstone/test/ComputerVision/SattaliteImagery/FP04.png

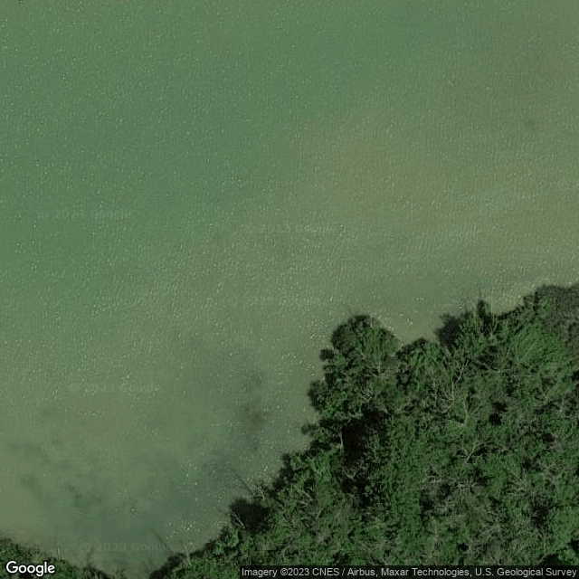
test/ComputerVision/SattaliteImagery/FP04.png
