icecap360/DroneCapstone/test/ComputerVision/SattaliteImagery/FP05.png

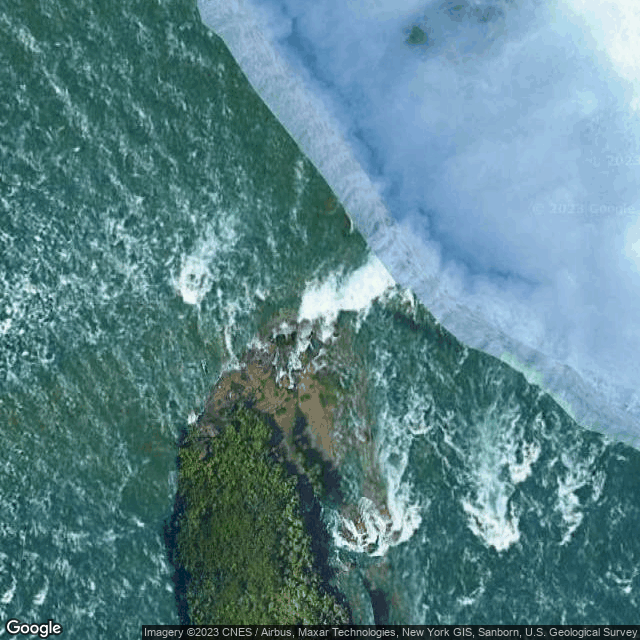
test/ComputerVision/SattaliteImagery/FP05.png
