icecap360/DroneCapstone/test/ComputerVision/SattaliteImagery/ParkingLot00.png

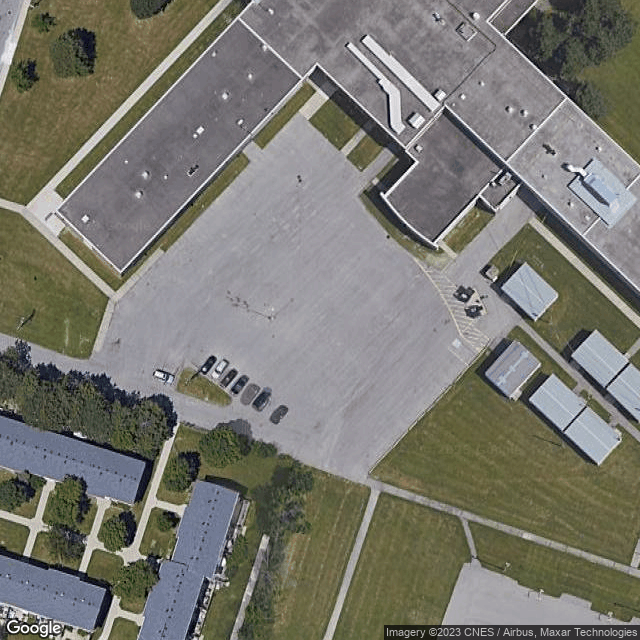
test/ComputerVision/SattaliteImagery/ParkingLot00.png
