icecap360/DroneCapstone/test/ComputerVision/SattaliteImagery/ParkingLot01.png

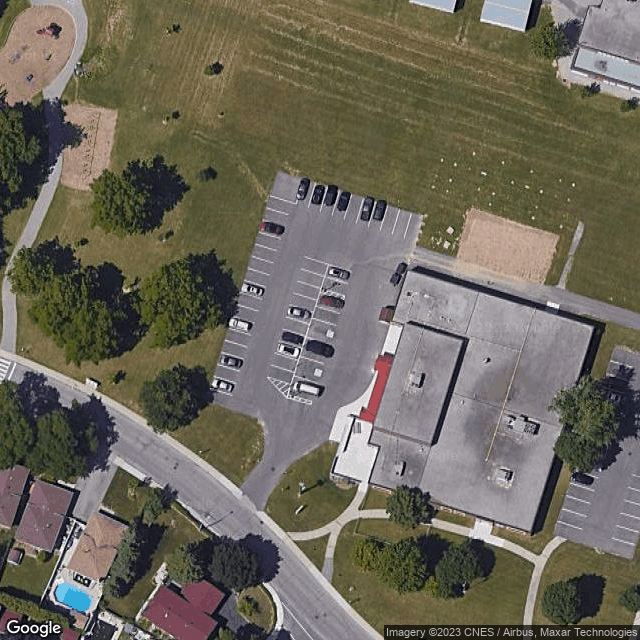
test/ComputerVision/SattaliteImagery/ParkingLot01.png
