icecap360/DroneCapstone/test/ComputerVision/SattaliteImagery/ParkingLot02.png

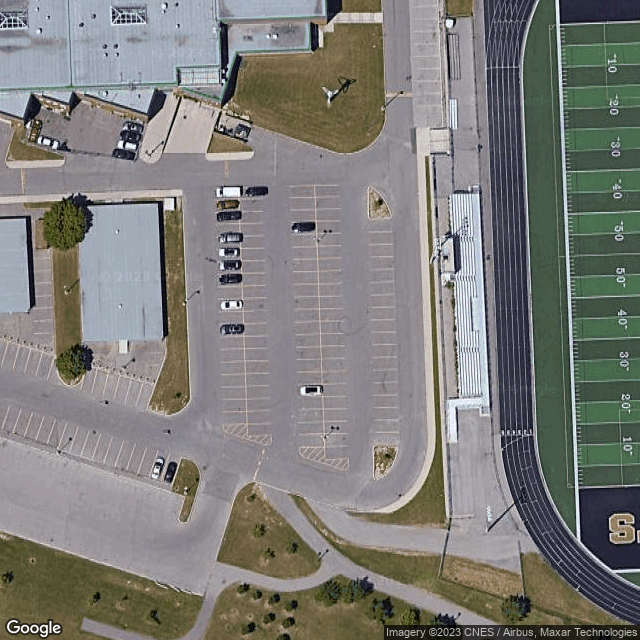
test/ComputerVision/SattaliteImagery/ParkingLot02.png
