icecap360/DroneCapstone/test/ComputerVision/SattaliteImagery/ParkingLot03.png

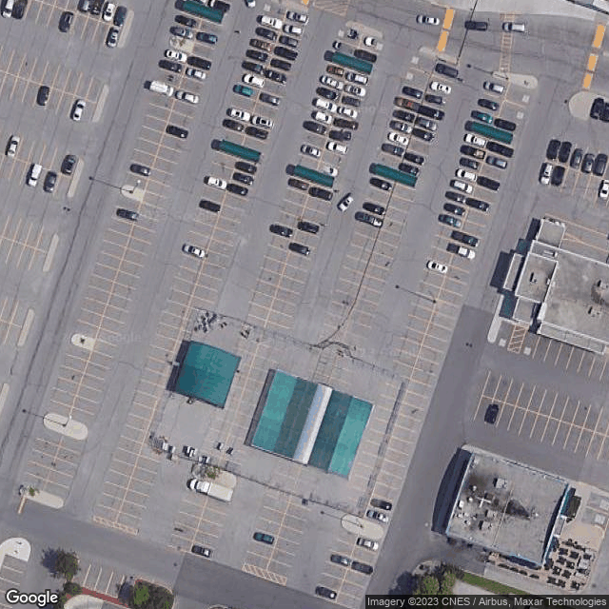
test/ComputerVision/SattaliteImagery/ParkingLot03.png
