icecap360/DroneCapstone/test/ComputerVision/SattaliteImagery/ParkingLot04.png

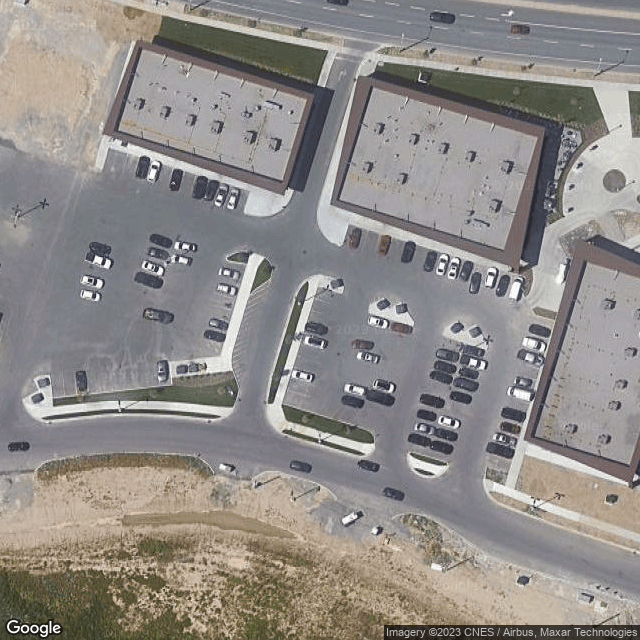
test/ComputerVision/SattaliteImagery/ParkingLot04.png
