icecap360/DroneCapstone/test/ComputerVision/SattaliteImagery/ParkingLot05.png

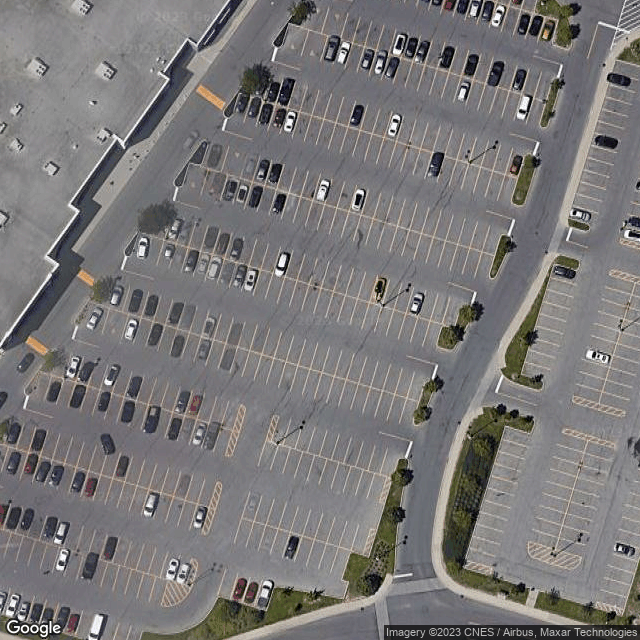
test/ComputerVision/SattaliteImagery/ParkingLot05.png
