icecap360/DroneCapstone/test/ComputerVision/SattaliteImagery/ParkingLot06.png

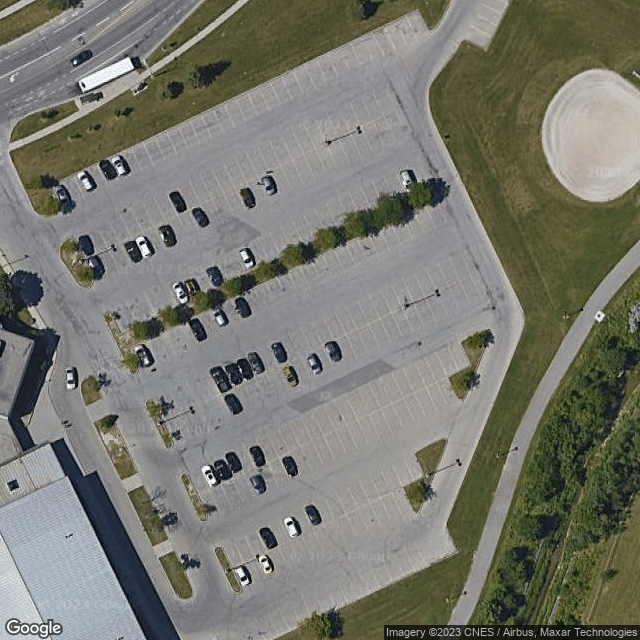
test/ComputerVision/SattaliteImagery/ParkingLot06.png
