icecap360/DroneCapstone/test/ComputerVision/SattaliteImagery/ParkingLot07.png

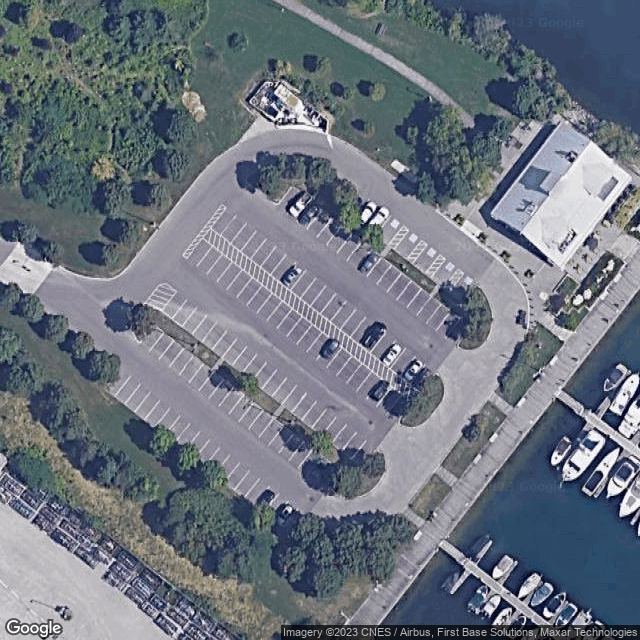
test/ComputerVision/SattaliteImagery/ParkingLot07.png
