icecap360/DroneCapstone/test/ComputerVision/SattaliteImagery/ParkingLot08.png

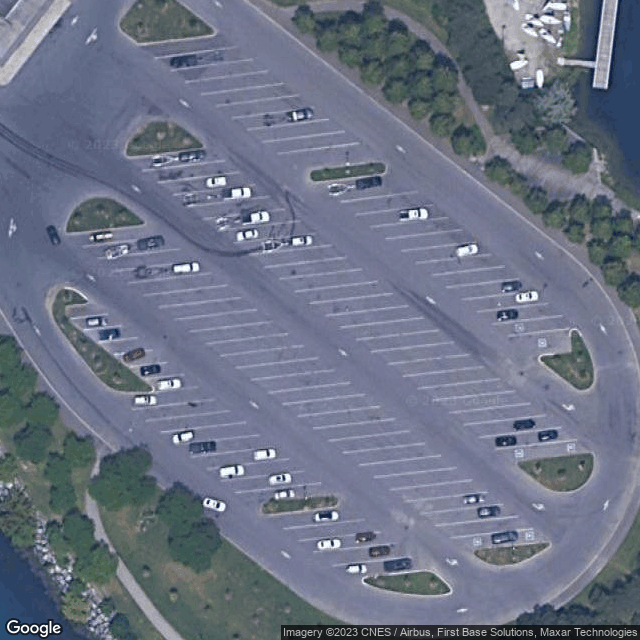
test/ComputerVision/SattaliteImagery/ParkingLot08.png
