icecap360/DroneCapstone/test/ComputerVision/SattaliteImagery/ParkingLot09.png

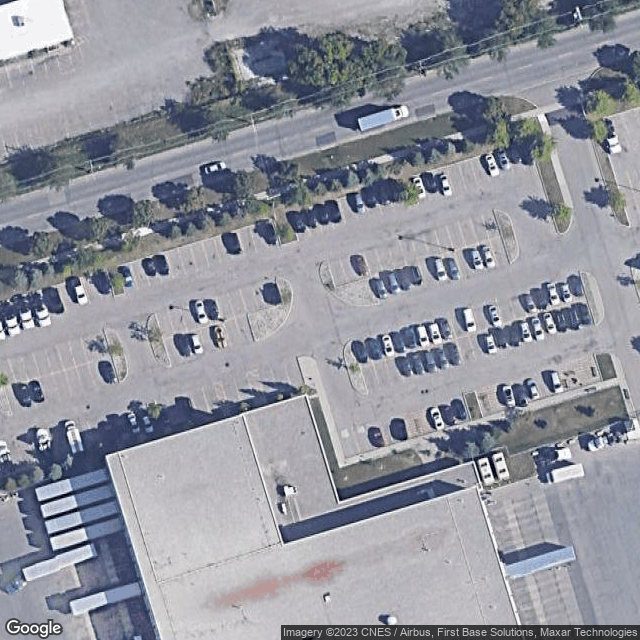
test/ComputerVision/SattaliteImagery/ParkingLot09.png
