icecap360/DroneCapstone/test/ComputerVision/SattaliteImagery/ParkingLot10.png

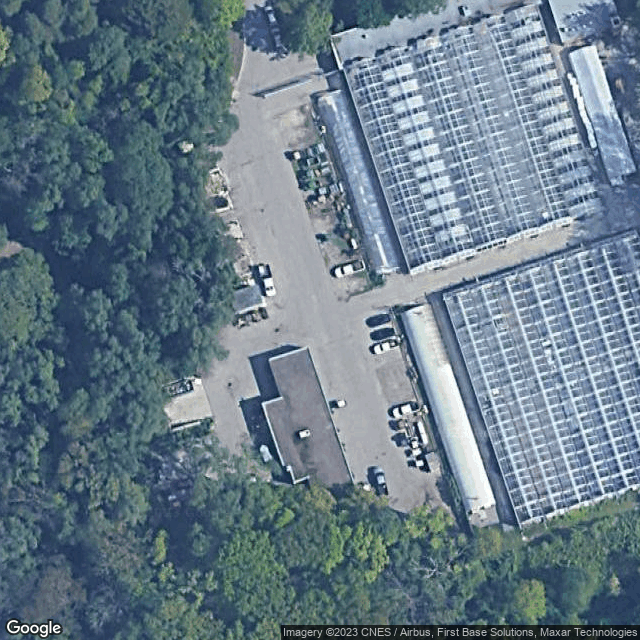
test/ComputerVision/SattaliteImagery/ParkingLot10.png
