icecap360/DroneCapstone/test/ComputerVision/SattaliteImagery/ParkingLot11.png

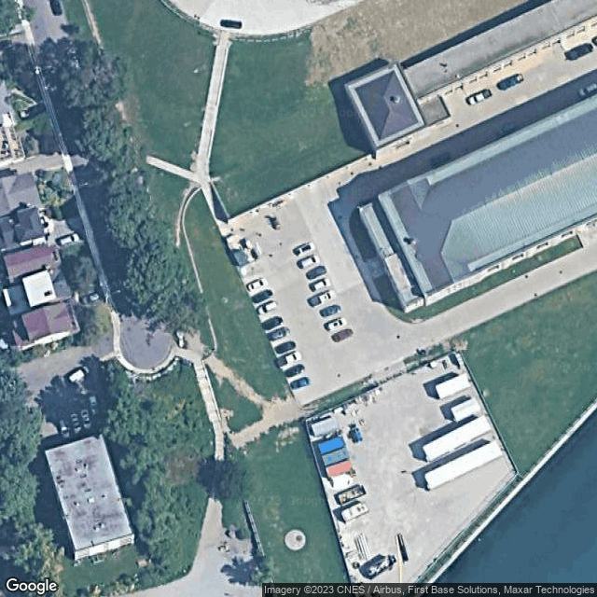
test/ComputerVision/SattaliteImagery/ParkingLot11.png
