icecap360/DroneCapstone/test/ComputerVision/SattaliteImagery/ParkingLot12.png

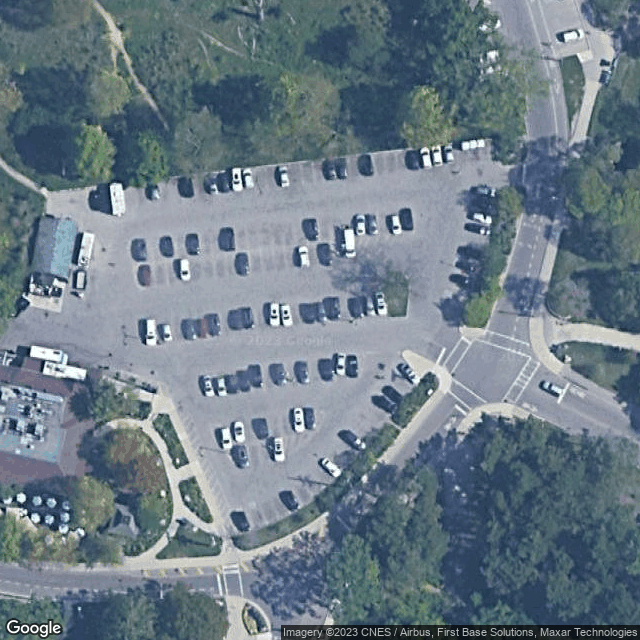
test/ComputerVision/SattaliteImagery/ParkingLot12.png
