icecap360/DroneCapstone/test/ComputerVision/SattaliteImagery/ParkingLot13.png

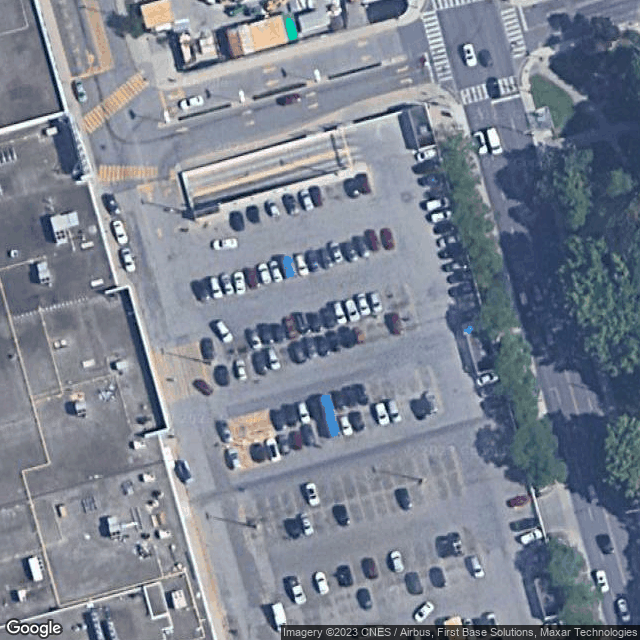
test/ComputerVision/SattaliteImagery/ParkingLot13.png
