icecap360/DroneCapstone/test/ComputerVision/SattaliteImagery/ParkingLot14.png

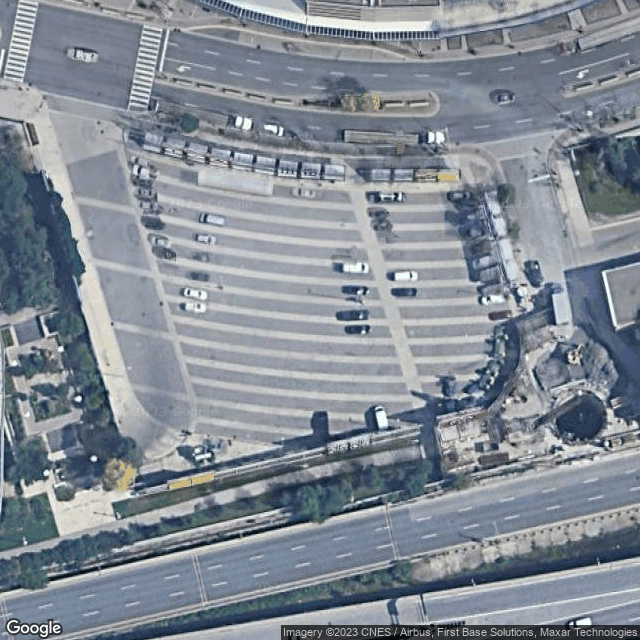
test/ComputerVision/SattaliteImagery/ParkingLot14.png
