icecap360/DroneCapstone/test/ComputerVision/SattaliteImagery/ParkingLot15.png

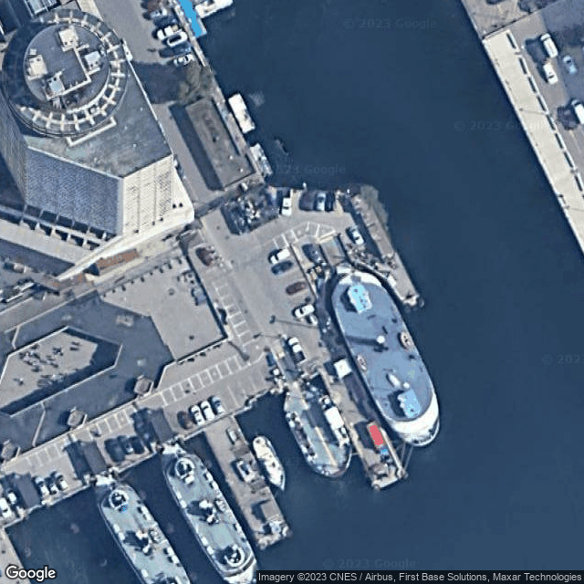
test/ComputerVision/SattaliteImagery/ParkingLot15.png
