icecap360/DroneCapstone/test/ComputerVision/SattaliteImagery/ParkingLot16.png

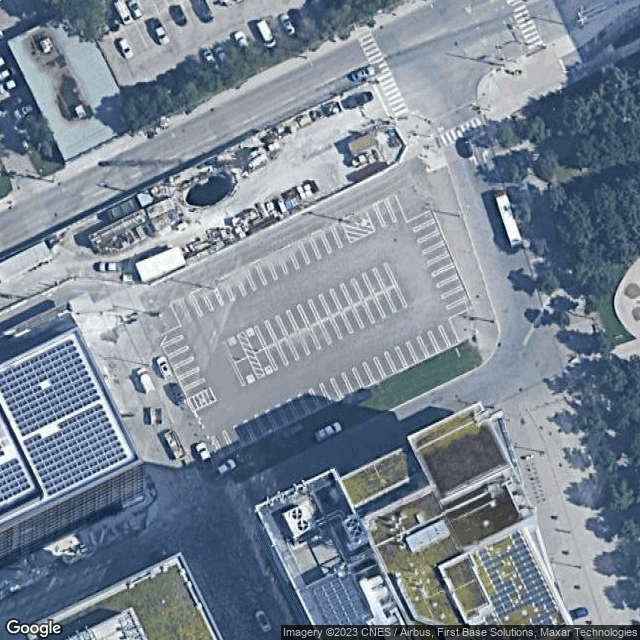
test/ComputerVision/SattaliteImagery/ParkingLot16.png
