icecap360/DroneCapstone/test/ComputerVision/SattaliteImagery/ParkingLot17.png

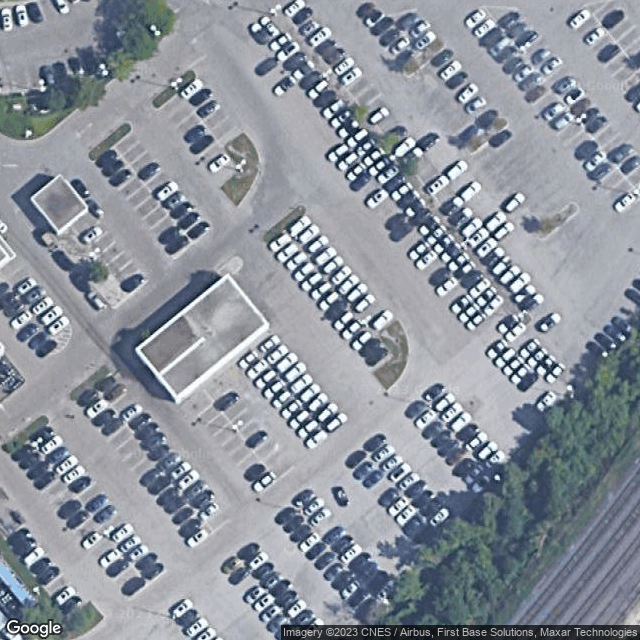
test/ComputerVision/SattaliteImagery/ParkingLot17.png
