icecap360/DroneCapstone/test/ComputerVision/SattaliteImagery/ParkingLot18.png

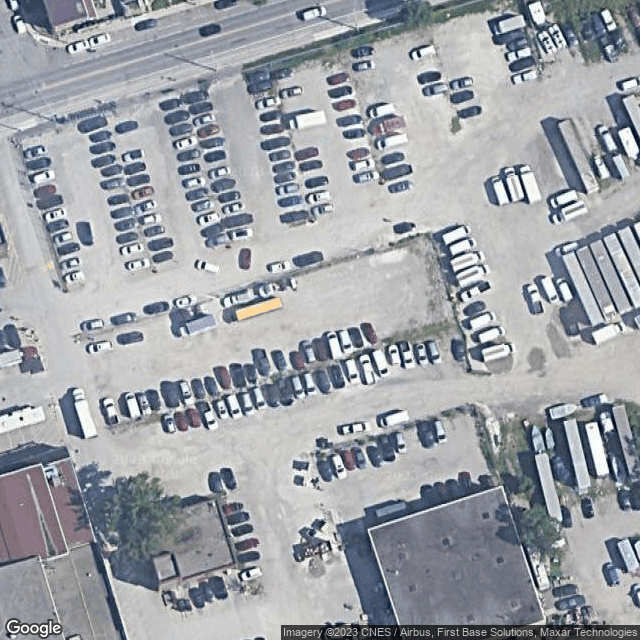
test/ComputerVision/SattaliteImagery/ParkingLot18.png
