icecap360/DroneCapstone/test/ComputerVision/SattaliteImagery/ParkingLot19.png

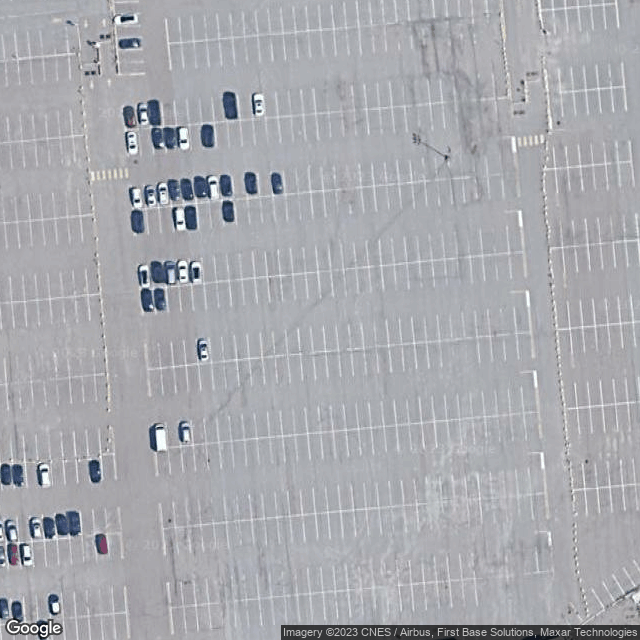
test/ComputerVision/SattaliteImagery/ParkingLot19.png
