icecap360/DroneCapstone/test/ComputerVision/SattaliteImagery/ParkingLot20.png

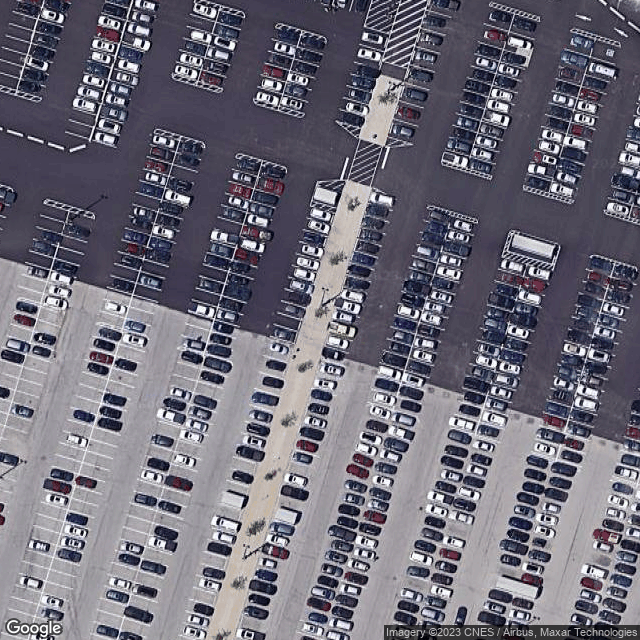
test/ComputerVision/SattaliteImagery/ParkingLot20.png
