icecap360/DroneCapstone/test/ComputerVision/UncroppedPublicImages/1Drone-Overcast-MedAlt.jpg

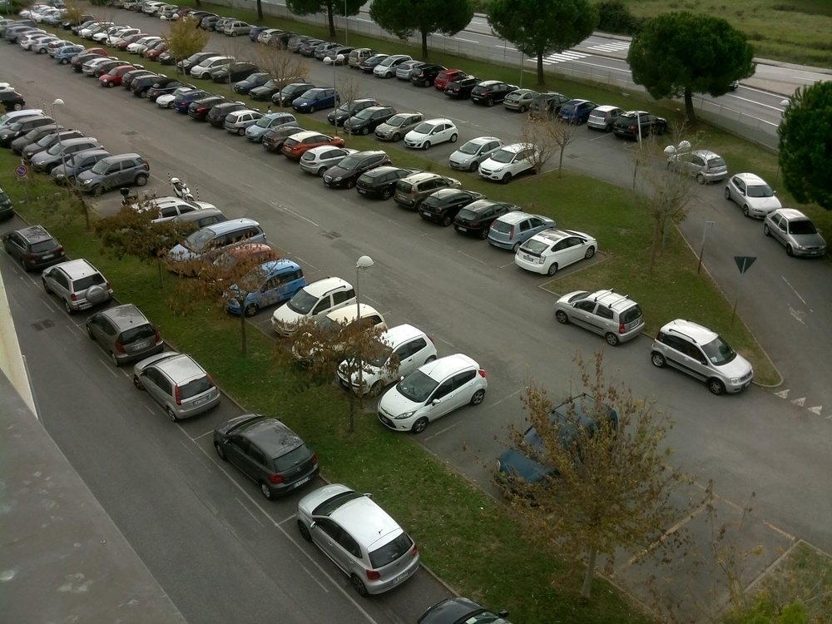
test/ComputerVision/UncroppedPublicImages/1Drone-Overcast-MedAlt.jpg
