icecap360/DroneCapstone/test/ComputerVision/UncroppedPublicImages/3Drone-Overcast-MedAlt.jpg

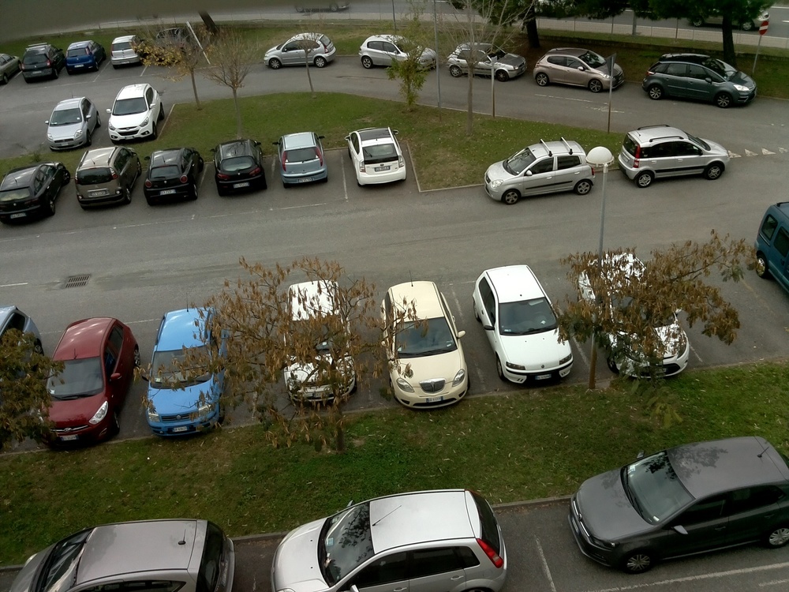
test/ComputerVision/UncroppedPublicImages/3Drone-Overcast-MedAlt.jpg
