icecap360/DroneCapstone/test/ComputerVision/UncroppedPublicImages/4Drone-Overcast-MedAlt.jpg

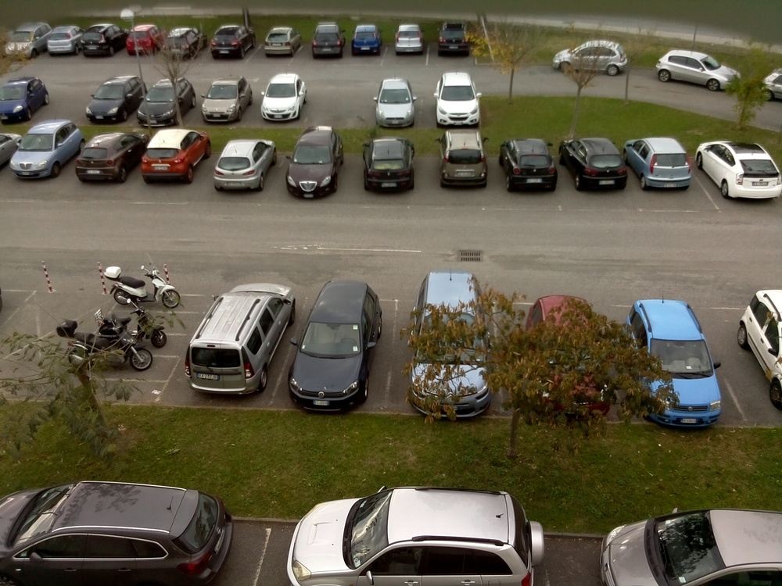
test/ComputerVision/UncroppedPublicImages/4Drone-Overcast-MedAlt.jpg
