icecap360/DroneCapstone/test/ComputerVision/UncroppedPublicImages/5Drone-Overcast-MedAlt.jpg

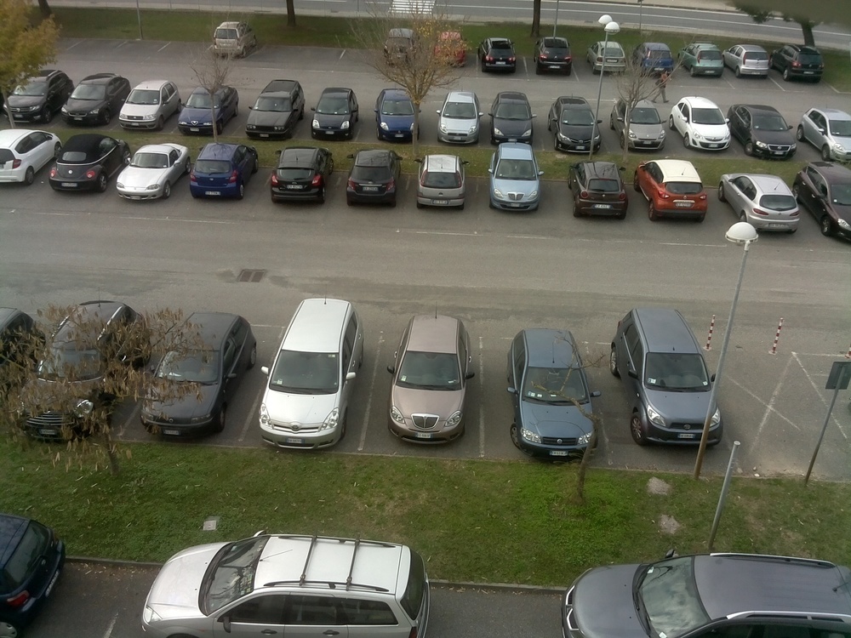
test/ComputerVision/UncroppedPublicImages/5Drone-Overcast-MedAlt.jpg
