icecap360/DroneCapstone/test/ComputerVision/UncroppedPublicImages/5Drone-Sunny-MedAlt.jpg

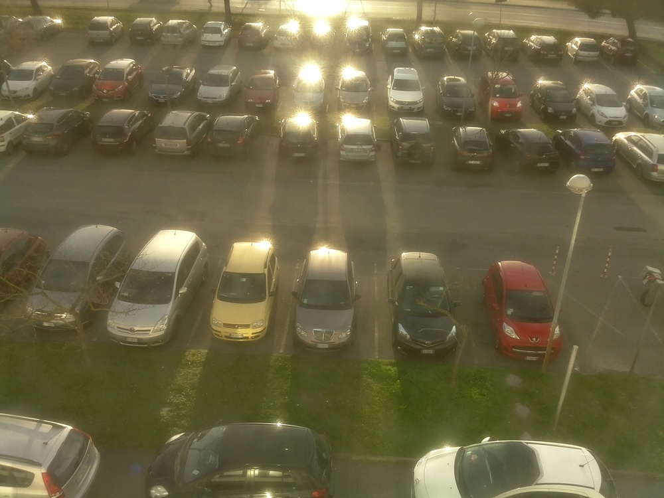
test/ComputerVision/UncroppedPublicImages/5Drone-Sunny-MedAlt.jpg
