icecap360/DroneCapstone/test/ComputerVision/UncroppedPublicImages/6Drone-Overcast-MedAlt.jpg

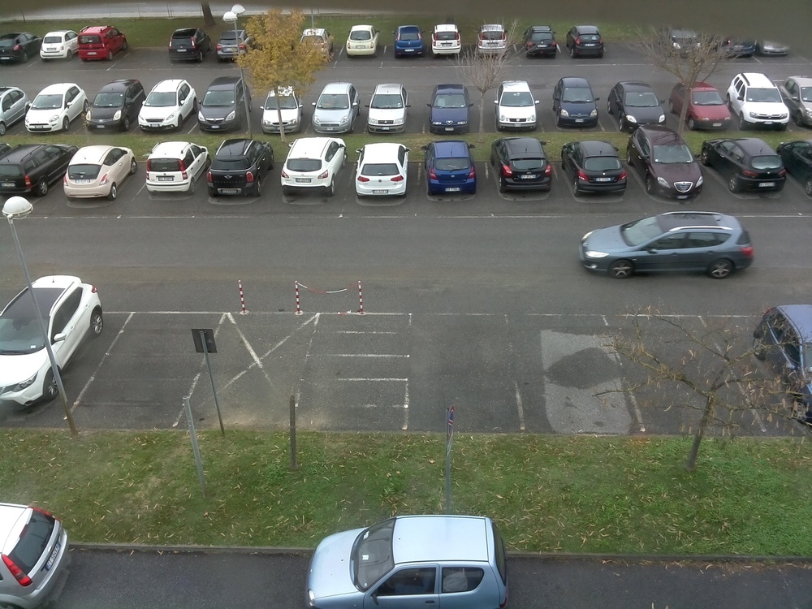
test/ComputerVision/UncroppedPublicImages/6Drone-Overcast-MedAlt.jpg
