icecap360/DroneCapstone/test/ComputerVision/UncroppedPublicImages/6Drone-Sunny-MedAlt.jpg

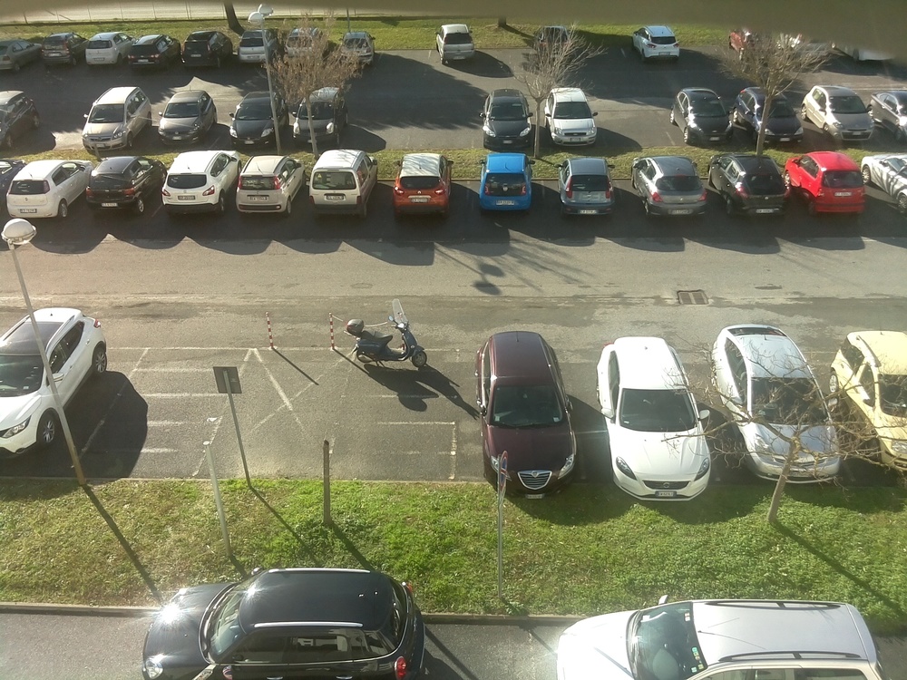
test/ComputerVision/UncroppedPublicImages/6Drone-Sunny-MedAlt.jpg
