icecap360/DroneCapstone/test/ComputerVision/UncroppedPublicImages/7Drone-Overcast-MedAlt.jpg

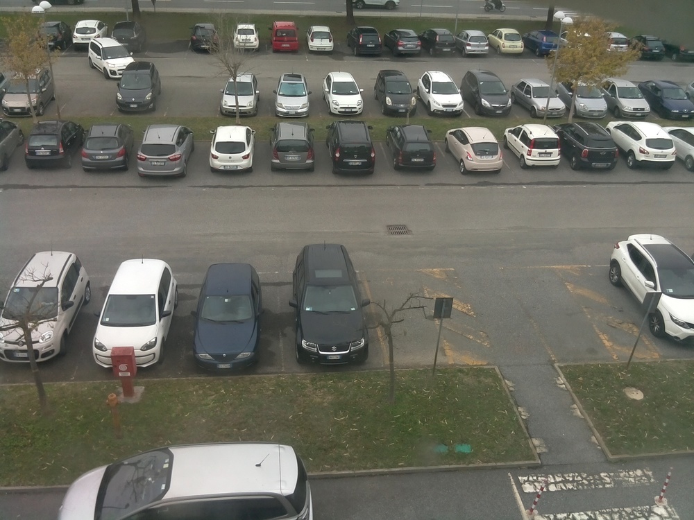
test/ComputerVision/UncroppedPublicImages/7Drone-Overcast-MedAlt.jpg
