icecap360/DroneCapstone/test/ComputerVision/UncroppedPublicImages/7Drone-Sunny-MedAlt.jpg

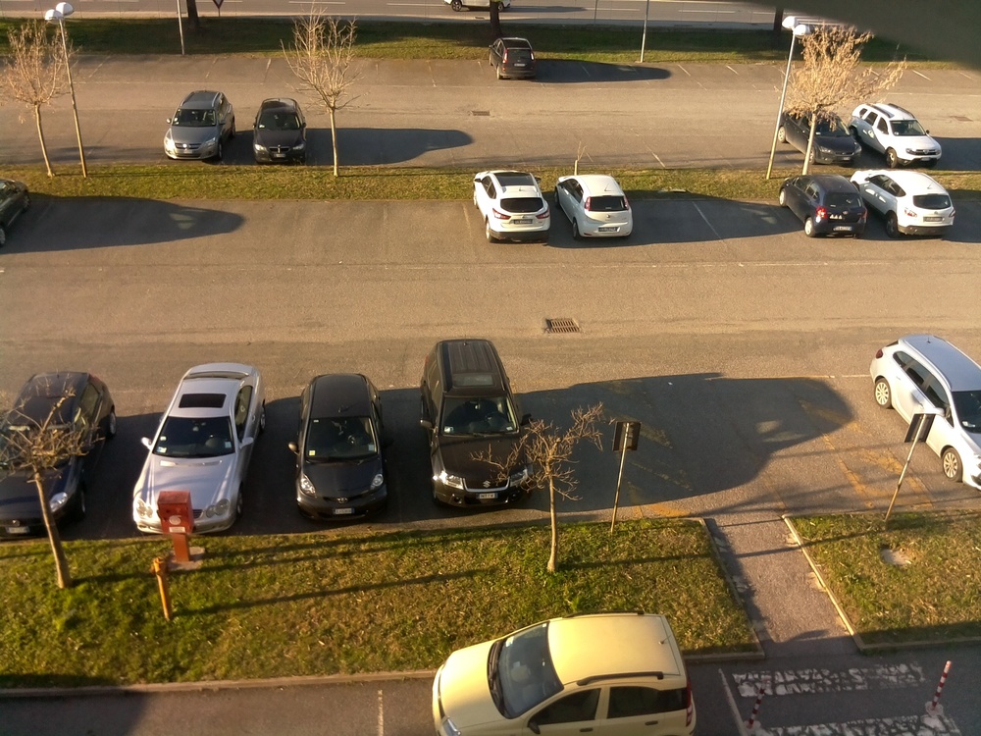
test/ComputerVision/UncroppedPublicImages/7Drone-Sunny-MedAlt.jpg
