icecap360/DroneCapstone/test/ComputerVision/UncroppedPublicImages/8Drone-Overcast-MedAlt.jpg

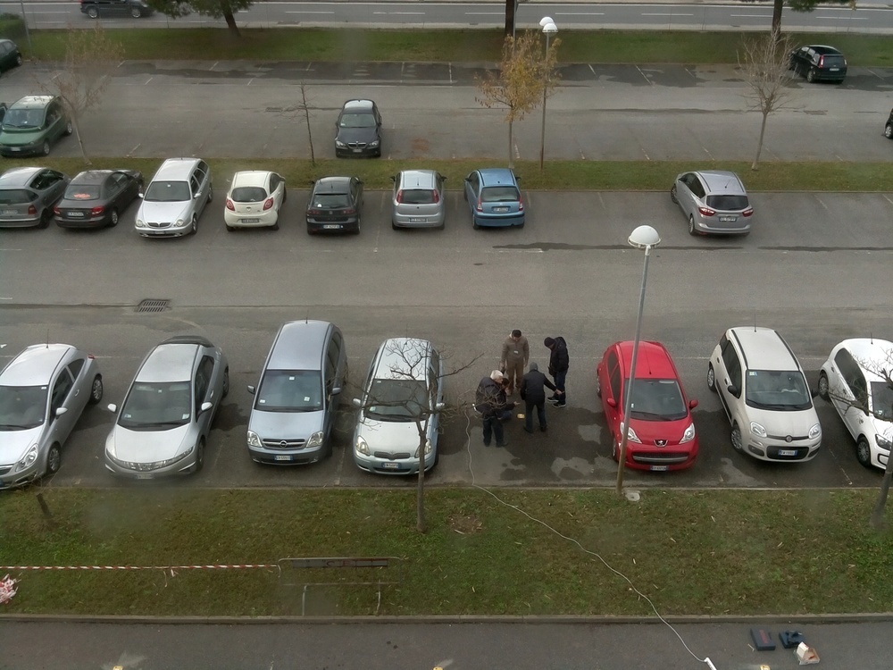
test/ComputerVision/UncroppedPublicImages/8Drone-Overcast-MedAlt.jpg
