icecap360/DroneCapstone/test/ComputerVision/UncroppedPublicImages/8Drone-Sunny-MedAlt.jpg

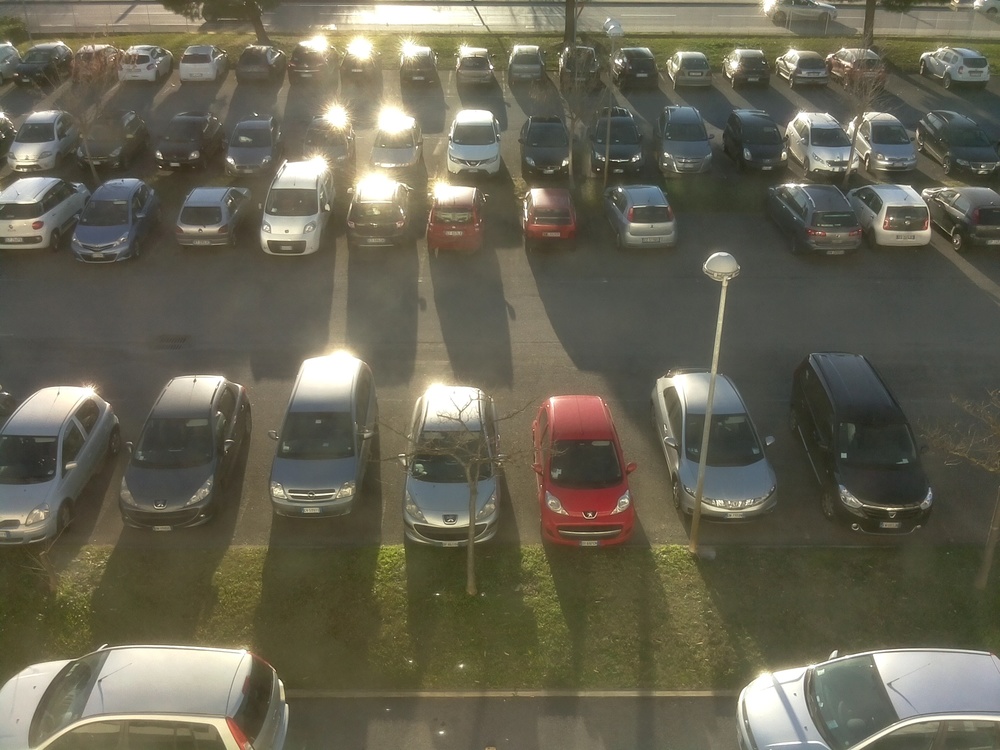
test/ComputerVision/UncroppedPublicImages/8Drone-Sunny-MedAlt.jpg
