icecap360/DroneCapstone/test/ComputerVision/UncroppedPublicImages/9Drone-Overcast-MedAlt.jpg

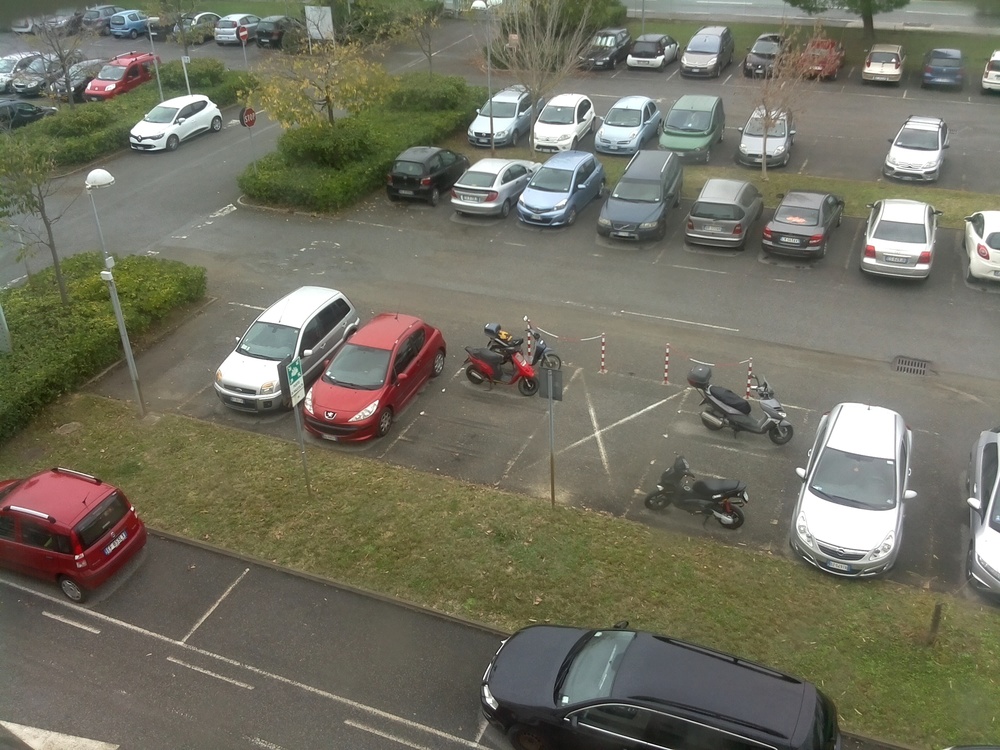
test/ComputerVision/UncroppedPublicImages/9Drone-Overcast-MedAlt.jpg
