icecap360/DroneCapstone/test/ComputerVision/UncroppedPublicImages/9Drone-Sunny-MedAlt.jpg

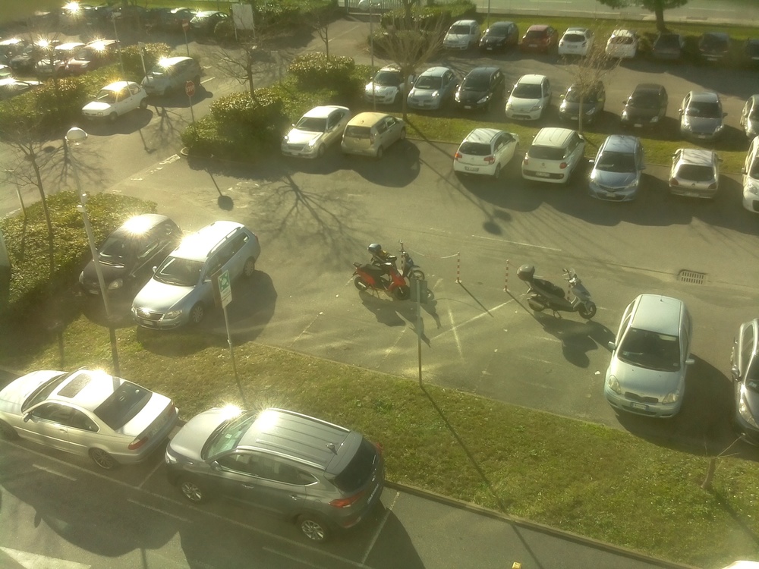
test/ComputerVision/UncroppedPublicImages/9Drone-Sunny-MedAlt.jpg
