icecap360/DroneCapstone/(threads)

Thread 5 (2022-10-09):

Team29 Review: Community impact requirements

davidwyao, 2022-10-09:
@CSchank

I noticed in section 2.3 you mention minimizing the drone's impact on its surroundings from noise pollution and privacy concerns, among others. There is a security requirement to protect privacy, but I'd suggest further clarification on what "external parties" are. Make sure to include any first party privacy measures as well, I wasn't able to find a requirement for minimizing noise from the drone's propellers, which I think may be useful.

WinnieTrandinh, 2023-04-04:
Definition of 'External Parties' have been added to definitions.
Noise and distractions are addressed within SAFE_001 and SAFE_004.

Closed 2023-04-04.

Thread 8 (2022-10-20):

Establish communication between PC and ROS.

WinnieTrandinh, 2022-10-20:
Bidirectional communication required.
PC -> ROS: send commands
ROS -> PC: send sensor info (x, y, z, yaw, pitch, roll, camera)

Closed 2023-04-04.

Thread 14 (2022-10-24):

Team 28 Review: FMEA

Rolyap-gh, 2022-10-24:
The list of Failure Modes is comprehensive, however all of the recognized Failures Modes (apart from H-011) are described as being related to functional issues with drone performance, rather than harm to human involvement with the system (ie. operator, drivers, maintenance staff, etc). I would suggest there be more consideration of how these malfunctions ultimately harm humans or their property.

WinnieTrandinh, 2023-04-05:
The system environment only consists of the product and the Operator, which is the user. Thus, only that case is considered.
Further interactions with the environment, such as with the drivers and the property, are further specified within the SRS and User Manual.

Closed 2023-04-05.

Thread 15 (2022-10-24):

Team 28 Review: Safety and Security Requirements

Dharakverma, 2022-10-24:
It took quite some time to find any issues with this HA. Great work!

If I had to comment on something, I would say that SR_004 and SR_005 are the same safety requirements, with SR_005 being a subset of SR_004. I would recommend either splitting SR_004 into multiple subsets based on the important sensors which require redundancy.

WinnieTrandinh, 2023-04-04:
Although they may be related, we decided to keep them seperate as localization does not require height estimation, and vice versa. They also serve different purposes, as localization is used for autonomous flight and guidance, whereas height is for landing only.

Thread 16 (2022-11-06):

Team 27 VnV Plan Review: Ambiguity in some test cases

aggarwal-h, 2022-11-06:
Overall, this VnV Plan is very well done!

One issue I noticed is the ambiguity in some of the test cases. For example, for the test case `STC_015`, it states that "keep the drone on the ground several meters away". In this case, you should try to define what "_several meters_" is referring to. A specific value or a range of values would really help in this case.

WinnieTrandinh, 2023-04-04:
Many test cases have been rewritten, including the one in question.
Ambiguity is also removed with the new test cases.

Closed 2023-04-04.

Thread 40 (2023-01-21):

Team 26 DesignDoc Review: Hardware Specifications

abrahamtaha1, 2023-01-21:
Section 9 of the Sys Design - Wanted to know how exactly that the hardware specifications result in certain performances for the drone, for example a certain amount of thrust is needed hence you selected this propellor and motor.

WinnieTrandinh, 2023-04-04:
General hardware specs were selected based on Table 9. Following the table ensures that there is sufficient power supply, thrust, and mobility of the drone.

Closed 2023-04-04.
