icecap360/DroneCapstone/(commit log)

2022-10-10 Created CAD for flight controller setup.
    Included RPi, Navio, and vibration dampener mounts.
    [FlightControllerAssembly.SLDASM, RPi3B+.SLDPRT, VibroNavio2bot_rev_A.SLDPRT, VibroNavio2top_rev_A.SLDPRT]
2022-10-11 Added ESC, motor, propellor, and battery. Updated Navio2 and RPi3B.
    Updated model for RPI3B and changed visuals for Navio2. Remaining components created/modified to be accurate to chosen hardware components.
    [Esc.SLDPRT, LiPoBattery.SLDPRT, Propellor5.1x3.4x3.SLDPRT, RPi3B+.SLDPRT, VibroNavio2bot_rev_A.SLDPRT, VibroNavio2top_rev_A.SLDPRT]
2022-10-27 Added initial partial revision of frame and updated battery dimensions.
    Only bottom plate created, and clearance issues exist for propellors.
    [BottomPlate.SLDPRT, LiPoBattery.SLDPRT]
2022-11-01 Merged bottom dampening plate into frame's top plate, and added bottom plate and arms.
    Top plate modified to add mounting holes for ESC, arms, and bottom plate. Frame arm incomplete as it only connects to top plate.
    [BottomPlate.SLDPRT, FrameArm.SLDPRT, TopPlate.SLDPRT]
2022-11-08 Revised frame arm and bottom plate. Added capacitor onto ESC. Partial revision of Top Plate.
    Bottom plate removed vertical supports and remade battery slot. Frame arm added vertical supports onto bottom plate. Top plate added extra 10mm length on arms, and updated vibration dampening holes to fit new size.
    [BottomPlate.SLDPRT, Esc.SLDPRT, FrameArm.SLDPRT, TopPlate.SLDPRT]
2022-11-08 Updated top plate and dampening plate to account for larger dampening balls. Added ESC mount.
    Dampening ball slots increased to 10mm diameter, and assembly updated. Mounting extrusion and holes added for ESC within top plate.
    [BottomPlate.SLDPRT, TopPlate.SLDPRT, VibroNavio2top_rev_A.SLDPRT]
2022-11-21 Implemented satellite mast, camera mount, and landing legs.
    Updated design of parts to smoothen sharp edges and reduce weight of parts.
    [BottomPlate.SLDPRT, Camera.SLDPRT, FrameArm.SLDPRT, LandingLeg.SLDPRT, Mast.SLDPRT, TopPlate.SLDPRT, VibroNavio2top_rev_A.SLDPRT]
2022-11-28 Added GPS module and expanded ground plane.
    Ground plane expanded by 10mm to provide better center of gravity.
    [GPS.SLDPRT, Mast.SLDPRT]
2022-12-03 Added 0.15mm tolerances into landing legs and mast.
    Added extrusion on landing leg to help prevent rotation.
    [LandingLeg.SLDPRT, Mast.SLDPRT, TopPlate.SLDPRT]
2022-12-04 Basic StateMachine Framework Implemented
2022-12-10 Adding Socket reconnection modules
2022-12-10 OperatorApp sample code
2022-12-11 Making Drone socket non-blocking
2022-12-12 Revamped frame arm by extending length, revising leg connection, and increasing support on extrusions.
    Frame length extended by 10mm to increase propellor clearance. Leg connection revised to have ground force pointing straight up, and added extra slots for zip ties to prevent rotations. Increased support for extrusions to provide more sturdy wire connections.
    [FrameArm.SLDPRT]
2022-12-22 Integrated radio receiver into frame. Added cover for flight controller. Updated motor dimensions.
    Radio antenna model added, and mounting added to frame. Cover added to provide protection around flight controller and wires. Mast redesigned to fit new cover, and provide a center of mass.
    [Antenna.SLDPRT, LandingLeg.SLDPRT, Mast.SLDPRT, RadioReceiver.SLDPRT, TopCover.SLDPRT, TopPlate.SLDPRT]
2023-01-05 Revised mast connection and cover design.
    Mast connection turned to vertical slot to improve ease of printing. Cover expanded above propellors to increase distance from internal components to walls. Mounting holes in top plate modified to increase distance from dampening plate to mount.
    [Mast.SLDPRT, TopCover.SLDPRT, TopPlate.SLDPRT]
2023-01-13 Splitting launch commands/states, and fixing receive socket
2023-01-14 UserInterface.py with minor changes on buttons
2023-01-18 Increased tolerances for mast and revised mounting positions for TopCover.
    Removed support arms on TopCover to allow for screw clearance, and added cutout on bottom for camera.
    [FrameArm.SLDPRT, Mast.SLDPRT, TopCover.SLDPRT, TopPlate.SLDPRT]
2023-02-23 Updating Message Socket
2023-02-23 Updating Message Socket to match MIS Specs
2023-02-23 Updating main drone file for message socket changes
2023-02-24 Resolving errors from last commit
    [Camera.py]
2023-03-01 Revised landing leg joint. Added steel rod support into mast. Improved structure of arms.
    Landing legs connected through bolt, and decreased size of legs to lower center of gravity. Frame arms modified to thicken leg joint and increased supports. Steel rod added inside of mast/top cover joint to increase lateral strength.
    [FrameArm.SLDPRT, LandingLeg.SLDPRT, Mast.SLDPRT, SteelRod.SLDPRT, TopCover.SLDPRT]
2023-03-01 Updated material and weights for each component. Added nuts/bolts into assembly.
    For printed parts, material selected as custom PLA material. Weight found from component specs or printed specs.
    [Antenna.SLDPRT, BottomPlate.SLDPRT, Esc.SLDPRT, GPS.SLDPRT, LiPoBattery.SLDPRT, Propellor5.1x3.4x3.SLDPRT, RadioReceiver.SLDPRT, TopPlate.SLDPRT]
2023-03-03 Increased leg joint hole to allow for vertical tolerances. Offset battery location to maintain central center of gravity.
    Leg joint hole turned into vertical slot. Battery moved backwards to improve center of gravity.
    [BottomPlate.SLDPRT, FrameArm.SLDPRT, LandingLeg.SLDPRT]
2023-03-06 Added spacers and dampening balls.
    Spacers added between Navio and RPi. Dampening balls added to bottom of FlightController assembly.
    [DampeningBall.SLDPRT, Spacer.SLDPRT]
2023-03-08 Uploading testing code
    [ClassifierResult.csv, SegmenterAccuracy.csv]
2023-03-10 Modified spacing for power cables in bottom plate, and increases tolerances in battery and rod slots.
    Spacing between power cables reduced for better fit with ESC. Increased tolerances for battery slot in lateral direction. Increase hole diameter for steel rod to account for imperfections in rod.
    [BottomPlate.SLDPRT, Mast.SLDPRT]
2023-03-19 Increased hole diameter of spacer.
    Increased from 2.1mm to 2.25mm to account for printing imperfections.
    [Spacer.SLDPRT]
2023-03-19 Added sample test images for parking lot bounds segmentation.
    30 images of various parking lots added, and 6 FPs added.
2023-03-21 Adding DroneCamera to Camera.py
2023-03-26 Compulsive move using GPS, fixed issue with communication lost health
    [Classifier.py, Segmenters.py, VisionApp.py]
2023-03-26 Removed print statements
2023-03-27 GUI Button Changes
2023-03-29 Updated colours of materials.
    Most components changed to black. Front two legs changed to dark green to differentiate forward and backwards of drone.
    [BottomPlate.SLDPRT, FrameArm.SLDPRT, LandingLeg.SLDPRT, Mast.SLDPRT, TopCover.SLDPRT, TopPlate.SLDPRT, VibroNavio2top_rev_A.SLDPRT]
2023-03-29 Increased camera size and added camera mount.
    Camera mount acts as adapter for increased camera size.
    [Camera.SLDPRT, CameraMount.SLDPRT]
2023-03-29 Fixed interference with top cover and increased nut size.
    Corners removed on outer side of mount.
    [CameraMount.SLDPRT]
2023-04-01 Drone Camera Gstream pipeline fixed
    [Camera.py]
2023-04-01 VisionApp.py App PI fix, Hover initial location fix
    [Classifier.py, VisionApp.py]
2023-04-06 Resolving segmenter.py grouping issue, gstramer ui issue
    [Segmenters.py]
2023-04-06 Resolving grouping bug in segmentation
    [Segmenters.py]
2023-04-06 Code cleanup
    [SegmenterAccuracy.csv]
2023-04-10 Resolving user interface bugs from refactor, gps2pixel and debughsv
    [MessageSocket.py, Segmenters.py]
